lmm2024/sar-adc-8b-open/sar-adc/comparator/offset_mc.png

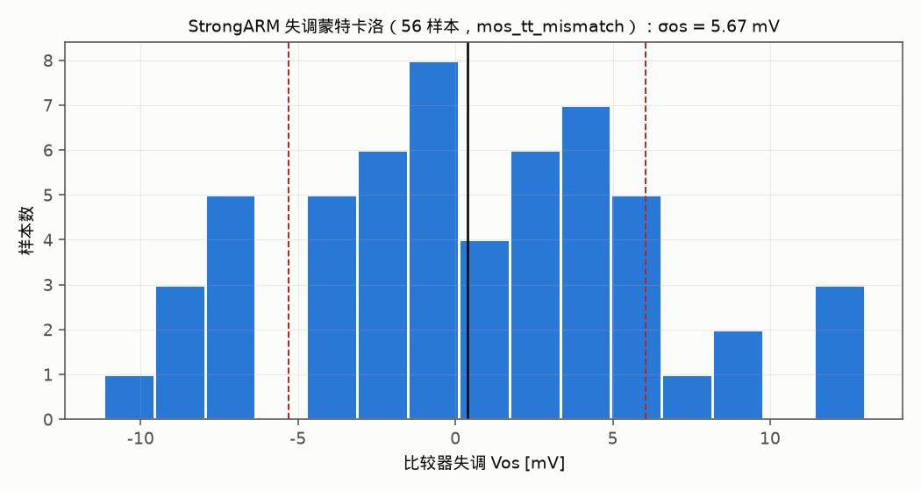
sar-adc/comparator/offset_mc.png
