lmm2024/sar-adc-8b-open/sar-adc/comparator/sar_convergence.png

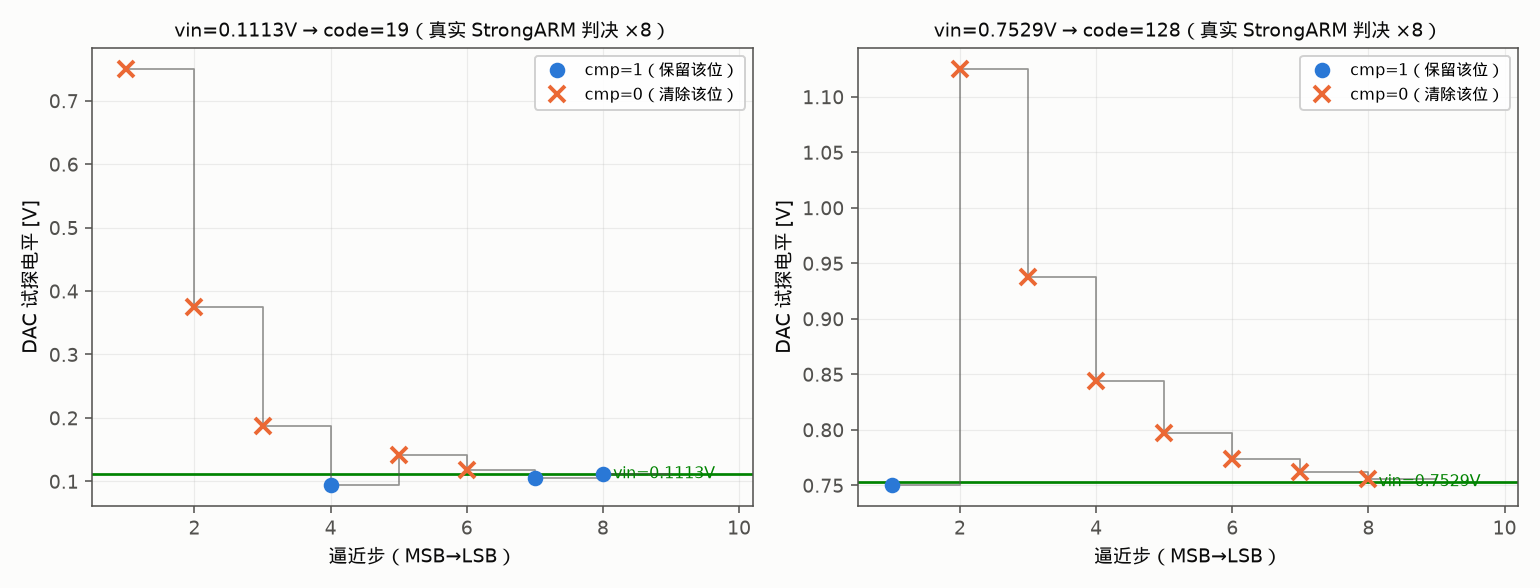
sar-adc/comparator/sar_convergence.png
