lmm2024/sar-adc-8b-open/sar-adc/comparator/strongarm_tran.png

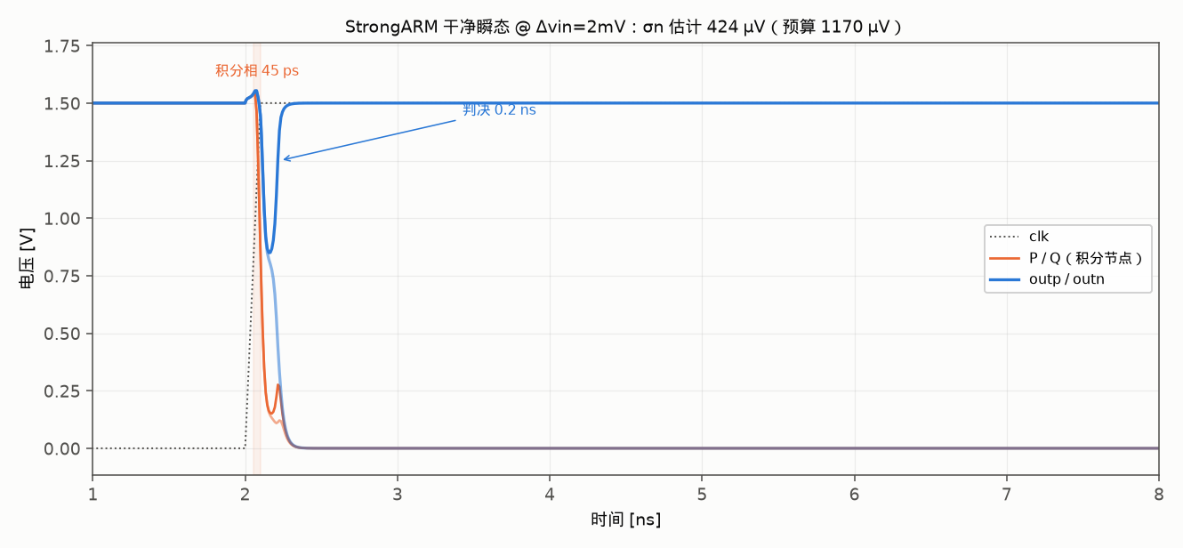
sar-adc/comparator/strongarm_tran.png
