lmm2024/sar-adc-8b-open/sar-adc/core/core_conversion.png

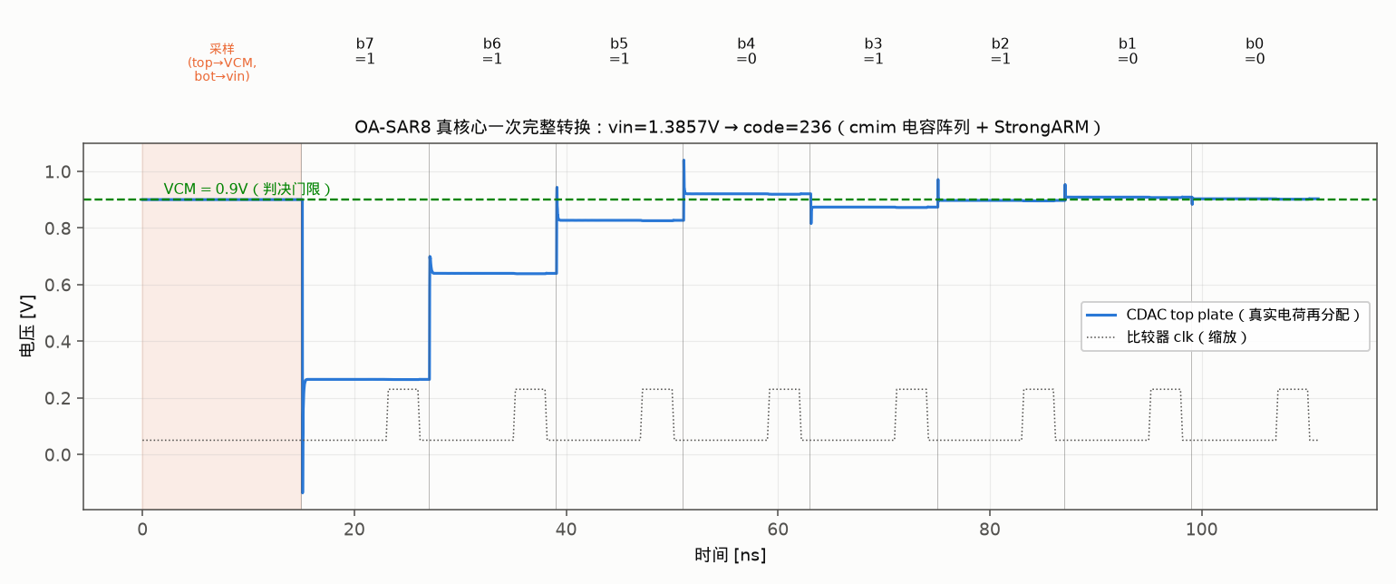
sar-adc/core/core_conversion.png
