lmm2024/sar-adc-8b-open/sar-adc/layout/bs/bstrap.png

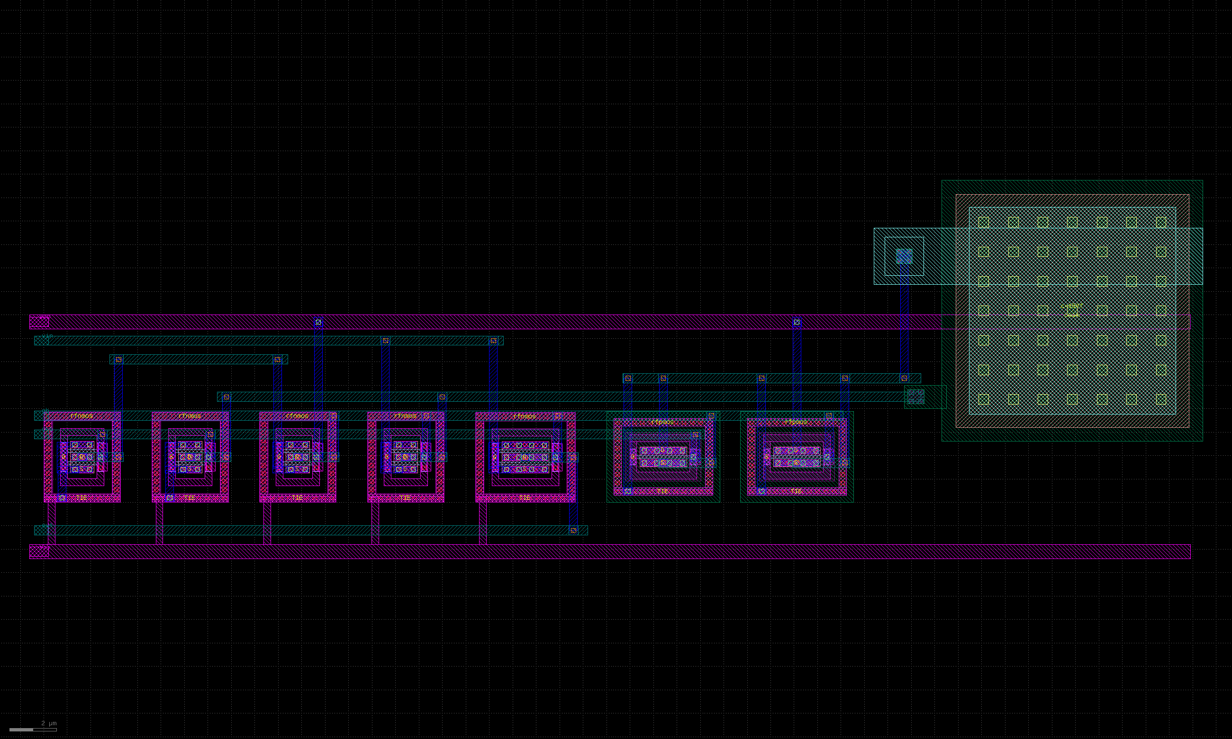
sar-adc/layout/bs/bstrap.png
