lmm2024/sar-adc-8b-open/sar-adc/layout/cdac_array.png

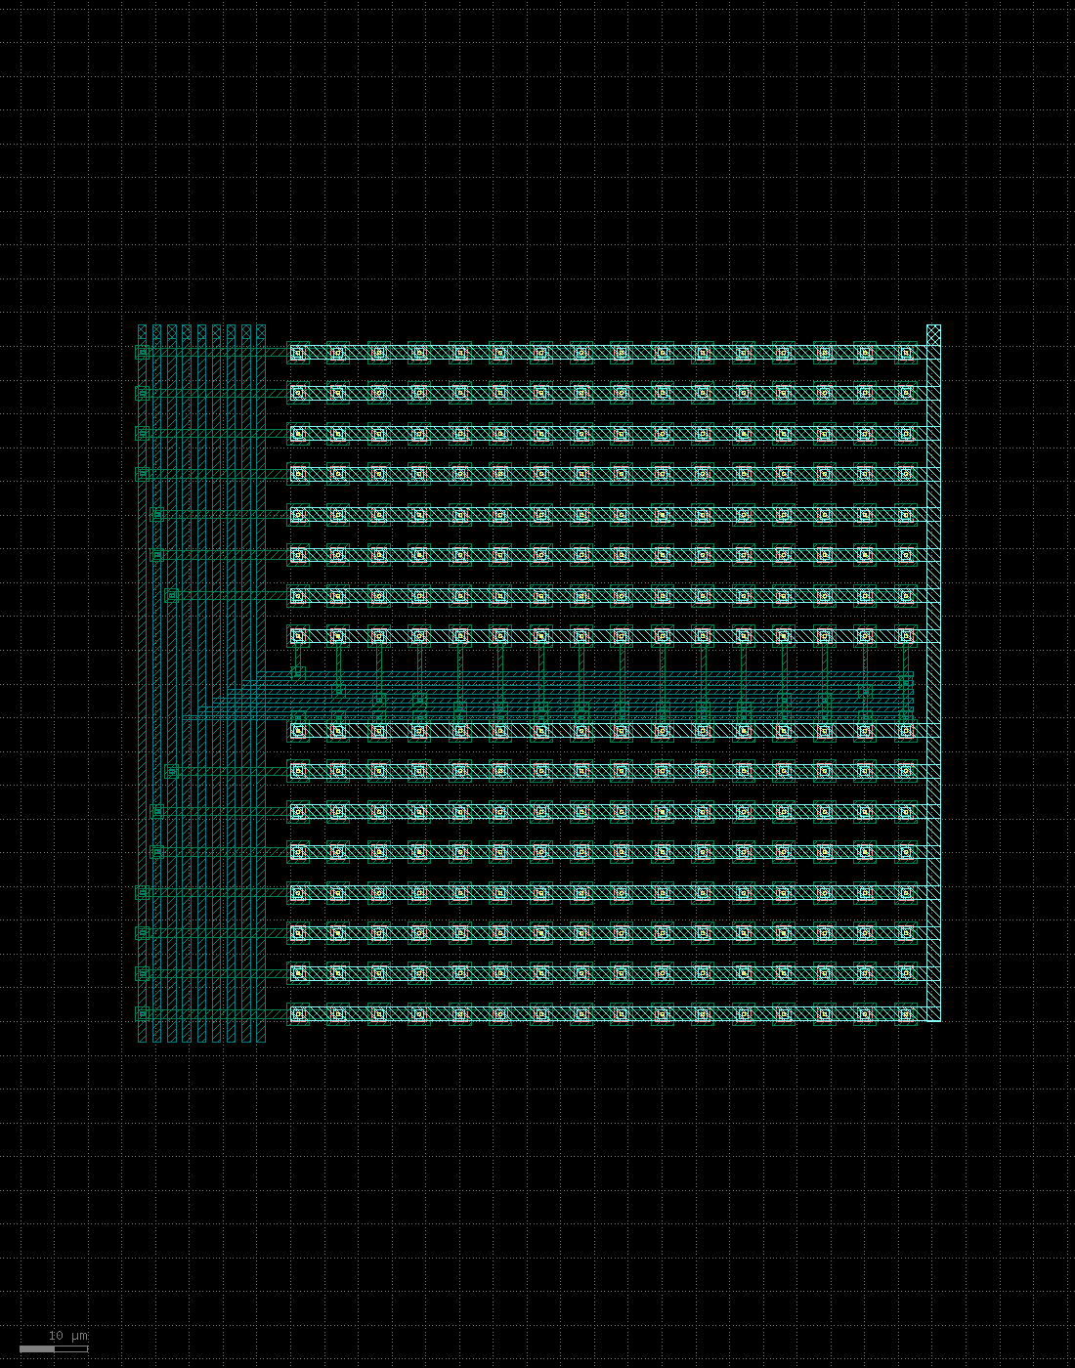
sar-adc/layout/cdac_array.png
