lmm2024/sar-adc-8b-open/sar-adc/layout/channel_zoom.png

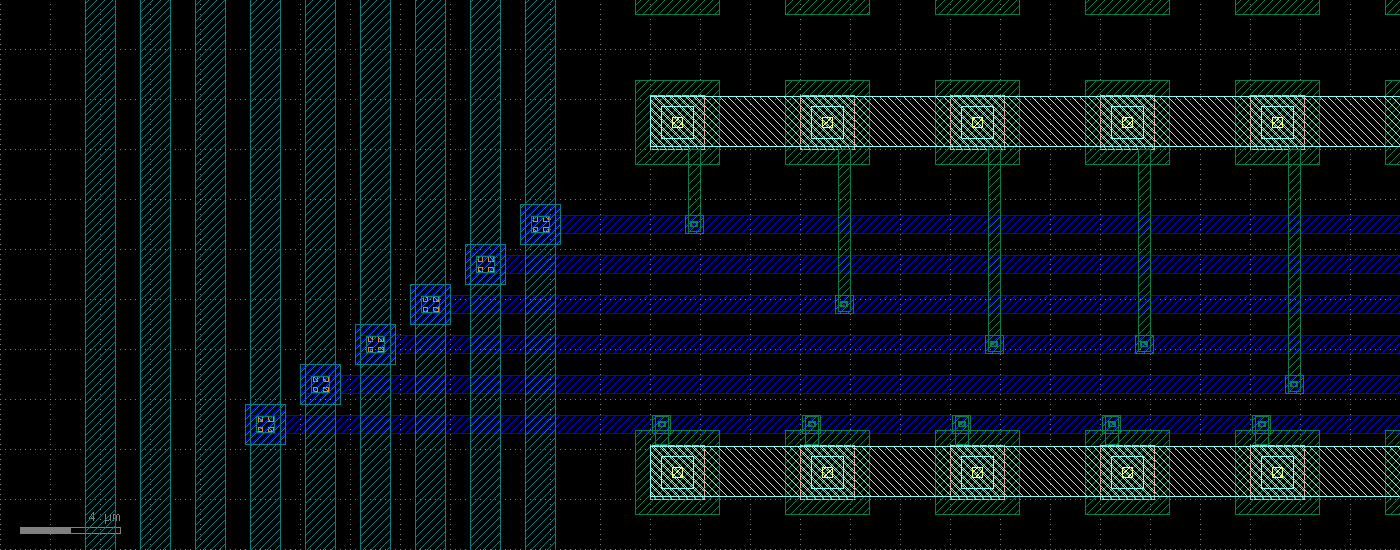
sar-adc/layout/channel_zoom.png
