lmm2024/sar-adc-8b-open/sar-adc/layout/cmp/sa_comp_final.png

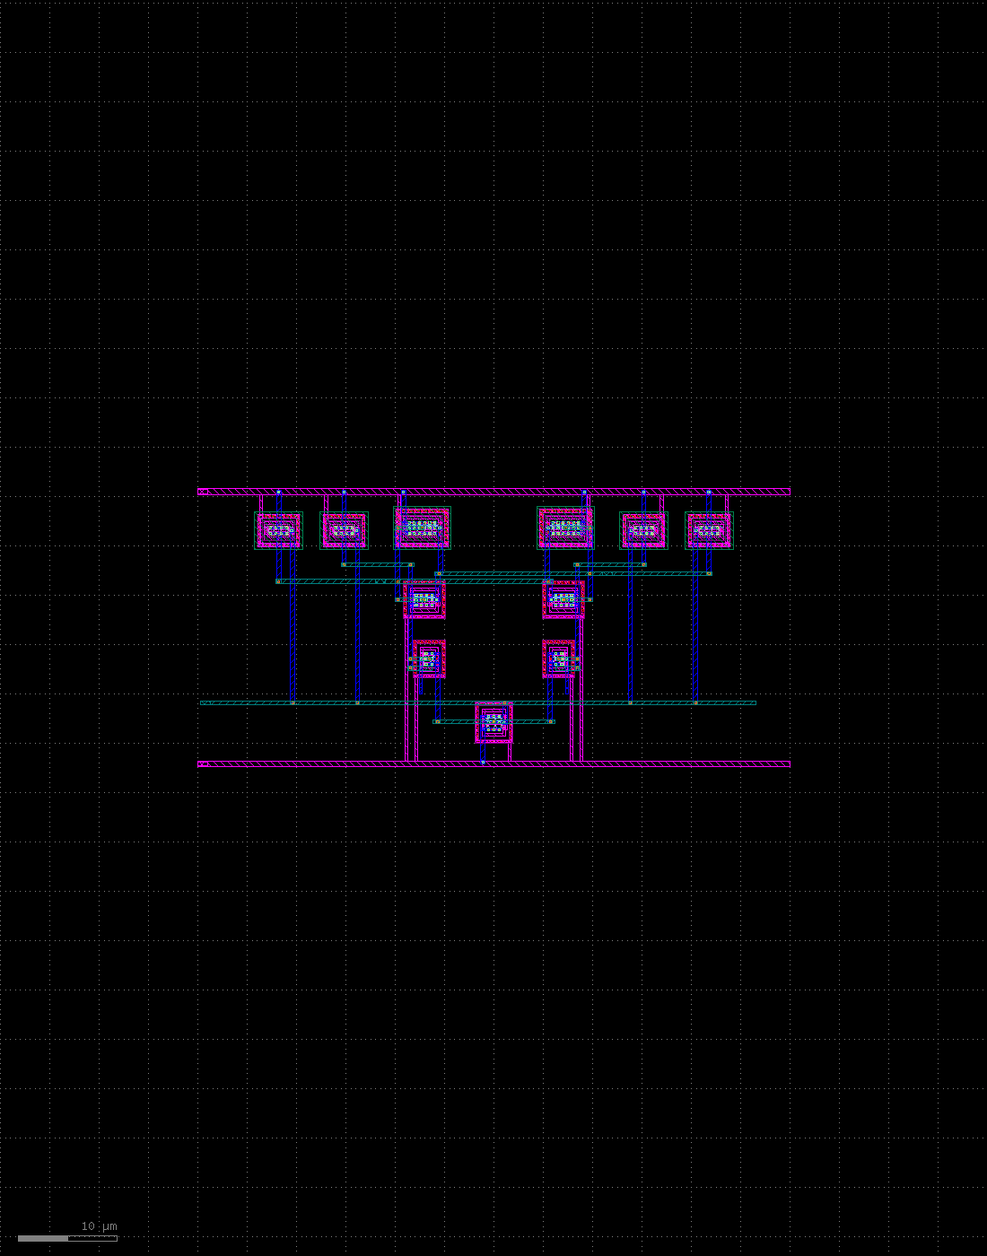
sar-adc/layout/cmp/sa_comp_final.png
