lmm2024/sar-adc-8b-open/sar-adc/layout/oa_sar8_core9.png

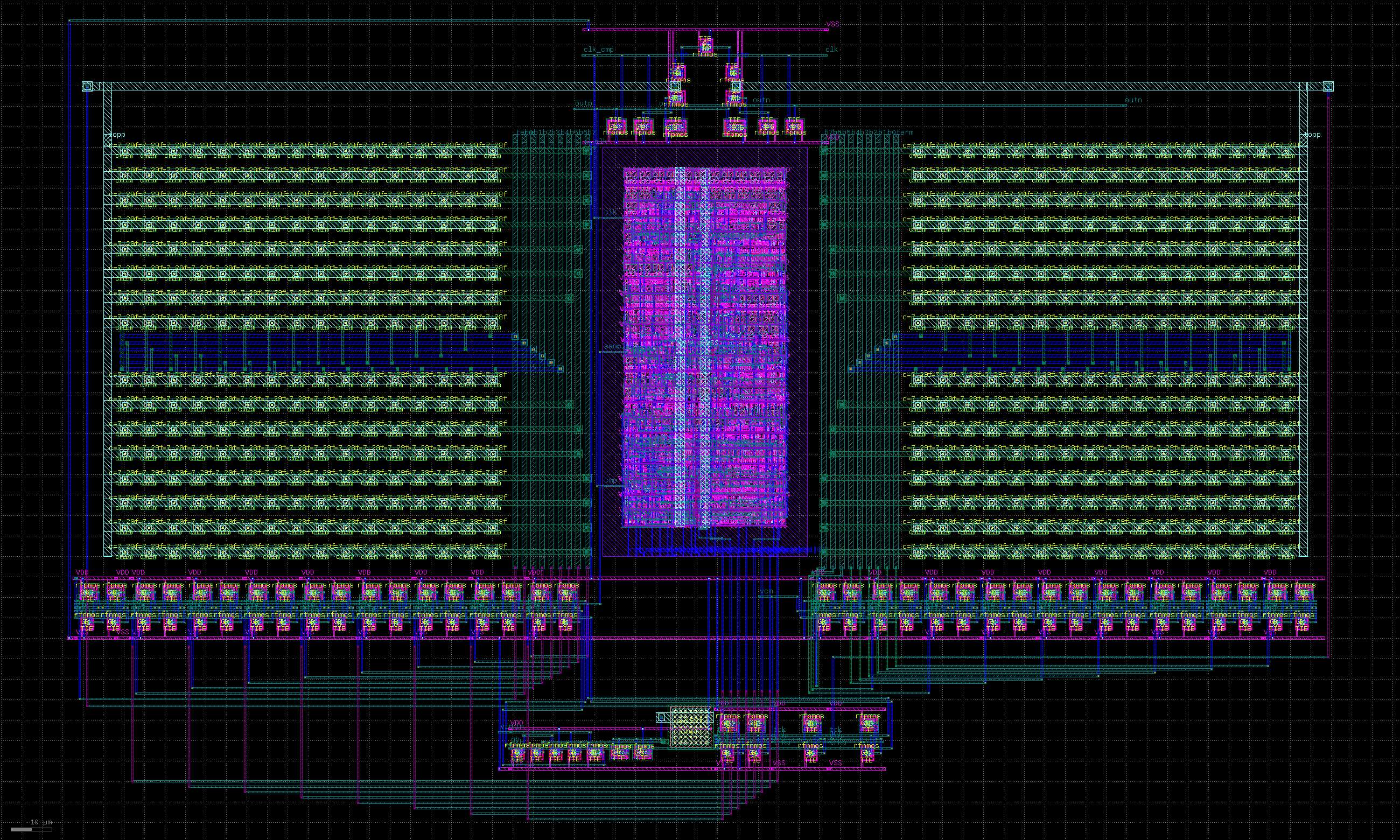
sar-adc/layout/oa_sar8_core9.png
