lmm2024/sar-adc-8b-open/sar-adc/layout/oa_sar8_core_fp.png

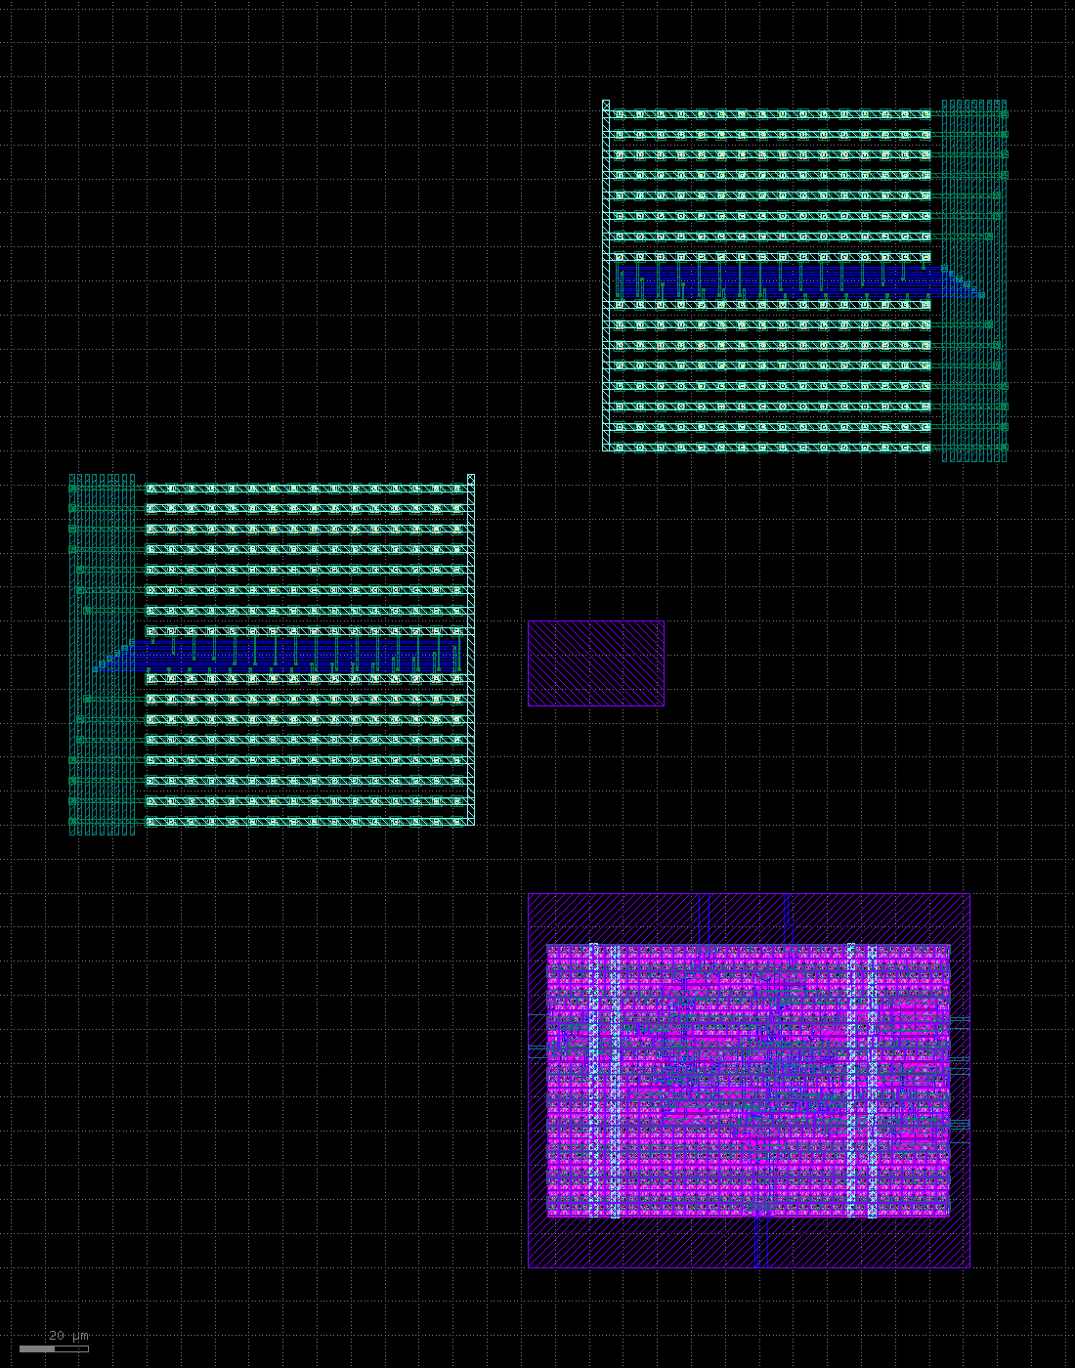
sar-adc/layout/oa_sar8_core_fp.png
