lmm2024/sar-adc-8b-open/sar-adc/layout/oa_sar8_core_v3.png

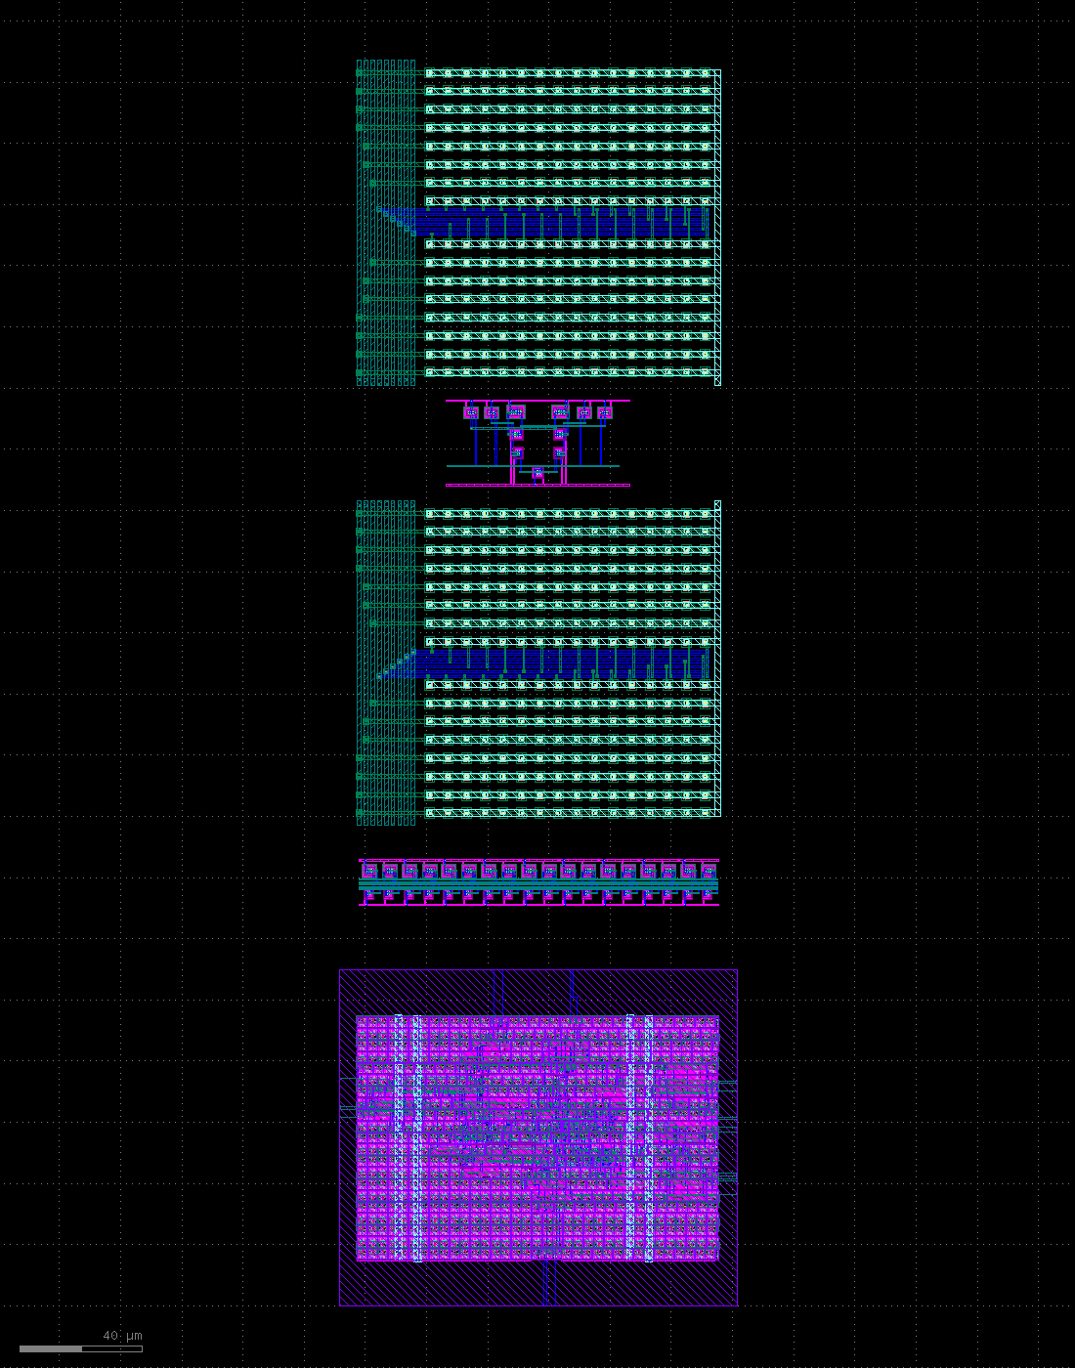
sar-adc/layout/oa_sar8_core_v3.png
