lmm2024/sar-adc-8b-open/sar-adc/layout/sar_ctrl_macro.png

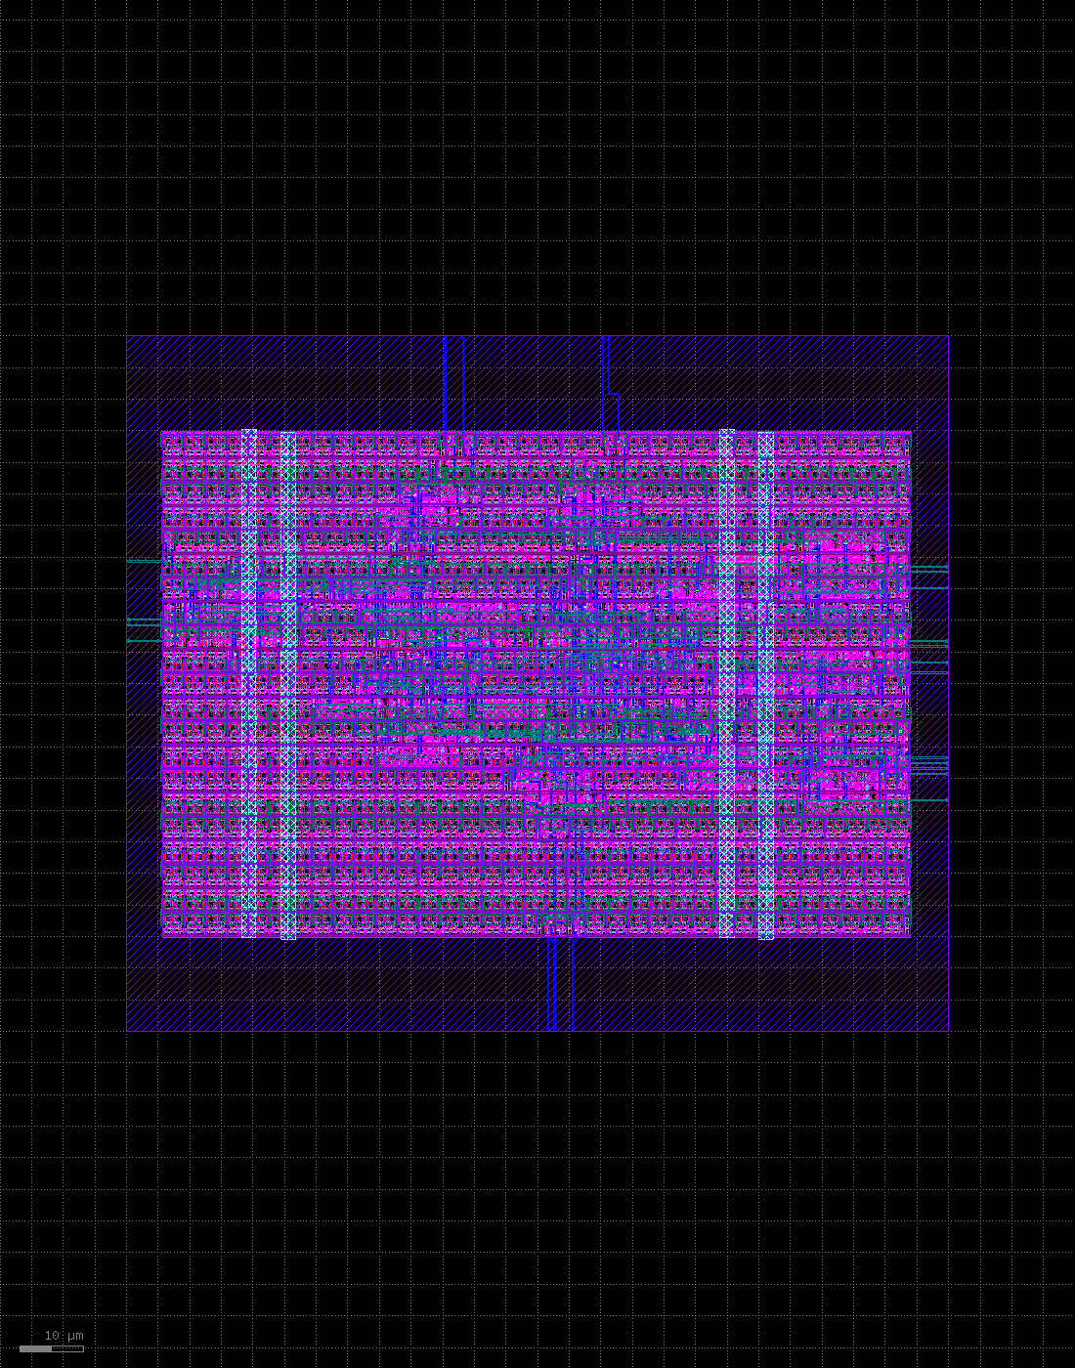
sar-adc/layout/sar_ctrl_macro.png
