lmm2024/sar-adc-8b-open/sar-adc/logic/final/render/sar_ctrl.png

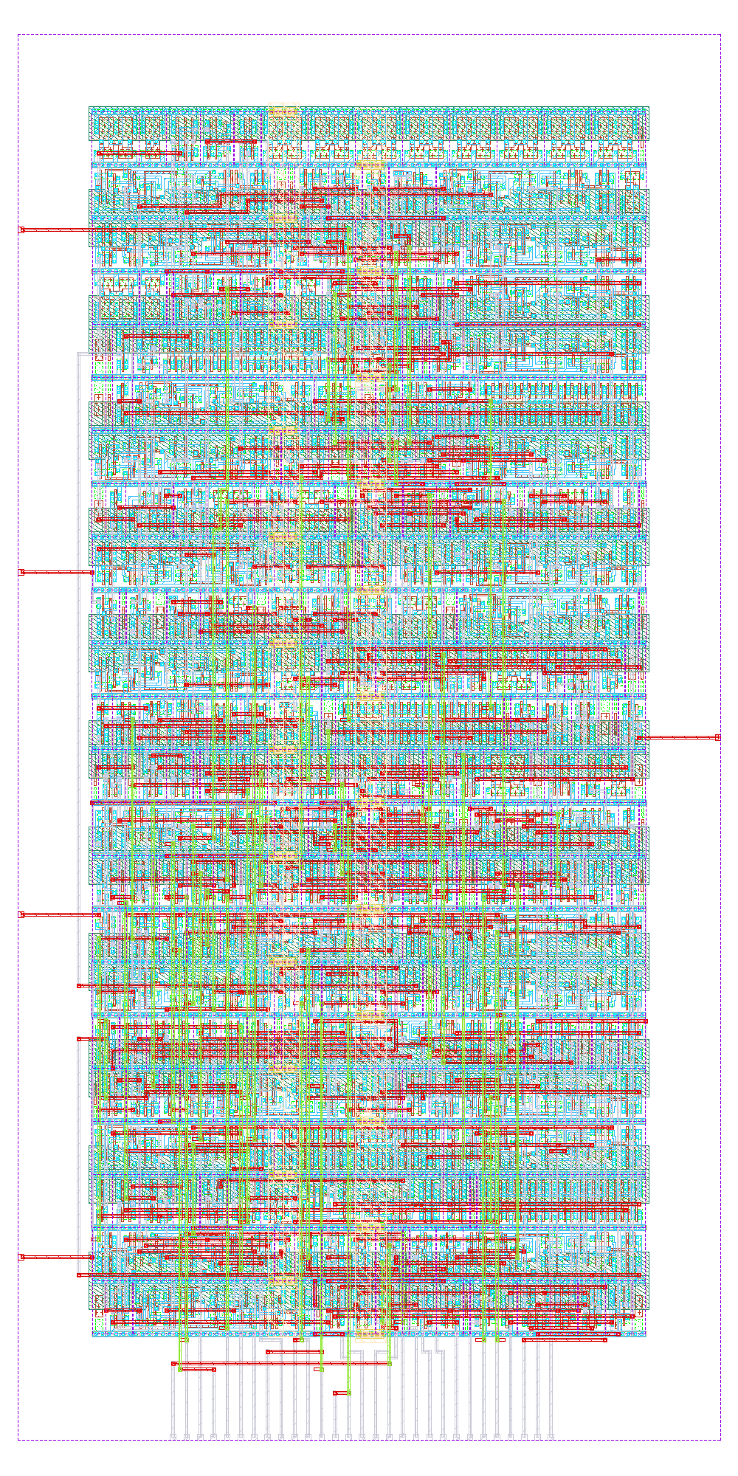
sar-adc/logic/final/render/sar_ctrl.png
