lmm2024/sar-adc-8b-open/sar-adc/logic/final_async_phys/render/sar_ctrl_async_phys.png

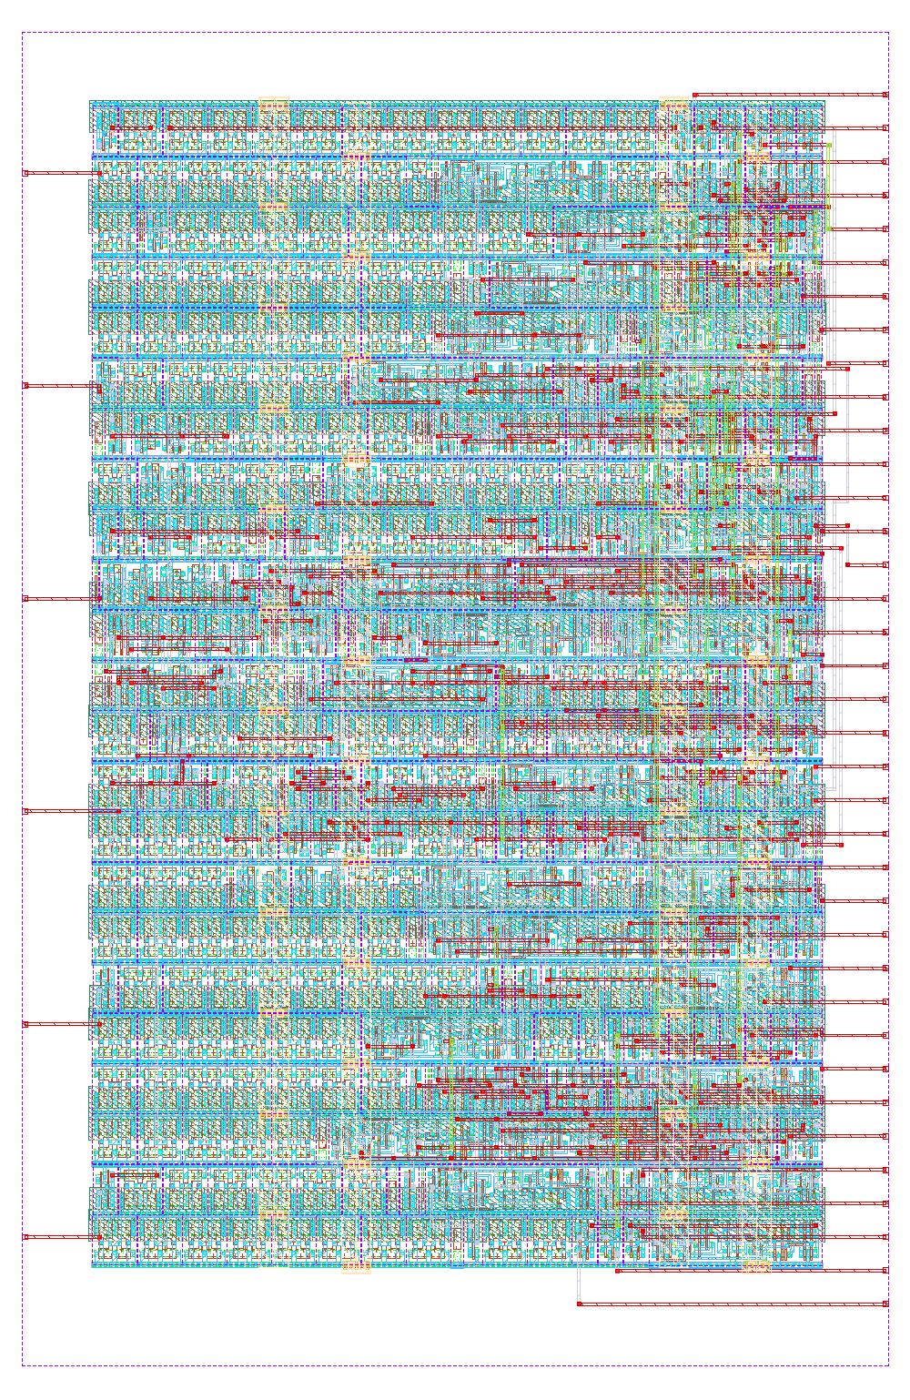
sar-adc/logic/final_async_phys/render/sar_ctrl_async_phys.png
