lmm2024/sar-adc-8b-open/sar-adc/logic/runs/RUN_2026-08-20_POSTDAC_PENDING/final/render/sar_ctrl_async_phys.png

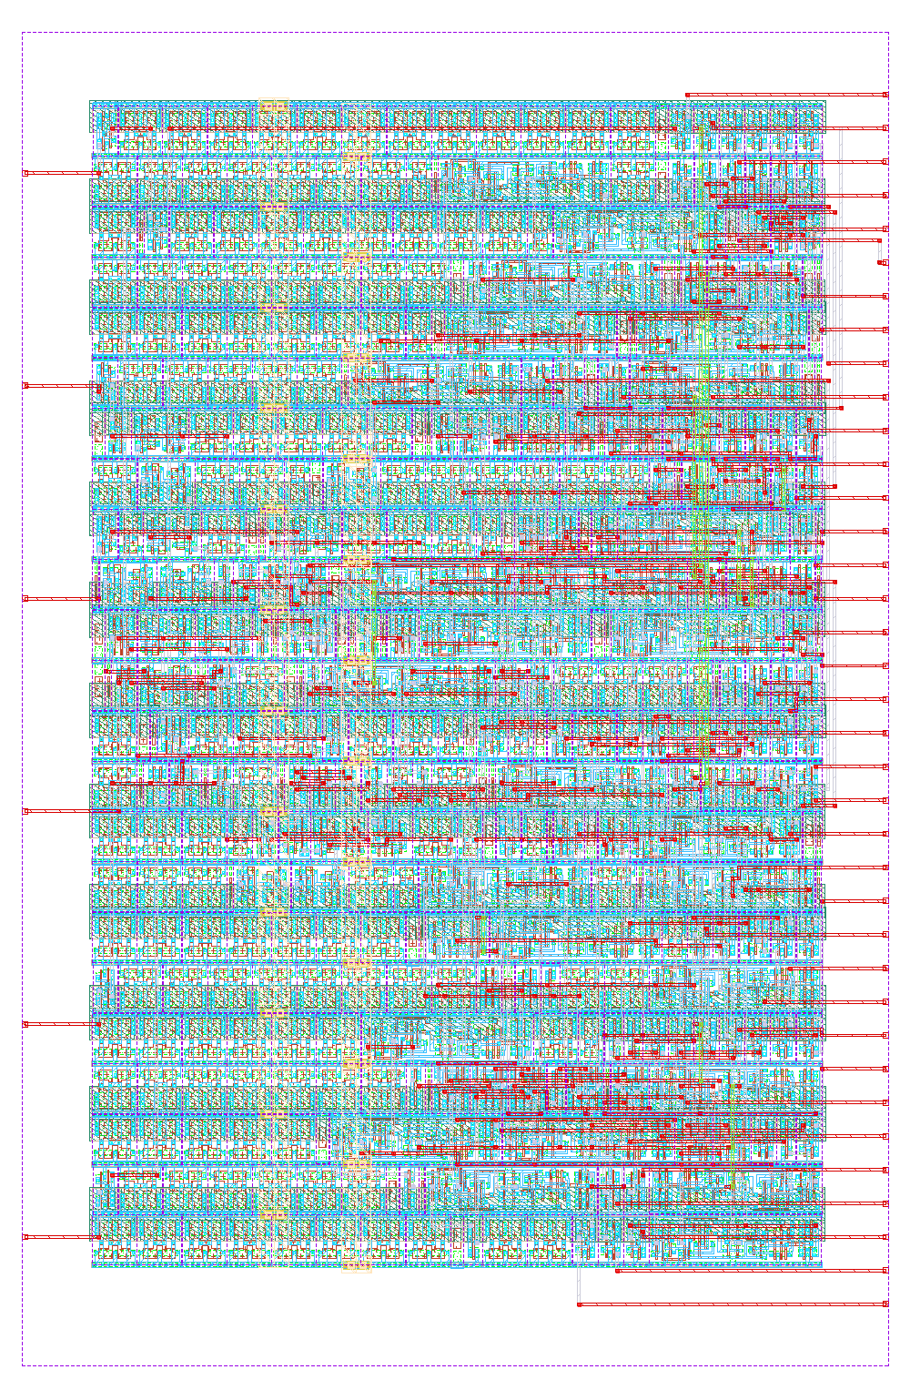
sar-adc/logic/runs/RUN_2026-08-20_POSTDAC_PENDING/final/render/sar_ctrl_async_phys.png
