lmm2024/sar-adc-8b-open/sar-adc/model/dynamic_enob.png

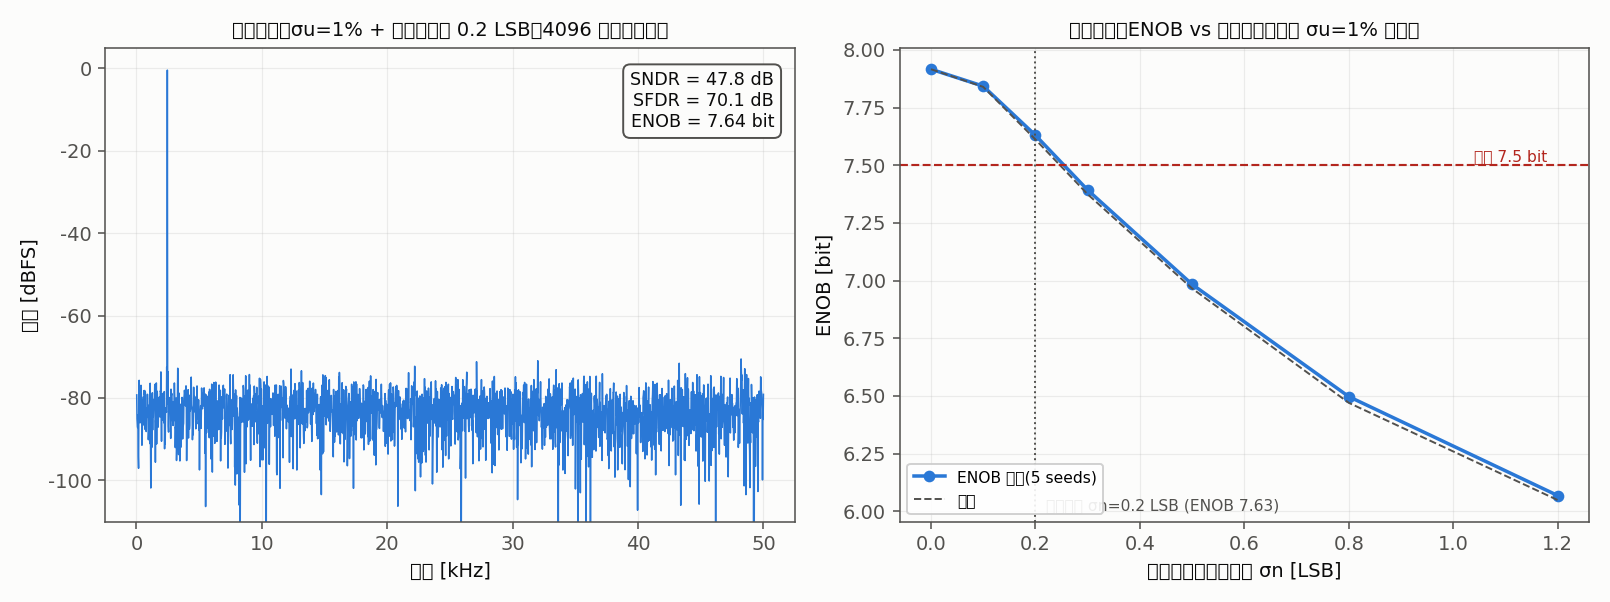
sar-adc/model/dynamic_enob.png
