lmm2024/sar-adc-8b-open/sar-adc/model/mc_inl.png

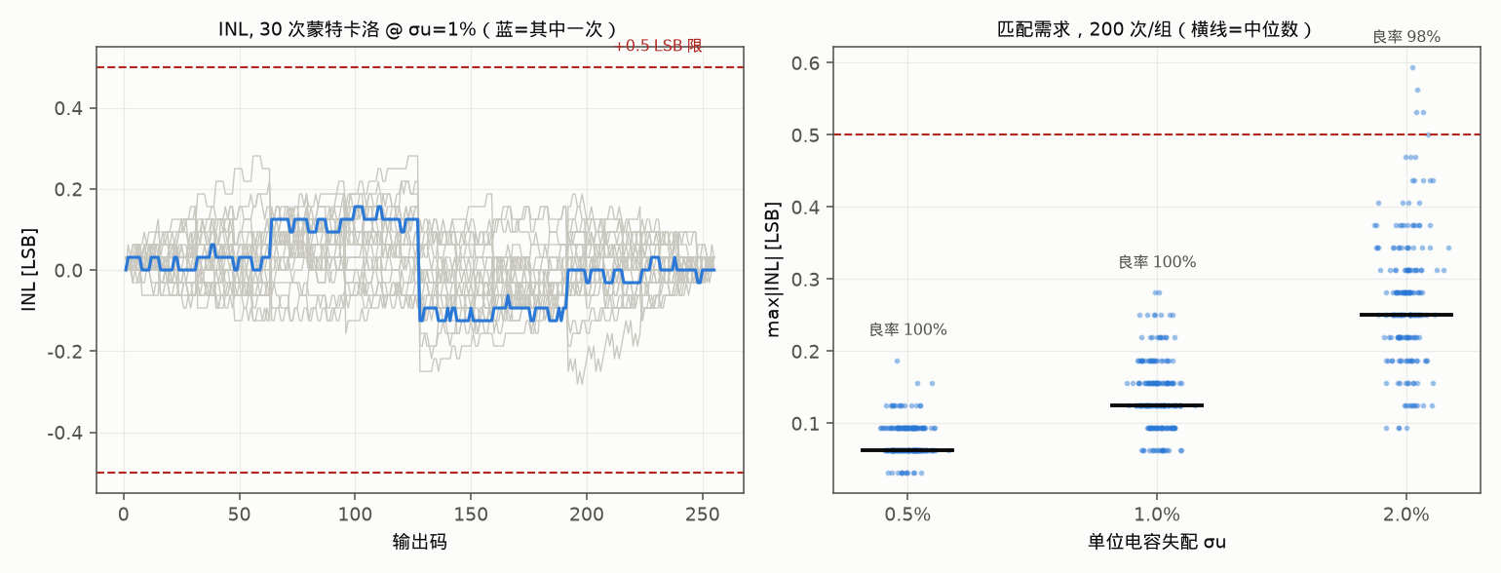
sar-adc/model/mc_inl.png
