lmm2024/sar-adc-8b-open/sar-adc/report/img/01_cdac_array.png

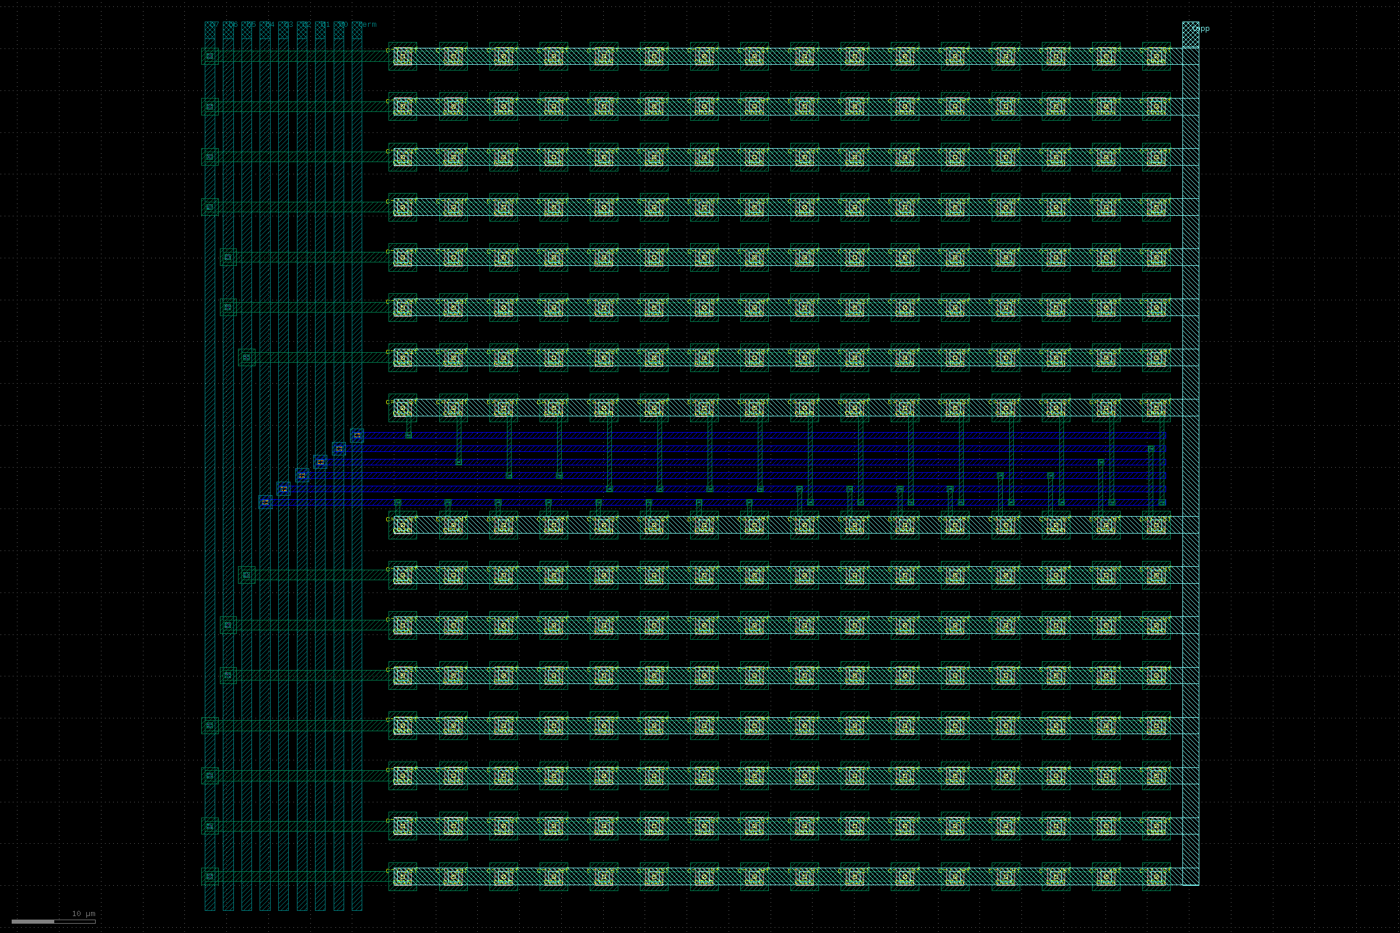
sar-adc/report/img/01_cdac_array.png
