lmm2024/sar-adc-8b-open/sar-adc/report/img/02_comparator.png

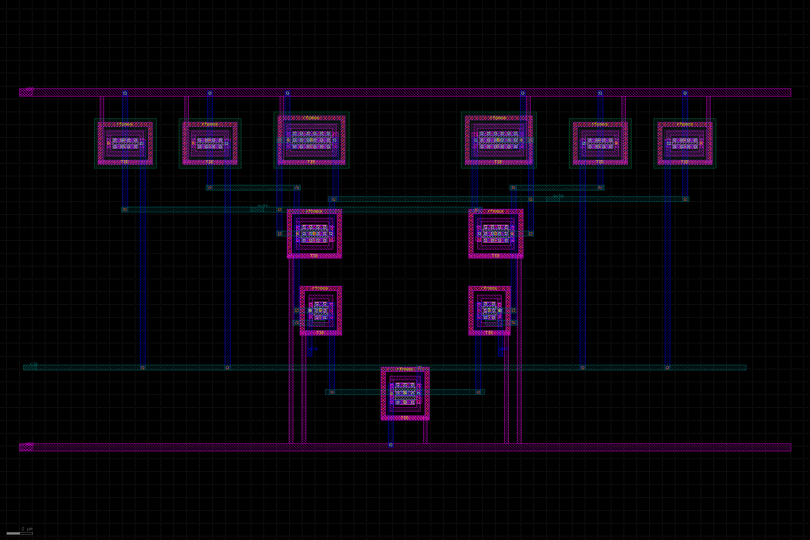
sar-adc/report/img/02_comparator.png
