lmm2024/sar-adc-8b-open/sar-adc/report/img/03_switch_bitcell.png

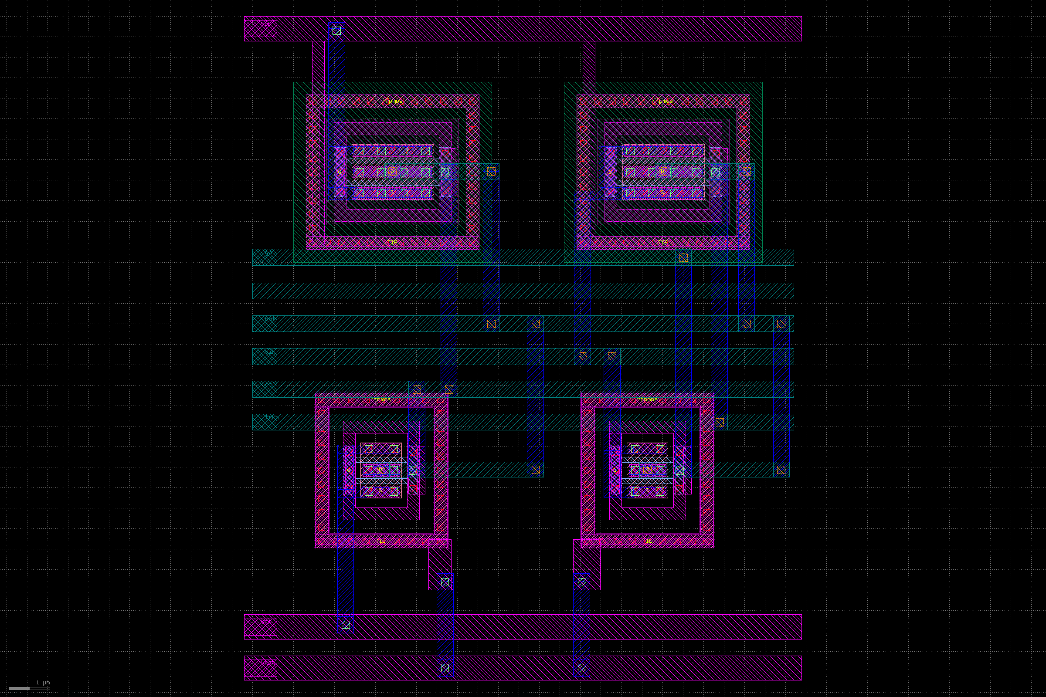
sar-adc/report/img/03_switch_bitcell.png
