lmm2024/sar-adc-8b-open/sar-adc/report/img/04_switch_tg.png

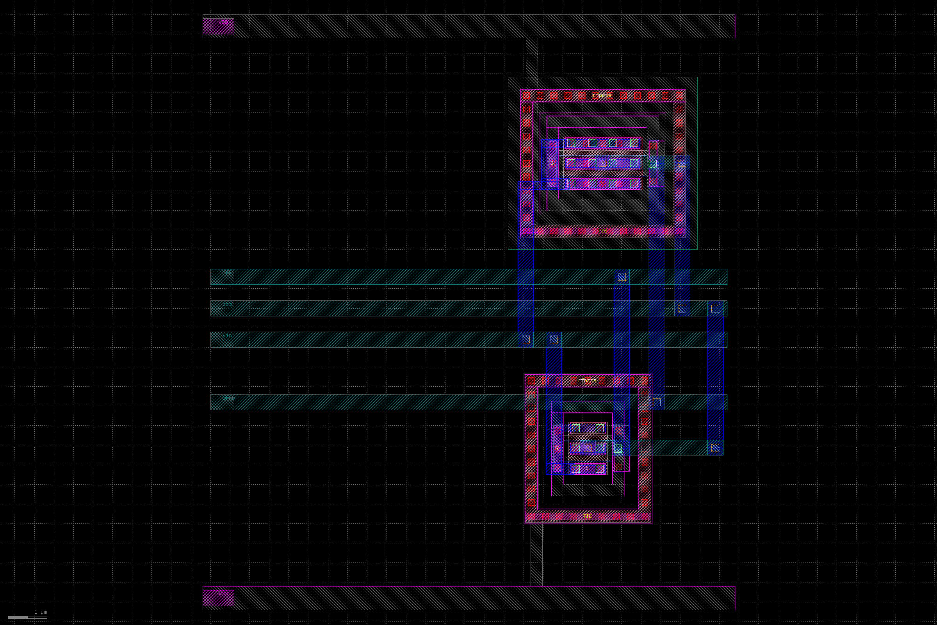
sar-adc/report/img/04_switch_tg.png
