lmm2024/sar-adc-8b-open/sar-adc/report/img/05_bootstrap.png

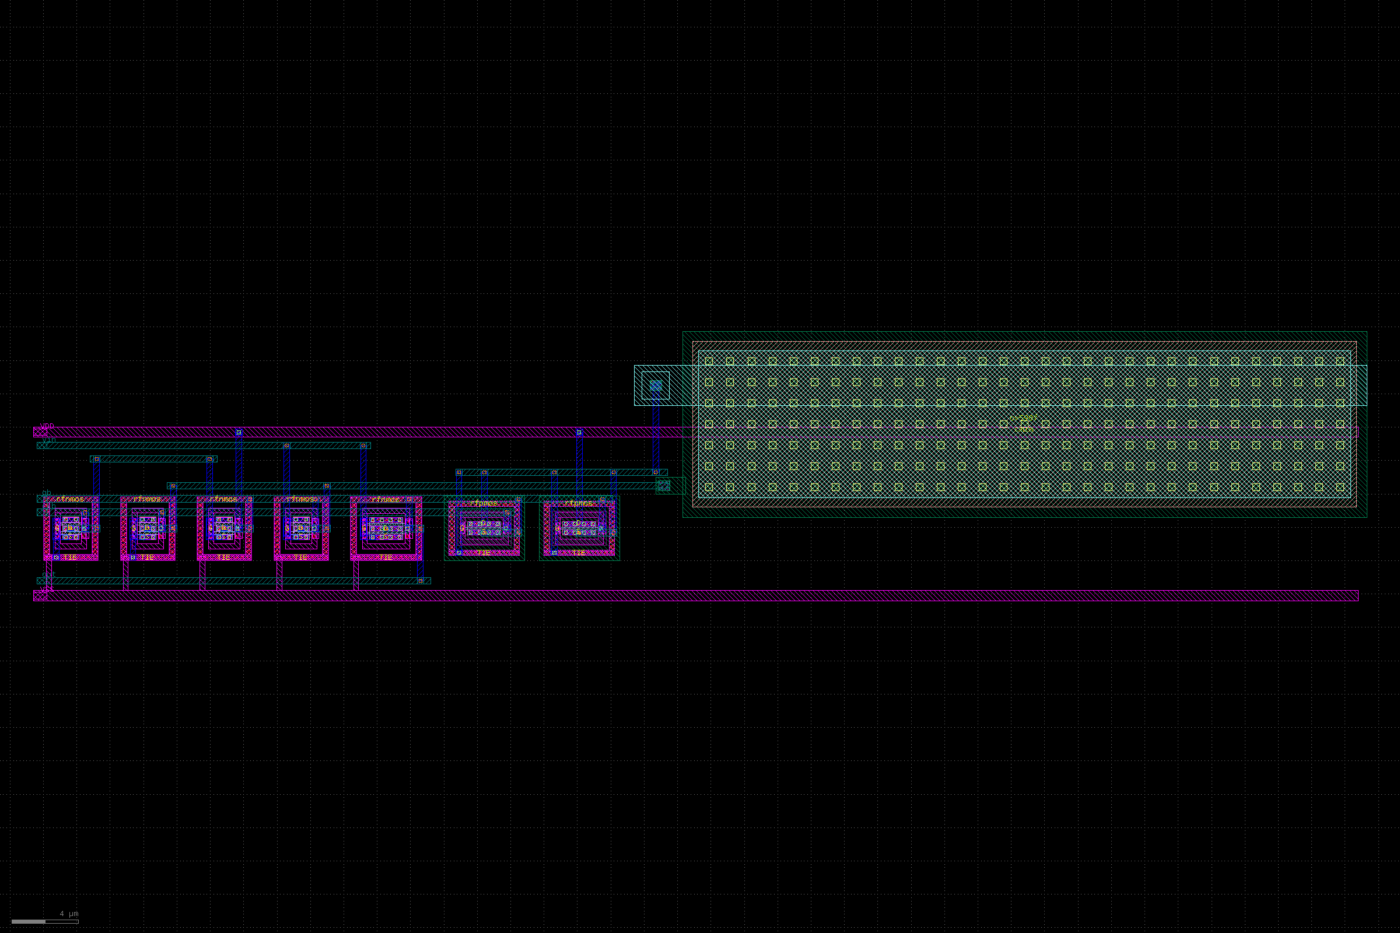
sar-adc/report/img/05_bootstrap.png
