lmm2024/sar-adc-8b-open/sar-adc/report/img/06_sar_logic.png

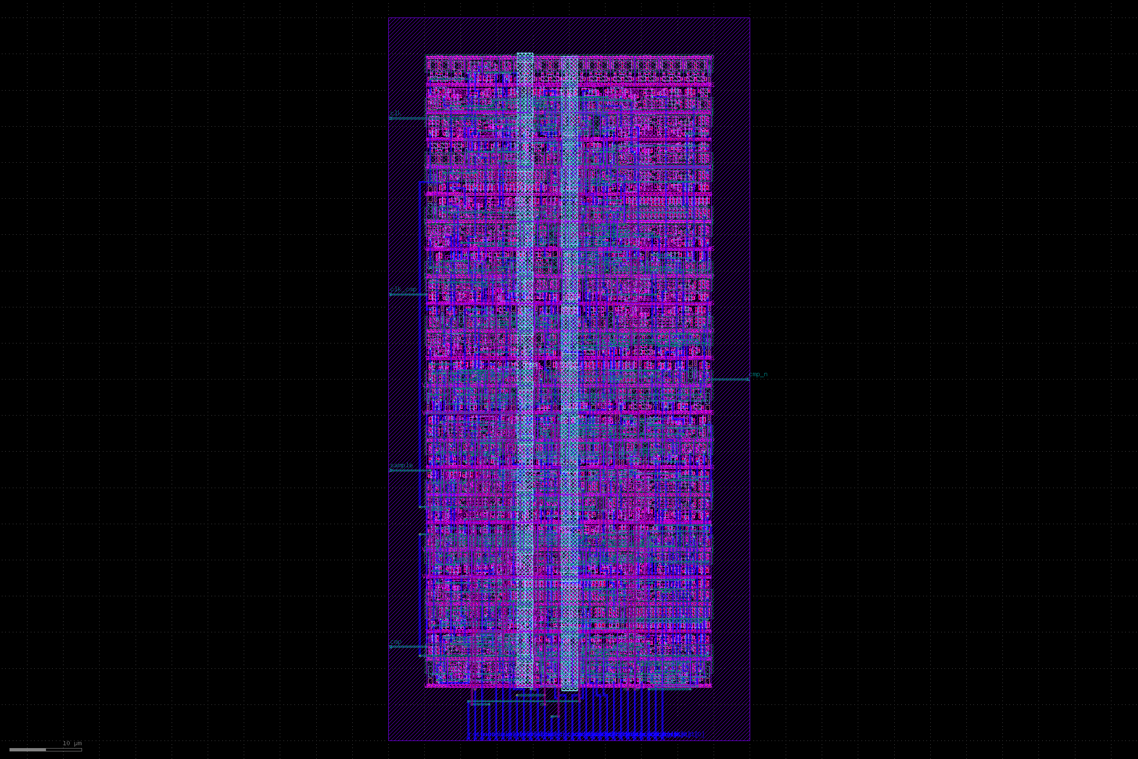
sar-adc/report/img/06_sar_logic.png
