lmm2024/sar-adc-8b-open/sar-adc/report/img/07_analog_core.png

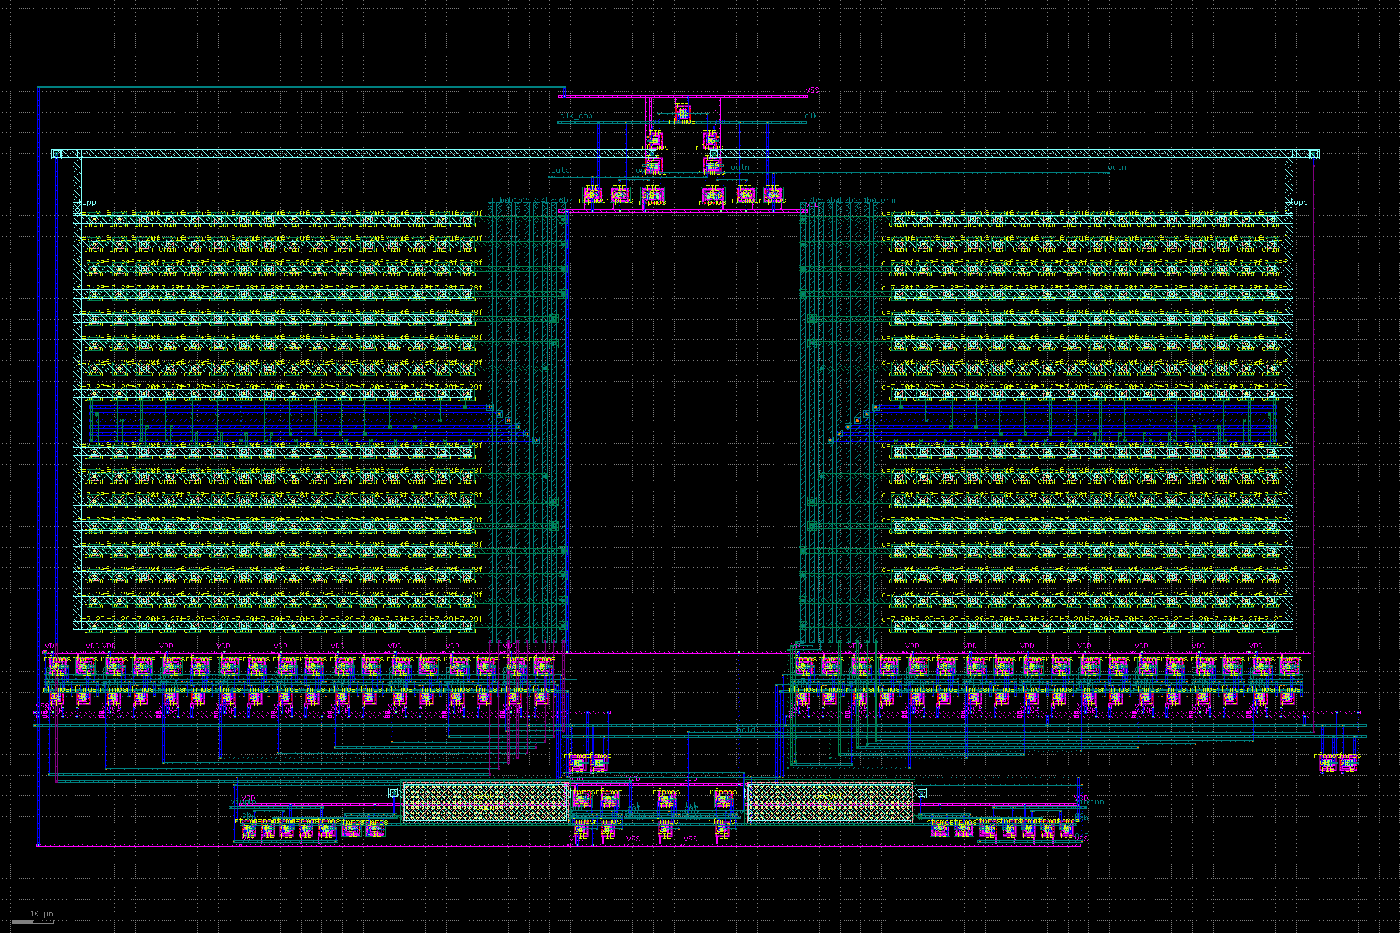
sar-adc/report/img/07_analog_core.png
