lmm2024/sar-adc-8b-open/sar-adc/report/img/08_full_core.png

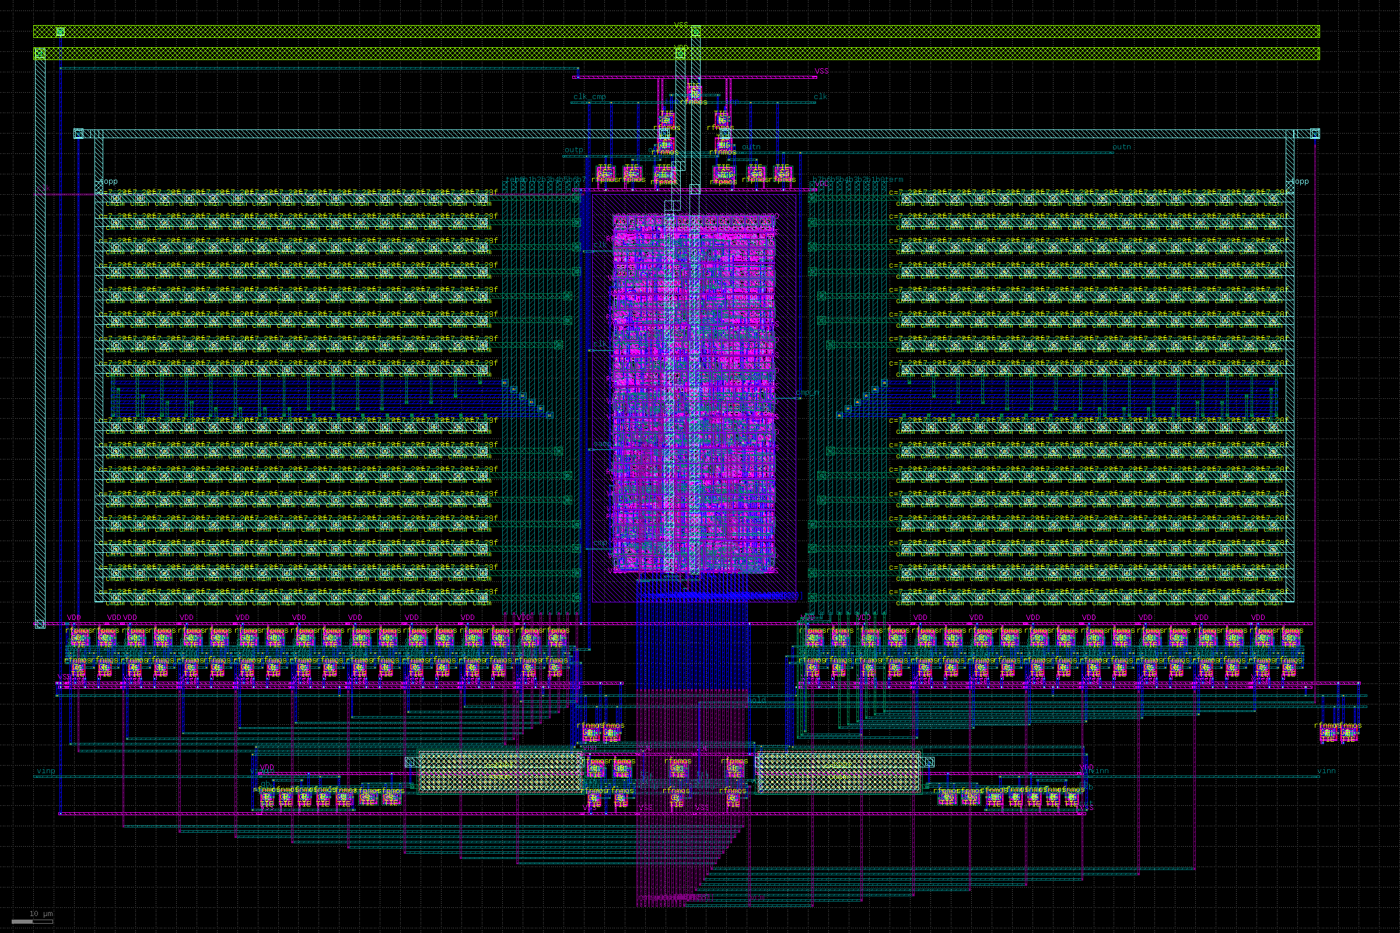
sar-adc/report/img/08_full_core.png
