lmm2024/sar-adc-8b-open/sar-adc/report/img/09_full_chip.png

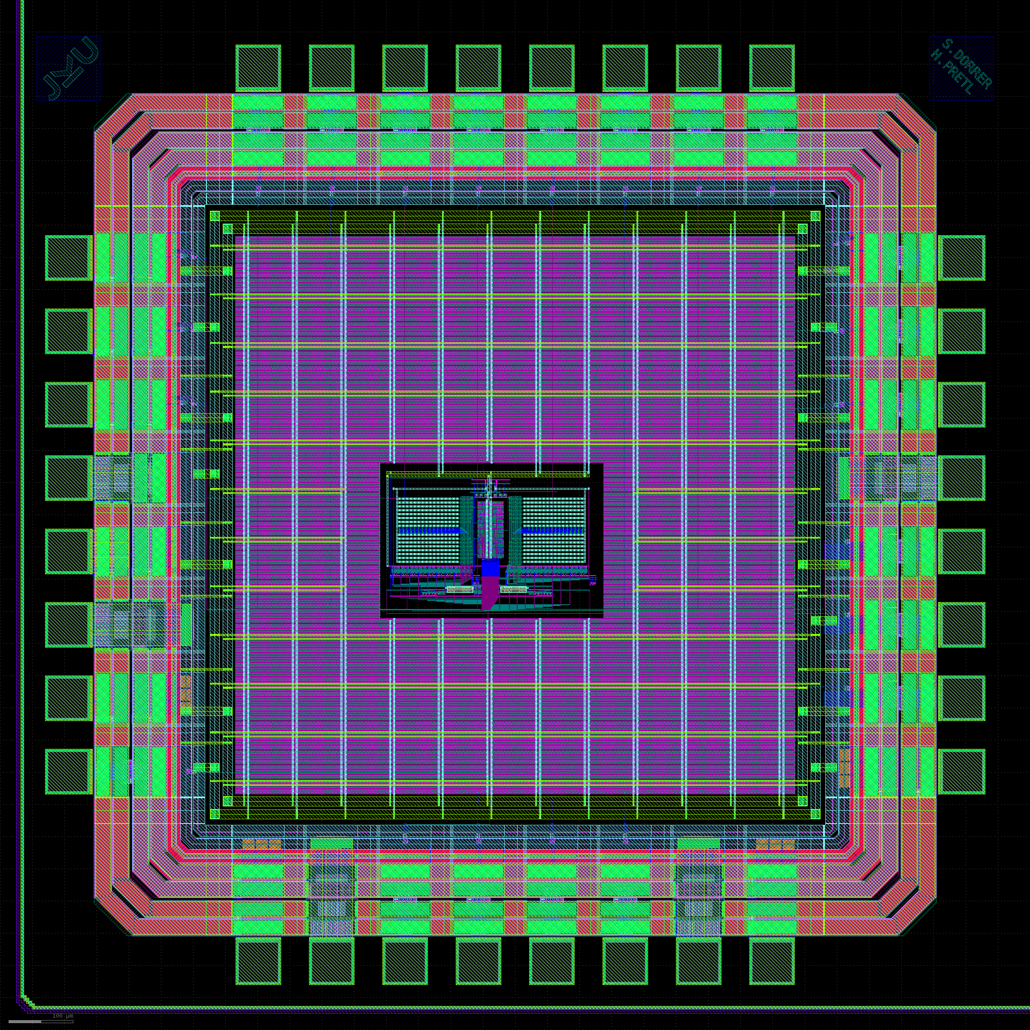
sar-adc/report/img/09_full_chip.png
