lmm2024/sar-adc-8b-open/sar-adc/report/img/10_full_chip_core_zoom.png

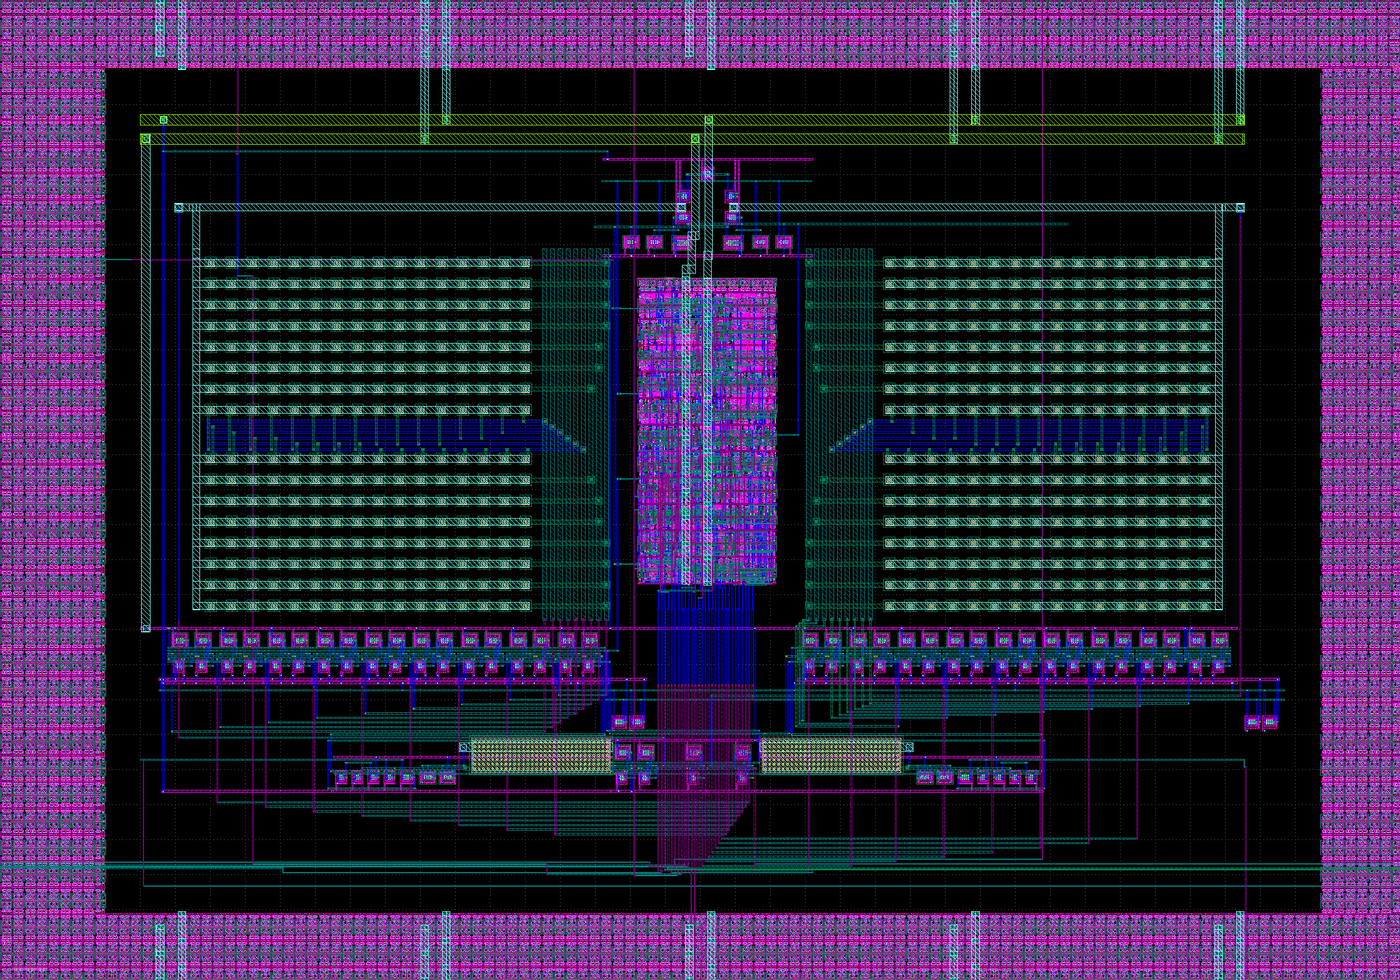
sar-adc/report/img/10_full_chip_core_zoom.png
