lmm2024/sar-adc-8b-open/sar-adc/report/img/11_full_chip_corner_pads.png

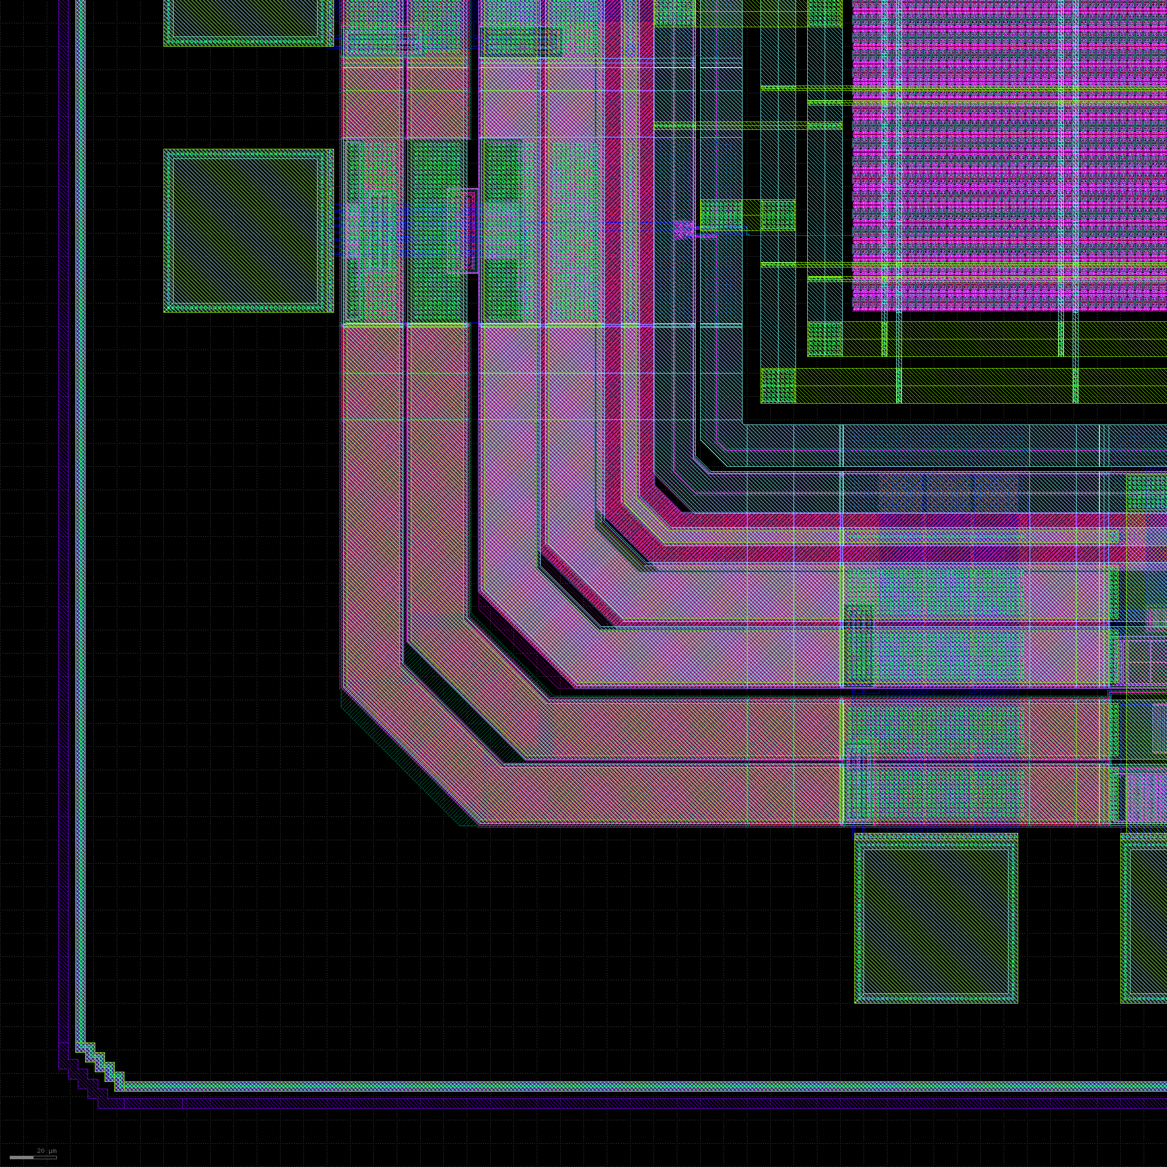
sar-adc/report/img/11_full_chip_corner_pads.png
