lmm2024/sar-adc-8b-open/sar-adc/signoff/core18_pdnfix_20260830/results/samples_pdnfix_m3_lowfreq312k_2cyc.csv

sample | code | track_fall_s | done_rise_s | conversion_ns
0 | 137 | 3.1075e-08 | 6.561811372032166e-08 | 34.543113720321664
1 | 160 | 1.31075e-07 | 1.6552152965079178e-07 | 34.446529650791774
