lmm2024/sar-adc-8b-open/sar-adc/signoff/core18_pdnfix_20260830/results/samples_dc257.csv

index | vdiff_v | code | conversion_ns | best_fit_residual_lsb
0 | -1.4 | 11 | 34.445106392 | 0.857750429825
1 | -1.3890625 | 11 | 34.6363286039 | -0.0826204924894
2 | -1.378125 | 12 | 34.2929404259 | -0.0229914148041
3 | -1.3671875 | 13 | 34.5014485246 | 0.0366376628811
4 | -1.35625 | 14 | 34.4431196337 | 0.0962667405664
5 | -1.3453125 | 15 | 34.3054550637 | 0.155895818252
6 | -1.334375 | 16 | 34.3947405658 | 0.215524895937
7 | -1.3234375 | 17 | 34.342366373 | 0.275153973622
8 | -1.3125 | 18 | 34.3886971842 | 0.334783051308
9 | -1.3015625 | 19 | 34.3889060727 | 0.394412128993
10 | -1.290625 | 20 | 34.4885205702 | 0.454041206678
11 | -1.2796875 | 21 | 34.5897467361 | 0.513670284363
12 | -1.26875 | 22 | 34.4448429624 | 0.573299362049
13 | -1.2578125 | 23 | 34.4942451069 | 0.632928439734
14 | -1.246875 | 24 | 34.3728353923 | 0.692557517419
15 | -1.2359375 | 24 | 34.4381811155 | -0.247813404896
16 | -1.225 | 25 | 34.4939537219 | -0.18818432721
17 | -1.2140625 | 27 | 34.5913504623 | 0.871444750475
18 | -1.203125 | 28 | 34.6906325925 | 0.93107382816
19 | -1.1921875 | 28 | 34.3967779499 | -0.00929709415442
20 | -1.18125 | 29 | 34.6292464781 | 0.0503319835309
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
