lmm2024/sar-adc-8b-open/sar-adc/signoff/core18_pdnfix_20260830/results/samples_pdnfix_m3_signoff32_10m_t25.csv

sample | code | track_fall_s | done_rise_s | conversion_ns
0 | 218 | 3.1075e-08 | 6.567269204133229e-08 | 34.59769204133229
1 | 60 | 1.31075e-07 | 1.6548573866181128e-07 | 34.41073866181128
2 | 181 | 2.31075e-07 | 2.657075510403968e-07 | 34.63255104039683
3 | 103 | 3.31075e-07 | 3.6587253929055536e-07 | 34.79753929055537
4 | 135 | 4.31075e-07 | 4.6571673966560034e-07 | 34.64173966560035
5 | 149 | 5.31075e-07 | 5.657167529386895e-07 | 34.64175293868943
6 | 89 | 6.31075e-07 | 6.657762380757698e-07 | 34.70123807576975
7 | 193 | 7.31075e-07 | 7.655211186032955e-07 | 34.44611860329545
8 | 49 | 8.31075e-07 | 8.656154608521478e-07 | 34.540460852147824
9 | 227 | 9.31075e-07 | 9.65817253785305e-07 | 34.74225378530492
10 | 22 | 1.0310750000000001e-06 | 1.0655656300984808e-06 | 34.49063009848065
11 | 247 | 1.131075e-06 | 1.1656058732982178e-06 | 34.53087329821777
12 | 11 | 1.2310750000000001e-06 | 1.265433782139987e-06 | 34.35878213998683
13 | 249 | 1.331075e-06 | 1.3654700665056138e-06 | 34.395066505613805
14 | 18 | 1.431075e-06 | 1.465564302163999e-06 | 34.489302163998914
15 | 233 | 1.531075e-06 | 1.5655696592732076e-06 | 34.49465927320757
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
