lmm2024/sar-adc-8b-open/sar-adc/signoff/core18_pdnfix_20260830/results/samples_pdnfix_m3_signoff32_lowfreq312k.csv

sample | code | track_fall_s | done_rise_s | conversion_ns
0 | 137 | 3.1075e-08 | 6.561811372032166e-08 | 34.543113720321664
1 | 160 | 1.31075e-07 | 1.6552152965079178e-07 | 34.446529650791774
2 | 183 | 2.31075e-07 | 2.658883819123734e-07 | 34.8133819123734
3 | 203 | 3.31075e-07 | 3.6581346939303345e-07 | 34.73846939303346
4 | 220 | 4.31075e-07 | 4.6576429782500456e-07 | 34.68929782500458
5 | 234 | 5.31075e-07 | 5.655153346385557e-07 | 34.44033463855562
6 | 244 | 6.31075e-07 | 6.65454994331054e-07 | 34.37999433105393
7 | 250 | 7.31075e-07 | 7.654192238310245e-07 | 34.34422383102449
8 | 250 | 8.31075e-07 | 8.654576749570154e-07 | 34.38267495701539
9 | 247 | 9.31075e-07 | 9.655633664088982e-07 | 34.48836640889816
10 | 239 | 1.0310750000000001e-06 | 1.0657118376850234e-06 | 34.636837685023245
11 | 226 | 1.131075e-06 | 1.165616433200082e-06 | 34.541433200082
12 | 211 | 1.2310750000000001e-06 | 1.26581742496238e-06 | 34.742424962379786
13 | 192 | 1.331075e-06 | 1.3653207119182707e-06 | 34.24571191827068
14 | 170 | 1.431075e-06 | 1.4656895574853883e-06 | 34.61455748538824
15 | 148 | 1.531075e-06 | 1.5656170080217223e-06 | 34.54200802172234
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
