lmm2024/sar-adc-8b-open/sar-adc/signoff/core18_pdnfix_20260830/results/dc_transfer_257.png

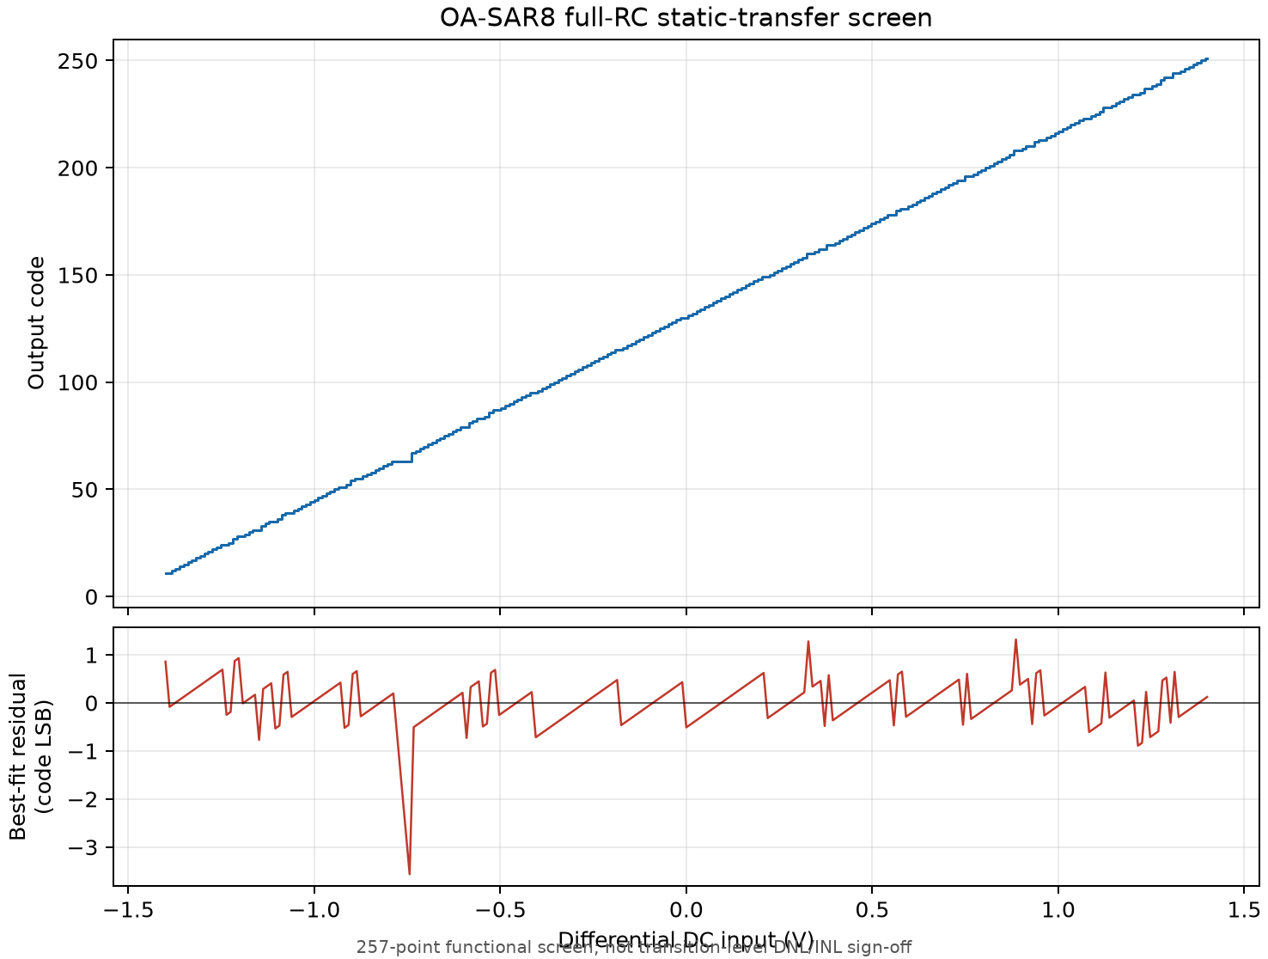
sar-adc/signoff/core18_pdnfix_20260830/results/dc_transfer_257.png
