lmm2024/sar-adc-8b-open/sar-adc/signoff/core18_pdnfix_20260830/results/fft_10m_lowfreq312k.png

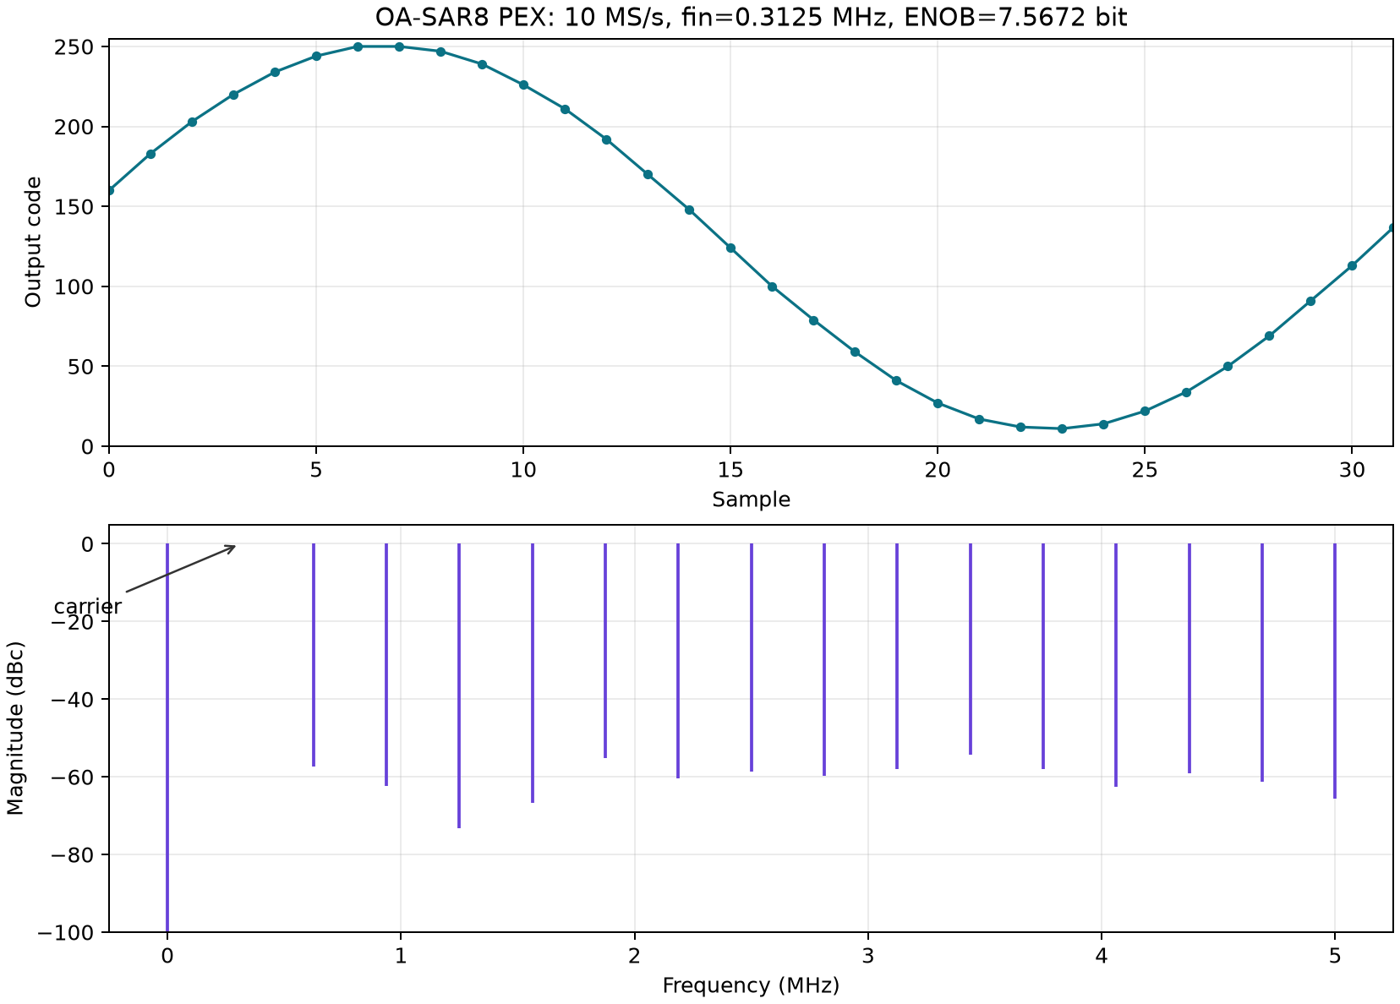
sar-adc/signoff/core18_pdnfix_20260830/results/fft_10m_lowfreq312k.png
