lmm2024/sar-adc-8b-open/sar-adc/layout/pex_a13/oa_sar8_acore13.pex.spice

* PEX produced on Sun Aug 16 09:02:53 AM CEST 2026 using /foss/tools/sak/sak-pex.sh with m=2 and s=1
* NGSPICE file created from oa_sar8_acore13.ext - technology: ihp-sg13g2

.subckt oa_sar8_acore13 vinp vinn ctl0 ctl1 ctl2 ctl3 ctl4 ctl5 ctl6 ctl7 vcm trk
+ clk_cmp outp outn ctl0n ctl1n ctl2n ctl3n ctl4n ctl5n ctl6n ctl7n hold VSS VDD
X0 VDD ctl6 sw_bitcell11_10.bot VDD sg13_lv_pmos ad=0.7p pd=4.7u as=0.39p ps=2.39u w=2u l=0.13u
X1 bstrap40_0.out bstrap40_1.ckb sw_bitcell11_4.bot VDD sg13_lv_pmos ad=0.7p pd=4.7u as=0.39p ps=2.39u w=2u l=0.13u
X2 sw_tg_0.bot sw_bitcell11_8.bot cap_cmim l=2.14u w=2.14u
X3 cdac_array_1.topp sw_bitcell11_13.bot cap_cmim l=2.14u w=2.14u
X4 outp outn a_26184_21025# VSS sg13_lv_nmos ad=0.39p pd=2.39u as=0.7p ps=4.7u w=2u l=0.13u
X5 cdac_array_1.topp sw_bitcell11_9.bot cap_cmim l=2.14u w=2.14u
X6 sw_tg_0.bot sw_bitcell11_5.bot cap_cmim l=2.14u w=2.14u
X7 cdac_array_1.topp sw_bitcell11_10.bot cap_cmim l=2.14u w=2.14u
X8 sw_bitcell11_8.bot ctl7n sw_bitcell11_8.VSS VSS sg13_lv_nmos ad=0.195p pd=1.39u as=0.35p ps=2.7u w=1u l=0.13u
X9 cdac_array_1.topp sw_bitcell11_10.bot cap_cmim l=2.14u w=2.14u
X10 sw_tg_0.bot sw_bitcell11_7.bot cap_cmim l=2.14u w=2.14u
X11 cdac_array_1.topp sw_bitcell11_9.bot cap_cmim l=2.14u w=2.14u
X12 cdac_array_1.topp sw_bitcell11_12.bot cap_cmim l=2.14u w=2.14u
X13 sw_tg_0.bot sw_bitcell11_8.bot cap_cmim l=2.14u w=2.14u
X14 cdac_array_1.topp sw_bitcell11_11.bot cap_cmim l=2.14u w=2.14u
X15 VSS bstrap40_1.ckb a_8368_n9612# VSS sg13_lv_nmos ad=0.345p pd=2.69u as=0.19p ps=1.38u w=1u l=0.15u
X16 sw_tg_0.bot sw_bitcell11_7.bot cap_cmim l=2.14u w=2.14u
X17 cdac_array_1.topp sw_bitcell11_13.bot cap_cmim l=2.14u w=2.14u
X18 cdac_array_1.topp sw_bitcell11_9.bot cap_cmim l=2.14u w=2.14u
X19 cdac_array_1.topp sw_bitcell11_10.bot cap_cmim l=2.14u w=2.14u
X20 sw_tg_0.bot sw_bitcell11_8.bot cap_cmim l=2.14u w=2.14u
X21 sw_tg_0.bot sw_bitcell11_7.bot cap_cmim l=2.14u w=2.14u
X22 VDD ctl2 sw_bitcell11_14.bot VDD sg13_lv_pmos ad=0.7p pd=4.7u as=0.39p ps=2.39u w=2u l=0.13u
X23 cdac_array_1.topp sw_bitcell11_9.bot cap_cmim l=2.14u w=2.14u
X24 sw_tg_0.bot sw_bitcell11_8.bot cap_cmim l=2.14u w=2.14u
X25 sw_tg_0.bot sw_bitcell11_8.bot cap_cmim l=2.14u w=2.14u
X26 sw_tg_0.bot sw_bitcell11_5.bot cap_cmim l=2.14u w=2.14u
X27 cdac_array_1.topp sw_bitcell11_11.bot cap_cmim l=2.14u w=2.14u
X28 cdac_array_1.topp sw_bitcell11_9.bot cap_cmim l=2.14u w=2.14u
X29 cdac_array_1.topp sw_bitcell11_9.bot cap_cmim l=2.14u w=2.14u
X30 sw_bitcell11_8.VSS ctl5n sw_bitcell11_6.bot VSS sg13_lv_nmos ad=0.35p pd=2.7u as=0.195p ps=1.39u w=1u l=0.13u
X31 bstrap40_0.out bstrap40_0.gb cdac_array_0.b0 VSS sg13_lv_nmos ad=0.35p pd=2.7u as=0.195p ps=1.39u w=1u l=0.13u
X32 sw_tg_0.bot sw_bitcell11_8.bot cap_cmim l=2.14u w=2.14u
X33 sw_tg_0.bot sw_bitcell11_8.bot cap_cmim l=2.14u w=2.14u
X34 cdac_array_1.topp sw_bitcell11_11.bot cap_cmim l=2.14u w=2.14u
X35 cdac_array_0.term VDD VDD VDD sg13_lv_pmos ad=0.39p pd=2.39u as=0.7p ps=4.7u w=2u l=0.13u
X36 a_8368_n9612# bstrap40_1.ckb VSS VSS sg13_lv_nmos ad=0.19p pd=1.38u as=0.345p ps=2.69u w=1u l=0.15u
X37 sw_tg_0.bot sw_bitcell11_7.bot cap_cmim l=2.14u w=2.14u
X38 bstrap40_1.out bstrap40_1.gb sw_bitcell11_11.bot VSS sg13_lv_nmos ad=0.35p pd=2.7u as=0.195p ps=1.39u w=1u l=0.13u
X39 cdac_array_1.topp sw_bitcell11_9.bot cap_cmim l=2.14u w=2.14u
X40 cdac_array_1.topp sw_bitcell11_11.bot cap_cmim l=2.14u w=2.14u
X41 cdac_array_1.topp sw_bitcell11_9.bot cap_cmim l=2.14u w=2.14u
X42 sw_tg_0.bot sw_bitcell11_8.bot cap_cmim l=2.14u w=2.14u
X43 cdac_array_1.topp sw_bitcell11_9.bot cap_cmim l=2.14u w=2.14u
X44 sw_tg_0.bot sw_bitcell11_6.bot cap_cmim l=2.14u w=2.14u
X45 a_26184_21025# outn outp VSS sg13_lv_nmos ad=0.7p pd=4.7u as=0.39p ps=2.39u w=2u l=0.13u
X46 sw_bitcell11_10.bot ctl6 VDD VDD sg13_lv_pmos ad=0.39p pd=2.39u as=0.7p ps=4.7u w=2u l=0.13u
X47 sw_bitcell11_4.bot bstrap40_1.ckb bstrap40_0.out VDD sg13_lv_pmos ad=0.39p pd=2.39u as=0.7p ps=4.7u w=2u l=0.13u
X48 cdac_array_1.topp sw_bitcell11_9.bot cap_cmim l=2.14u w=2.14u
X49 cdac_array_1.topp sw_bitcell11_10.bot cap_cmim l=2.14u w=2.14u
X50 a_26184_21025# cdac_array_1.topp a_28008_23477# VSS sg13_lv_nmos ad=0.19p pd=1.38u as=0.345p ps=2.69u w=1u l=0.15u
X51 sw_tg_0.bot sw_bitcell11_7.bot cap_cmim l=2.14u w=2.14u
X52 sw_tg_0.bot sw_bitcell11_6.bot cap_cmim l=2.14u w=2.14u
X53 sw_tg_0.bot sw_bitcell11_8.bot cap_cmim l=2.14u w=2.14u
X54 sw_tg_0.bot cdac_array_0.b1 cap_cmim l=2.14u w=2.14u
X55 cdac_array_1.topp sw_bitcell11_15.bot cap_cmim l=2.14u w=2.14u
X56 sw_tg_0.bot sw_bitcell11_8.bot cap_cmim l=2.14u w=2.14u
X57 cdac_array_1.topp sw_bitcell11_10.bot cap_cmim l=2.14u w=2.14u
X58 bstrap40_1.out bstrap40_1.gb sw_bitcell11_15.bot VSS sg13_lv_nmos ad=0.35p pd=2.7u as=0.195p ps=1.39u w=1u l=0.13u
X59 sw_bitcell11_8.VSS ctl2n cdac_array_0.b2 VSS sg13_lv_nmos ad=0.35p pd=2.7u as=0.195p ps=1.39u w=1u l=0.13u
X60 w_41352_n9960# a_45072_n9612# cap_cmim l=9.94u w=39.8u
X61 cdac_array_1.topp sw_bitcell11_10.bot cap_cmim l=2.14u w=2.14u
X62 cdac_array_1.topp sw_bitcell11_9.bot cap_cmim l=2.14u w=2.14u
X63 sw_tg_0.bot trk vcm VSS sg13_lv_nmos ad=0.195p pd=1.39u as=0.35p ps=2.7u w=1u l=0.13u
X64 sw_tg_0.bot sw_bitcell11_6.bot cap_cmim l=2.14u w=2.14u
X65 sw_bitcell11_14.bot ctl2 VDD VDD sg13_lv_pmos ad=0.39p pd=2.39u as=0.7p ps=4.7u w=2u l=0.13u
X66 sw_tg_0.bot sw_bitcell11_8.bot cap_cmim l=2.14u w=2.14u
X67 sw_bitcell11_17.bot VDD sw_bitcell11_17.VSS VSS sg13_lv_nmos ad=0.195p pd=1.39u as=0.35p ps=2.7u w=1u l=0.13u
X68 sw_bitcell11_8.VSS VDD cdac_array_0.term VSS sg13_lv_nmos ad=0.35p pd=2.7u as=0.195p ps=1.39u w=1u l=0.13u
X69 sw_tg_0.bot sw_bitcell11_8.bot cap_cmim l=2.14u w=2.14u
X70 cdac_array_1.topp sw_bitcell11_12.bot cap_cmim l=2.14u w=2.14u
X71 cdac_array_1.topp sw_bitcell11_9.bot cap_cmim l=2.14u w=2.14u
X72 cdac_array_1.topp sw_bitcell11_9.bot cap_cmim l=2.14u w=2.14u
X73 sw_tg_0.bot sw_bitcell11_7.bot cap_cmim l=2.14u w=2.14u
X74 a_28008_23477# cdac_array_1.topp a_26184_21025# VSS sg13_lv_nmos ad=0.345p pd=2.69u as=0.19p ps=1.38u w=1u l=0.15u
X75 sw_tg_0.bot sw_bitcell11_7.bot cap_cmim l=2.14u w=2.14u
X76 cdac_array_1.topp sw_bitcell11_10.bot cap_cmim l=2.14u w=2.14u
X77 sw_bitcell11_6.bot bstrap40_0.gb bstrap40_0.out VSS sg13_lv_nmos ad=0.195p pd=1.39u as=0.35p ps=2.7u w=1u l=0.13u
X78 bstrap40_0.out bstrap40_0.gb cdac_array_0.b2 VSS sg13_lv_nmos ad=0.35p pd=2.7u as=0.195p ps=1.39u w=1u l=0.13u
X79 sw_tg_0.bot sw_bitcell11_8.bot cap_cmim l=2.14u w=2.14u
X80 sw_tg_0.bot sw_bitcell11_8.bot cap_cmim l=2.14u w=2.14u
X81 cdac_array_1.topp sw_bitcell11_10.bot cap_cmim l=2.14u w=2.14u
X82 bstrap40_1.out bstrap40_1.gb sw_bitcell11_13.bot VSS sg13_lv_nmos ad=0.35p pd=2.7u as=0.195p ps=1.39u w=1u l=0.13u
X83 cdac_array_1.topp sw_bitcell11_9.bot cap_cmim l=2.14u w=2.14u
X84 sw_tg_0.bot sw_bitcell11_8.bot cap_cmim l=2.14u w=2.14u
X85 sw_tg_0.bot sw_bitcell11_8.bot cap_cmim l=2.14u w=2.14u
X86 sw_tg_0.bot sw_bitcell11_5.bot cap_cmim l=2.14u w=2.14u
X87 sw_tg_0.bot sw_bitcell11_5.bot cap_cmim l=2.14u w=2.14u
X88 sw_tg_0.bot sw_bitcell11_7.bot cap_cmim l=2.14u w=2.14u
X89 bstrap40_1.ckb trk VSS VSS sg13_lv_nmos ad=0.195p pd=1.39u as=0.35p ps=2.7u w=1u l=0.13u
X90 VSS bstrap40_1.ckb a_45072_n9612# VSS sg13_lv_nmos ad=0.345p pd=2.69u as=0.19p ps=1.38u w=1u l=0.15u
X91 cdac_array_1.topp sw_bitcell11_9.bot cap_cmim l=2.14u w=2.14u
X92 sw_bitcell11_17.VSS hold VSS VSS sg13_lv_nmos ad=0.39p pd=2.39u as=0.7p ps=4.7u w=2u l=0.13u
X93 sw_tg_0.bot sw_bitcell11_7.bot cap_cmim l=2.14u w=2.14u
X94 cdac_array_1.topp sw_bitcell11_11.bot cap_cmim l=2.14u w=2.14u
X95 cdac_array_1.topp sw_bitcell11_9.bot cap_cmim l=2.14u w=2.14u
X96 sw_tg_0.bot sw_bitcell11_6.bot cap_cmim l=2.14u w=2.14u
X97 sw_bitcell11_17.VSS ctl2 sw_bitcell11_14.bot VSS sg13_lv_nmos ad=0.35p pd=2.7u as=0.195p ps=1.39u w=1u l=0.13u
X98 bstrap40_0.out bstrap40_0.gb sw_bitcell11_7.bot VSS sg13_lv_nmos ad=0.35p pd=2.7u as=0.195p ps=1.39u w=1u l=0.13u
X99 sw_tg_0.bot sw_bitcell11_7.bot cap_cmim l=2.14u w=2.14u
X100 cdac_array_1.topp sw_bitcell11_9.bot cap_cmim l=2.14u w=2.14u
X101 cdac_array_1.topp sw_bitcell11_11.bot cap_cmim l=2.14u w=2.14u
X102 sw_tg_0.bot sw_bitcell11_8.bot cap_cmim l=2.14u w=2.14u
X103 cdac_array_1.topp sw_bitcell11_10.bot cap_cmim l=2.14u w=2.14u
X104 sw_tg_0.bot sw_bitcell11_8.bot cap_cmim l=2.14u w=2.14u
X105 sw_tg_0.bot sw_bitcell11_4.bot cap_cmim l=2.14u w=2.14u
X106 cdac_array_1.topp sw_bitcell11_9.bot cap_cmim l=2.14u w=2.14u
X107 sw_bitcell11_5.bot ctl4n sw_bitcell11_8.VSS VSS sg13_lv_nmos ad=0.195p pd=1.39u as=0.35p ps=2.7u w=1u l=0.13u
X108 sw_tg_0.bot sw_bitcell11_8.bot cap_cmim l=2.14u w=2.14u
X109 sw_tg_0.bot sw_bitcell11_7.bot cap_cmim l=2.14u w=2.14u
X110 bstrap40_1.out bstrap40_1.gb sw_bitcell11_10.bot VSS sg13_lv_nmos ad=0.35p pd=2.7u as=0.195p ps=1.39u w=1u l=0.13u
X111 cdac_array_0.term bstrap40_0.gb bstrap40_0.out VSS sg13_lv_nmos ad=0.195p pd=1.39u as=0.35p ps=2.7u w=1u l=0.13u
X112 sw_bitcell11_17.VSS hold VSS VSS sg13_lv_nmos ad=0.39p pd=2.39u as=0.7p ps=4.7u w=2u l=0.13u
X113 a_45072_n9612# bstrap40_1.ckb VSS VSS sg13_lv_nmos ad=0.19p pd=1.38u as=0.345p ps=2.69u w=1u l=0.15u
X114 cdac_array_1.topp sw_bitcell11_9.bot cap_cmim l=2.14u w=2.14u
X115 sw_tg_0.bot sw_bitcell11_8.bot cap_cmim l=2.14u w=2.14u
X116 sw_tg_0.bot sw_bitcell11_8.bot cap_cmim l=2.14u w=2.14u
X117 sw_tg_0.bot sw_bitcell11_6.bot cap_cmim l=2.14u w=2.14u
X118 cdac_array_1.topp sw_bitcell11_10.bot cap_cmim l=2.14u w=2.14u
X119 sw_tg_0.bot sw_bitcell11_8.bot cap_cmim l=2.14u w=2.14u
X120 cdac_array_1.topp sw_bitcell11_10.bot cap_cmim l=2.14u w=2.14u
X121 cdac_array_1.topp sw_bitcell11_10.bot cap_cmim l=2.14u w=2.14u
X122 sw_tg_0.bot sw_bitcell11_8.bot cap_cmim l=2.14u w=2.14u
X123 sw_tg_0.bot sw_bitcell11_6.bot cap_cmim l=2.14u w=2.14u
X124 cdac_array_1.topp sw_bitcell11_9.bot cap_cmim l=2.14u w=2.14u
X125 cdac_array_1.topp sw_bitcell11_14.bot cap_cmim l=2.14u w=2.14u
X126 sw_tg_0.bot sw_bitcell11_8.bot cap_cmim l=2.14u w=2.14u
X127 cdac_array_1.topp sw_bitcell11_10.bot cap_cmim l=2.14u w=2.14u
X128 sw_tg_0.bot sw_bitcell11_7.bot cap_cmim l=2.14u w=2.14u
X129 VDD ctl1n cdac_array_0.b1 VDD sg13_lv_pmos ad=0.7p pd=4.7u as=0.39p ps=2.39u w=2u l=0.13u
X130 cdac_array_1.topp sw_bitcell11_9.bot cap_cmim l=2.14u w=2.14u
X131 sw_tg_0.bot sw_bitcell11_7.bot cap_cmim l=2.14u w=2.14u
X132 sw_bitcell11_14.bot bstrap40_1.gb bstrap40_1.out VSS sg13_lv_nmos ad=0.195p pd=1.39u as=0.35p ps=2.7u w=1u l=0.13u
X133 cdac_array_1.topp sw_bitcell11_10.bot cap_cmim l=2.14u w=2.14u
X134 sw_tg_0.bot sw_bitcell11_5.bot cap_cmim l=2.14u w=2.14u
X135 cdac_array_1.topp sw_bitcell11_10.bot cap_cmim l=2.14u w=2.14u
X136 VDD ctl4 sw_bitcell11_12.bot VDD sg13_lv_pmos ad=0.7p pd=4.7u as=0.39p ps=2.39u w=2u l=0.13u
X137 bstrap40_0.out bstrap40_1.ckb sw_bitcell11_6.bot VDD sg13_lv_pmos ad=0.7p pd=4.7u as=0.39p ps=2.39u w=2u l=0.13u
X138 sw_tg_0.bot sw_bitcell11_7.bot cap_cmim l=2.14u w=2.14u
X139 sw_tg_0.bot sw_bitcell11_5.bot cap_cmim l=2.14u w=2.14u
X140 sw_tg_0.bot sw_bitcell11_6.bot cap_cmim l=2.14u w=2.14u
X141 sw_tg_0.bot sw_bitcell11_8.bot cap_cmim l=2.14u w=2.14u
X142 cdac_array_1.topp sw_bitcell11_11.bot cap_cmim l=2.14u w=2.14u
X143 cdac_array_1.topp sw_bitcell11_9.bot cap_cmim l=2.14u w=2.14u
X144 bstrap40_0.out bstrap40_1.ckb cdac_array_0.b2 VDD sg13_lv_pmos ad=0.7p pd=4.7u as=0.39p ps=2.39u w=2u l=0.13u
X145 cdac_array_1.topp sw_bitcell11_11.bot cap_cmim l=2.14u w=2.14u
X146 cdac_array_1.topp sw_bitcell11_9.bot cap_cmim l=2.14u w=2.14u
X147 sw_tg_0.bot sw_bitcell11_8.bot cap_cmim l=2.14u w=2.14u
X148 cdac_array_1.topp sw_bitcell11_9.bot cap_cmim l=2.14u w=2.14u
X149 sw_tg_0.bot sw_bitcell11_7.bot cap_cmim l=2.14u w=2.14u
X150 bstrap40_1.out bstrap40_1.gb sw_bitcell11_12.bot VSS sg13_lv_nmos ad=0.35p pd=2.7u as=0.195p ps=1.39u w=1u l=0.13u
X151 a_45992_n9711# VDD bstrap40_0.gb VSS sg13_lv_nmos ad=0.345p pd=2.69u as=0.19p ps=1.38u w=1u l=0.15u
X152 cdac_array_1.topp sw_bitcell11_9.bot cap_cmim l=2.14u w=2.14u
X153 sw_tg_0.bot sw_bitcell11_8.bot cap_cmim l=2.14u w=2.14u
X154 VDD ctl0 sw_bitcell11_16.bot VDD sg13_lv_pmos ad=0.7p pd=4.7u as=0.39p ps=2.39u w=2u l=0.13u
X155 cdac_array_1.topp sw_bitcell11_9.bot cap_cmim l=2.14u w=2.14u
X156 cdac_array_1.topp sw_bitcell11_9.bot cap_cmim l=2.14u w=2.14u
X157 sw_tg_0.bot sw_bitcell11_7.bot cap_cmim l=2.14u w=2.14u
X158 sw_tg_0.bot sw_bitcell11_8.bot cap_cmim l=2.14u w=2.14u
X159 sw_tg_0.bot sw_bitcell11_8.bot cap_cmim l=2.14u w=2.14u
X160 sw_tg_0.bot sw_bitcell11_8.bot cap_cmim l=2.14u w=2.14u
X161 bstrap40_1.out bstrap40_1.gb sw_bitcell11_17.bot VSS sg13_lv_nmos ad=0.35p pd=2.7u as=0.195p ps=1.39u w=1u l=0.13u
X162 outn clk_cmp VDD VDD sg13_lv_pmos ad=0.7p pd=4.7u as=0.7p ps=4.7u w=2u l=0.13u
X163 vcm bstrap40_1.ckb sw_tg_0.bot VDD sg13_lv_pmos ad=0.7p pd=4.7u as=0.39p ps=2.39u w=2u l=0.13u
X164 sw_tg_0.bot sw_bitcell11_8.bot cap_cmim l=2.14u w=2.14u
X165 cdac_array_1.topp sw_bitcell11_9.bot cap_cmim l=2.14u w=2.14u
X166 sw_tg_0.bot sw_bitcell11_8.bot cap_cmim l=2.14u w=2.14u
X167 cdac_array_0.b1 ctl1n VDD VDD sg13_lv_pmos ad=0.39p pd=2.39u as=0.7p ps=4.7u w=2u l=0.13u
X168 sw_tg_0.bot sw_bitcell11_6.bot cap_cmim l=2.14u w=2.14u
X169 bstrap40_0.out bstrap40_1.ckb cdac_array_0.term VDD sg13_lv_pmos ad=0.7p pd=4.7u as=0.39p ps=2.39u w=2u l=0.13u
X170 vcm trk cdac_array_1.topp VSS sg13_lv_nmos ad=0.35p pd=2.7u as=0.195p ps=1.39u w=1u l=0.13u
X171 bstrap40_0.gb VDD a_45992_n9711# VSS sg13_lv_nmos ad=0.19p pd=1.38u as=0.345p ps=2.69u w=1u l=0.15u
X172 cdac_array_1.topp sw_bitcell11_9.bot cap_cmim l=2.14u w=2.14u
X173 sw_bitcell11_16.bot bstrap40_1.gb bstrap40_1.out VSS sg13_lv_nmos ad=0.195p pd=1.39u as=0.35p ps=2.7u w=1u l=0.13u
X174 cdac_array_1.topp sw_bitcell11_10.bot cap_cmim l=2.14u w=2.14u
X175 sw_bitcell11_12.bot ctl4 VDD VDD sg13_lv_pmos ad=0.39p pd=2.39u as=0.7p ps=4.7u w=2u l=0.13u
X176 sw_bitcell11_6.bot bstrap40_1.ckb bstrap40_0.out VDD sg13_lv_pmos ad=0.39p pd=2.39u as=0.7p ps=4.7u w=2u l=0.13u
X177 sw_bitcell11_4.bot ctl3n sw_bitcell11_8.VSS VSS sg13_lv_nmos ad=0.195p pd=1.39u as=0.35p ps=2.7u w=1u l=0.13u
X178 cdac_array_1.topp sw_bitcell11_9.bot cap_cmim l=2.14u w=2.14u
X179 sw_tg_0.bot sw_bitcell11_7.bot cap_cmim l=2.14u w=2.14u
X180 outn outp VDD VDD sg13_lv_pmos ad=0.585p pd=3.39u as=1.05p ps=6.7u w=3u l=0.13u
X181 vinp bstrap40_1.gb bstrap40_1.out VSS sg13_lv_nmos ad=0.7p pd=4.7u as=0.39p ps=2.39u w=2u l=0.13u
X182 sw_tg_0.bot sw_bitcell11_6.bot cap_cmim l=2.14u w=2.14u
X183 cdac_array_1.topp sw_bitcell11_17.bot cap_cmim l=2.14u w=2.14u
X184 cdac_array_1.topp sw_bitcell11_10.bot cap_cmim l=2.14u w=2.14u
X185 cdac_array_1.topp sw_bitcell11_13.bot cap_cmim l=2.14u w=2.14u
X186 sw_tg_0.bot sw_bitcell11_8.bot cap_cmim l=2.14u w=2.14u
X187 sw_tg_0.bot sw_bitcell11_8.bot cap_cmim l=2.14u w=2.14u
X188 cdac_array_0.b2 bstrap40_1.ckb bstrap40_0.out VDD sg13_lv_pmos ad=0.39p pd=2.39u as=0.7p ps=4.7u w=2u l=0.13u
X189 sw_tg_0.bot sw_bitcell11_7.bot cap_cmim l=2.14u w=2.14u
X190 cdac_array_1.topp sw_bitcell11_10.bot cap_cmim l=2.14u w=2.14u
X191 sw_tg_0.bot sw_bitcell11_6.bot cap_cmim l=2.14u w=2.14u
X192 sw_tg_0.bot sw_bitcell11_8.bot cap_cmim l=2.14u w=2.14u
X193 VDD ctl7n sw_bitcell11_8.bot VDD sg13_lv_pmos ad=0.7p pd=4.7u as=0.39p ps=2.39u w=2u l=0.13u
X194 sw_bitcell11_16.bot ctl0 VDD VDD sg13_lv_pmos ad=0.39p pd=2.39u as=0.7p ps=4.7u w=2u l=0.13u
X195 cdac_array_1.topp sw_bitcell11_9.bot cap_cmim l=2.14u w=2.14u
X196 sw_tg_0.bot sw_bitcell11_8.bot cap_cmim l=2.14u w=2.14u
X197 sw_tg_0.bot sw_bitcell11_8.bot cap_cmim l=2.14u w=2.14u
X198 bstrap40_1.out bstrap40_1.ckb sw_bitcell11_14.bot VDD sg13_lv_pmos ad=0.7p pd=4.7u as=0.39p ps=2.39u w=2u l=0.13u
X199 sw_tg_0.bot sw_bitcell11_7.bot cap_cmim l=2.14u w=2.14u
X200 sw_tg_0.bot sw_bitcell11_7.bot cap_cmim l=2.14u w=2.14u
X201 cdac_array_1.topp sw_bitcell11_10.bot cap_cmim l=2.14u w=2.14u
X202 sw_bitcell11_8.VSS ctl1n cdac_array_0.b1 VSS sg13_lv_nmos ad=0.35p pd=2.7u as=0.195p ps=1.39u w=1u l=0.13u
X203 sw_tg_0.bot sw_bitcell11_8.bot cap_cmim l=2.14u w=2.14u
X204 sw_tg_0.bot sw_bitcell11_7.bot cap_cmim l=2.14u w=2.14u
X205 sw_tg_0.bot sw_bitcell11_8.bot cap_cmim l=2.14u w=2.14u
X206 cdac_array_1.topp sw_bitcell11_9.bot cap_cmim l=2.14u w=2.14u
X207 cdac_array_1.topp sw_bitcell11_11.bot cap_cmim l=2.14u w=2.14u
X208 sw_tg_0.bot bstrap40_1.ckb vcm VDD sg13_lv_pmos ad=0.39p pd=2.39u as=0.7p ps=4.7u w=2u l=0.13u
X209 cdac_array_1.topp sw_bitcell11_10.bot cap_cmim l=2.14u w=2.14u
X210 VDD ctl5 sw_bitcell11_11.bot VDD sg13_lv_pmos ad=0.7p pd=4.7u as=0.39p ps=2.39u w=2u l=0.13u
X211 cdac_array_1.topp sw_bitcell11_10.bot cap_cmim l=2.14u w=2.14u
X212 sw_tg_0.bot sw_bitcell11_8.bot cap_cmim l=2.14u w=2.14u
X213 sw_tg_0.bot sw_bitcell11_4.bot cap_cmim l=2.14u w=2.14u
X214 cdac_array_0.term bstrap40_1.ckb bstrap40_0.out VDD sg13_lv_pmos ad=0.39p pd=2.39u as=0.7p ps=4.7u w=2u l=0.13u
X215 cdac_array_1.topp sw_bitcell11_9.bot cap_cmim l=2.14u w=2.14u
X216 sw_tg_0.bot sw_bitcell11_7.bot cap_cmim l=2.14u w=2.14u
X217 sw_tg_0.bot sw_bitcell11_8.bot cap_cmim l=2.14u w=2.14u
X218 sw_tg_0.bot sw_bitcell11_6.bot cap_cmim l=2.14u w=2.14u
X219 VDD outp outn VDD sg13_lv_pmos ad=1.05p pd=6.7u as=0.585p ps=3.39u w=3u l=0.13u
X220 sw_tg_0.bot sw_bitcell11_6.bot cap_cmim l=2.14u w=2.14u
X221 sw_tg_0.bot sw_bitcell11_8.bot cap_cmim l=2.14u w=2.14u
X222 bstrap40_1.out bstrap40_1.ckb sw_bitcell11_12.bot VDD sg13_lv_pmos ad=0.7p pd=4.7u as=0.39p ps=2.39u w=2u l=0.13u
X223 cdac_array_1.topp sw_bitcell11_9.bot cap_cmim l=2.14u w=2.14u
X224 sw_bitcell11_17.VSS ctl0 sw_bitcell11_16.bot VSS sg13_lv_nmos ad=0.35p pd=2.7u as=0.195p ps=1.39u w=1u l=0.13u
X225 sw_tg_0.bot sw_bitcell11_7.bot cap_cmim l=2.14u w=2.14u
X226 sw_tg_0.bot sw_bitcell11_8.bot cap_cmim l=2.14u w=2.14u
X227 cdac_array_1.topp sw_bitcell11_10.bot cap_cmim l=2.14u w=2.14u
X228 sw_bitcell11_8.bot ctl7n VDD VDD sg13_lv_pmos ad=0.39p pd=2.39u as=0.7p ps=4.7u w=2u l=0.13u
X229 sw_tg_0.bot sw_bitcell11_8.bot cap_cmim l=2.14u w=2.14u
X230 cdac_array_1.topp sw_bitcell11_12.bot cap_cmim l=2.14u w=2.14u
X231 sw_tg_0.bot sw_bitcell11_4.bot cap_cmim l=2.14u w=2.14u
X232 bstrap40_1.out bstrap40_1.ckb sw_bitcell11_17.bot VDD sg13_lv_pmos ad=0.7p pd=4.7u as=0.39p ps=2.39u w=2u l=0.13u
X233 cdac_array_1.topp sw_bitcell11_9.bot cap_cmim l=2.14u w=2.14u
X234 sw_tg_0.bot sw_bitcell11_8.bot cap_cmim l=2.14u w=2.14u
X235 cdac_array_1.topp sw_bitcell11_9.bot cap_cmim l=2.14u w=2.14u
X236 cdac_array_1.topp sw_bitcell11_12.bot cap_cmim l=2.14u w=2.14u
X237 sw_tg_0.bot sw_bitcell11_7.bot cap_cmim l=2.14u w=2.14u
X238 cdac_array_1.topp sw_bitcell11_9.bot cap_cmim l=2.14u w=2.14u
X239 cdac_array_1.topp sw_bitcell11_9.bot cap_cmim l=2.14u w=2.14u
X240 sw_bitcell11_14.bot bstrap40_1.ckb bstrap40_1.out VDD sg13_lv_pmos ad=0.39p pd=2.39u as=0.7p ps=4.7u w=2u l=0.13u
X241 sw_tg_0.bot sw_bitcell11_8.bot cap_cmim l=2.14u w=2.14u
X242 bstrap40_1.out bstrap40_1.ckb sw_bitcell11_16.bot VDD sg13_lv_pmos ad=0.7p pd=4.7u as=0.39p ps=2.39u w=2u l=0.13u
X243 cdac_array_0.b1 bstrap40_0.gb bstrap40_0.out VSS sg13_lv_nmos ad=0.195p pd=1.39u as=0.35p ps=2.7u w=1u l=0.13u
X244 vinp bstrap40_1.gb a_9288_n9612# VSS sg13_lv_nmos ad=0.345p pd=2.69u as=0.19p ps=1.38u w=1u l=0.15u
X245 cdac_array_1.topp sw_bitcell11_10.bot cap_cmim l=2.14u w=2.14u
X246 sw_tg_0.bot sw_bitcell11_8.bot cap_cmim l=2.14u w=2.14u
X247 sw_tg_0.bot sw_bitcell11_8.bot cap_cmim l=2.14u w=2.14u
X248 sw_bitcell11_11.bot ctl5 VDD VDD sg13_lv_pmos ad=0.39p pd=2.39u as=0.7p ps=4.7u w=2u l=0.13u
X249 VDD ctl3 sw_bitcell11_13.bot VDD sg13_lv_pmos ad=0.7p pd=4.7u as=0.39p ps=2.39u w=2u l=0.13u
X250 bstrap40_1.out bstrap40_1.gb sw_bitcell11_9.bot VSS sg13_lv_nmos ad=0.35p pd=2.7u as=0.195p ps=1.39u w=1u l=0.13u
X251 sw_tg_0.bot cdac_array_0.term cap_cmim l=2.14u w=2.14u
X252 sw_tg_0.bot sw_bitcell11_7.bot cap_cmim l=2.14u w=2.14u
X253 sw_tg_0.bot sw_bitcell11_8.bot cap_cmim l=2.14u w=2.14u
X254 sw_tg_0.bot sw_bitcell11_7.bot cap_cmim l=2.14u w=2.14u
X255 sw_bitcell11_8.VSS hold VSS VSS sg13_lv_nmos ad=0.39p pd=2.39u as=0.7p ps=4.7u w=2u l=0.13u
X256 sw_tg_0.bot sw_bitcell11_7.bot cap_cmim l=2.14u w=2.14u
X257 cdac_array_1.topp sw_bitcell11_9.bot cap_cmim l=2.14u w=2.14u
X258 sw_bitcell11_12.bot bstrap40_1.ckb bstrap40_1.out VDD sg13_lv_pmos ad=0.39p pd=2.39u as=0.7p ps=4.7u w=2u l=0.13u
X259 a_9288_n9612# bstrap40_1.gb vinp VSS sg13_lv_nmos ad=0.19p pd=1.38u as=0.345p ps=2.69u w=1u l=0.15u
X260 cdac_array_1.topp sw_bitcell11_10.bot cap_cmim l=2.14u w=2.14u
X261 cdac_array_1.topp sw_bitcell11_10.bot cap_cmim l=2.14u w=2.14u
X262 sw_tg_0.bot sw_bitcell11_7.bot cap_cmim l=2.14u w=2.14u
X263 sw_tg_0.bot cdac_array_0.b0 cap_cmim l=2.14u w=2.14u
X264 w_12940_n9960# a_9288_n9612# cap_cmim l=9.94u w=39.8u
X265 cdac_array_1.topp sw_bitcell11_11.bot cap_cmim l=2.14u w=2.14u
X266 sw_bitcell11_8.VSS ctl0n cdac_array_0.b0 VSS sg13_lv_nmos ad=0.35p pd=2.7u as=0.195p ps=1.39u w=1u l=0.13u
X267 sw_bitcell11_17.bot bstrap40_1.ckb bstrap40_1.out VDD sg13_lv_pmos ad=0.39p pd=2.39u as=0.7p ps=4.7u w=2u l=0.13u
X268 sw_tg_0.bot sw_bitcell11_6.bot cap_cmim l=2.14u w=2.14u
X269 sw_bitcell11_8.VSS hold VSS VSS sg13_lv_nmos ad=0.39p pd=2.39u as=0.7p ps=4.7u w=2u l=0.13u
X270 sw_tg_0.bot sw_bitcell11_7.bot cap_cmim l=2.14u w=2.14u
X271 sw_bitcell11_17.VSS ctl5 sw_bitcell11_11.bot VSS sg13_lv_nmos ad=0.35p pd=2.7u as=0.195p ps=1.39u w=1u l=0.13u
X272 sw_tg_0.bot sw_bitcell11_8.bot cap_cmim l=2.14u w=2.14u
X273 sw_bitcell11_16.bot bstrap40_1.ckb bstrap40_1.out VDD sg13_lv_pmos ad=0.39p pd=2.39u as=0.7p ps=4.7u w=2u l=0.13u
X274 sw_tg_0.bot sw_bitcell11_8.bot cap_cmim l=2.14u w=2.14u
X275 cdac_array_1.topp sw_bitcell11_9.bot cap_cmim l=2.14u w=2.14u
X276 cdac_array_1.topp sw_bitcell11_9.bot cap_cmim l=2.14u w=2.14u
X277 sw_tg_0.bot sw_bitcell11_7.bot cap_cmim l=2.14u w=2.14u
X278 sw_tg_0.bot sw_bitcell11_8.bot cap_cmim l=2.14u w=2.14u
X279 sw_tg_0.bot sw_bitcell11_8.bot cap_cmim l=2.14u w=2.14u
X280 sw_tg_0.bot sw_bitcell11_6.bot cap_cmim l=2.14u w=2.14u
X281 sw_bitcell11_13.bot ctl3 VDD VDD sg13_lv_pmos ad=0.39p pd=2.39u as=0.7p ps=4.7u w=2u l=0.13u
X282 cdac_array_1.topp sw_bitcell11_9.bot cap_cmim l=2.14u w=2.14u
X283 cdac_array_1.topp sw_bitcell11_15.bot cap_cmim l=2.14u w=2.14u
X284 cdac_array_1.topp sw_bitcell11_11.bot cap_cmim l=2.14u w=2.14u
X285 cdac_array_1.topp sw_bitcell11_9.bot cap_cmim l=2.14u w=2.14u
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
X377 sw_bitcell11_8.bot bstrap40_1.ckb bstrap40_0.out VDD sg13_lv_pmos ad=0.39p pd=2.39u as=0.7p ps=4.7u w=2u l=0.13u
X378 cdac_array_1.topp sw_bitcell11_9.bot cap_cmim l=2.14u w=2.14u
X379 cdac_array_1.topp sw_bitcell11_9.bot cap_cmim l=2.14u w=2.14u
X380 sw_tg_0.bot sw_bitcell11_8.bot cap_cmim l=2.14u w=2.14u
X381 cdac_array_1.topp sw_bitcell11_12.bot cap_cmim l=2.14u w=2.14u
X382 cdac_array_0.b0 bstrap40_1.ckb bstrap40_0.out VDD sg13_lv_pmos ad=0.39p pd=2.39u as=0.7p ps=4.7u w=2u l=0.13u
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
