lmm2024/sar-adc-8b-open/sar-chip/flow/librelane/config.yaml

# SPDX-FileCopyrightText: 2026 Simon Dorrer and Harald Pretl
# SPDX-License-Identifier: Apache-2.0 WITH SHL-2.1

meta:
  version: 3
  flow: Chip
  substituting_steps:

    # Magic reports some overlaps which can be ignored
    Checker.IllegalOverlap: null

    # Disable KLayout DRC
    #KLayout.DRC: null
    #Checker.KLayoutDRC: null

    # Disable Magic DRC
    #Magic.DRC: null
    #Checker.MagicDRC: null

    # Disable KLayout antenna check
    #KLayout.Antenna: null
    #Checker.KLayoutAntenna: null

    # Disable KLayout density check
    #KLayout.Density: null
    #Checker.KLayoutDensity: null

    # Save time
    #OpenROAD.IRDropReport: null
    #KLayout.XOR: null
    #Netgen.LVS: null
    #Checker.LVS: null

    # Use Magic.Filler instead of KLayout.Filler
    # This can help in some cases where the target
    # density cannot be met using KLayout.
    #KLayout.Filler: Magic.Filler

    # Disable KLayout filler (all layers)
    # TODO: add custom LibreLane step for filler insertion after ArtistIC added logo.
    KLayout.Filler: null

    # TODO: Add GDSFill

    # Disable setup-violation errors
    #Checker.SetupViolations: null

    # Fix hold violations by inserting buffers
    #"+OpenROAD.DetailedRouting": "Odb.InsertECOBuffers"
    #"+Odb.InsertECOBuffers": "OpenROAD.DetailedRouting"


# INSERT_ECO_BUFFERS:
#  - target: rst_n_pad/Y
#    buffer: sg13g2_buf_4

DESIGN_NAME: chip_top
VERILOG_FILES:
- dir::../../rtl/chip_top.sv
- dir::../../rtl/chip_core.sv

VERILOG_DEFINES: [FUNCTIONAL]

# Enable plugin for better SystemVerilog support
# USE_SLANG: True
# SLANG_ARGUMENTS: ['--keep-hierarchy']

# Slightly smaller file sizes
PRIMARY_GDSII_STREAMOUT_TOOL: klayout

# ================================================================
# Padframe layout: 8 pads per side, 32 user bondpads in total.
# Order convention:
#   - PAD_WEST  : bottom to top
#   - PAD_EAST  : bottom to top
#   - PAD_NORTH : left   to right
#   - PAD_SOUTH : left   to right
# Pad-cell instance names follow the generate-block hierarchy in
# rtl/chip_top.sv (e.g. "g_outputs[16].output_pad"). 
# See doc/pinout.md for the full pin table.
# ================================================================

# West (bottom to top): busy, VSS0, VDD0, IOVSS, IOVDD, start, rst_n, clk
PAD_WEST: [
    "g_outputs\\[9\\].output_pad",       # busy
    "g_vss_pads\\[0\\].vss_pad",         # VSS
    "g_vdd_pads\\[0\\].vdd_pad",         # VDD (1.5 V)
    "g_iovss_pads\\[0\\].iovss_pad",     # IOVSS
    "g_iovdd_pads\\[0\\].iovdd_pad",     # IOVDD (3.3 V)
    "g_inputs\\[0\\].input_pad",         # start
    rst_n_pad,                           # rst_n
    clk_pad                              # clk
]

# North (left to right): result[7:0]
PAD_NORTH: [
    "g_outputs\\[7\\].output_pad",       # result[7] (MSB)
    "g_outputs\\[6\\].output_pad",
    "g_outputs\\[5\\].output_pad",
    "g_outputs\\[4\\].output_pad",
    "g_outputs\\[3\\].output_pad",
    "g_outputs\\[2\\].output_pad",
    "g_outputs\\[1\\].output_pad",
    "g_outputs\\[0\\].output_pad"        # result[0] (LSB)
]

# South (left to right): VSS1, VDD1, done, outn(dbg), spare out x2, VDD2, VSS2
PAD_SOUTH: [
    "g_vss_pads\\[1\\].vss_pad",
    "g_vdd_pads\\[1\\].vdd_pad",
    "g_outputs\\[8\\].output_pad",       # done
    "g_outputs\\[10\\].output_pad",      # outn (raw comparator, debug)
    "g_outputs\\[11\\].output_pad",      # spare
    "g_outputs\\[12\\].output_pad",      # spare
    "g_vdd_pads\\[2\\].vdd_pad",
    "g_vss_pads\\[2\\].vss_pad"
]

# East (bottom to top): VSS3, vinn, vinp, vcm, VDD3, spare out x2, spare bidir
PAD_EAST: [
    "g_vss_pads\\[3\\].vss_pad",
    "g_analogs\\[1\\].analog_pad",       # vinn (padres)
    "g_analogs\\[0\\].analog_pad",       # vinp (padres)
    "g_analogs\\[2\\].analog_pad",       # vcm  (padres)
    "g_vdd_pads\\[3\\].vdd_pad",
    "g_outputs\\[13\\].output_pad",      # spare
    "g_outputs\\[14\\].output_pad",      # spare
    "g_bidirs\\[0\\].bidir_pad"          # spare bidir
]

# Pad spacing: each side offers 960 um between the corner cells for 8 x 80 um pads, leaving 320 um of fill.
# OpenROAD.PadRing floors the pad-to-pad gap to a multiple of PAD_SPACING_MULTIPLE and centers the row.
# The leftover at the two row ends must land on the 1 um IO site grid.
# The ideal gap between the 8 pads is fill / (pads + 1) = 320/9 = 35.56 um, floored to the multiple: gap = floor(35.56 / multiple) * multiple.
# With the default multiple of 1 um: gap = floor(35.56/1)*1 = 35 um and the ends get (320 - 7*35)/2 = 37.5 um --> off-grid error.
# With a multiple of 2 um: gap = floor(35.56/2)*2 = 34 um and the ends get (320 - 7*34)/2 = 41 um --> on-grid.
PAD_SPACING_MULTIPLE: 2

# SDC files
PNR_SDC_FILE:     dir::chip_top.sdc
SIGNOFF_SDC_FILE: dir::chip_top.sdc
FALLBACK_SDC:     dir::chip_top.sdc

# Power / ground nets
VDD_NETS: ["VDD"]
GND_NETS: ["VSS"]
VERILOG_POWER_DEFINE: "USE_POWER_PINS"

# Clock
CLOCK_PORT: clk_PAD
CLOCK_NET:  clk_pad/p2c

CLOCK_PERIOD: 10 # in ns == 100 MHz (10 MS/s x 9 cycles + margin)

# Floorplanning
FP_SIZING: absolute
DIE_AREA:  [0, 0, 1600, 1600]
CORE_AREA: [365, 365, 1235, 1235]

# Increase for more logic on your die
PL_TARGET_DENSITY_PCT: 10
GRT_ALLOW_CONGESTION:  true

# Bondpads
# Override bondpad name
PAD_BONDPAD_NAME: sg13g2_ip__bondpad_70x70

EXTRA_GDS:
- dir::../../ip/sg13g2_ip__bondpad_70x70/final/gds/sg13g2_ip__bondpad_70x70.gds

EXTRA_LEFS:
- dir::../../ip/sg13g2_ip__bondpad_70x70/final/lef/sg13g2_ip__bondpad_70x70.lef

IGNORE_DISCONNECTED_MODULES:
- sg13g2_ip__bondpad_70x70
- sg13g2_ip__jku
- sg13g2_ip__jku_names

# PDN
PDN_CORE_RING: True

# Maximum metal width without slotting: 30um
PDN_CORE_RING_VWIDTH: 15
PDN_CORE_RING_HWIDTH: 15
# Ensure minimum spacing for long metals
PDN_CORE_RING_VSPACING: 5
PDN_CORE_RING_HSPACING: 5

PDN_CORE_RING_CONNECT_TO_PADS: True
PDN_ENABLE_PINS: False

# Because we have multiple power pads for one power domain
MAGIC_EXT_UNIQUE: notopports

# Custom PDN config
PDN_CFG: dir::pdn_cfg.tcl

# SRAM power-net hookup. The SRAM has a secondary VDDARRAY!/VSS! domain in addition 
# to the standard VDD!/VSS! pair, so two PDN_MACRO_CONNECTIONS lines are required per instance.
# This is an alternative method compared to specifying the power connections in the RTL
PDN_MACRO_CONNECTIONS:
- "i_chip_core.sar_adc VDD VSS VDD VSS"

# Custom pad files for PADBARE
PAD_LEFS:           dir::../../ip/sg13g2_io_custom/lef/sg13g2_io.lef
PAD_VERILOG_MODELS: dir::../../ip/sg13g2_io_custom/verilog/sg13g2_io.v

# Technology LIBs
LIB:
  "*_fast_1p32V_m40C":
    - pdk_dir::libs.ref/sg13g2_stdcell/lib/sg13g2_stdcell_fast_1p32V_m40C.lib
    - dir::../../ip/sg13g2_io_custom/lib/sg13g2_io_fast_1p32V_3p6V_m40C.lib

  "*_fast_1p65V_m40C":
    - pdk_dir::libs.ref/sg13g2_stdcell/lib/sg13g2_stdcell_fast_1p65V_m40C.lib
    - dir::../../ip/sg13g2_io_custom/lib/sg13g2_io_fast_1p65V_3p6V_m40C.lib

  "*_slow_1p08V_125C":
    - pdk_dir::libs.ref/sg13g2_stdcell/lib/sg13g2_stdcell_slow_1p08V_125C.lib
    - dir::../../ip/sg13g2_io_custom/lib/sg13g2_io_slow_1p08V_3p0V_125C.lib

  "*_slow_1p35V_125C":
    - pdk_dir::libs.ref/sg13g2_stdcell/lib/sg13g2_stdcell_slow_1p35V_125C.lib
    - dir::../../ip/sg13g2_io_custom/lib/sg13g2_io_slow_1p35V_3p0V_125C.lib

  "*_typ_1p20V_25C":
    - pdk_dir::libs.ref/sg13g2_stdcell/lib/sg13g2_stdcell_typ_1p20V_25C.lib
    - dir::../../ip/sg13g2_io_custom/lib/sg13g2_io_typ_1p2V_3p3V_25C.lib

  "*_typ_1p50V_25C":
    - pdk_dir::libs.ref/sg13g2_stdcell/lib/sg13g2_stdcell_typ_1p50V_25C.lib
    - dir::../../ip/sg13g2_io_custom/lib/sg13g2_io_typ_1p5V_3p3V_25C.lib

# Corners
STA_CORNERS:
  - nom_fast_1p32V_m40C
  - nom_fast_1p65V_m40C
  - nom_slow_1p08V_125C
  - nom_slow_1p35V_125C
  - nom_typ_1p20V_25C
  - nom_typ_1p50V_25C

DEFAULT_CORNER: nom_typ_1p50V_25C

# Limit detailed routing to 10 iterations
# DRT_OPT_ITERS: 10

# Non-Default Rules (NDRs) for the following analog traces
# Note for the AUTO_TAPER_NDR_NETS variable:
# OpenROAD needs to be recompiled with the following patch when the AUTO_TAPER_NDR_NETS variable is changed from true (default) to false:
# https://github.com/FPGA-Research/heichips25-tapeout/blob/main/nix/disable_auto_taper.patch
# The AUTO_TAPER_NDR_NETS variable tells the detailed router whether it is allowed to automatically "shrink" those wide NDR wires to fit onto small pins.
# When Enabled (1 or true - Default): The router will automatically taper the wide wire down to the minimum width of the pin's metal layer as it makes the final connection.
# When Disabled (0 or false): The router will attempt to maintain the full NDR width all the way into the pin.
# Pending issue to change AUTO_TAPER_NDR_NETS in the LibreLane `config.yaml`: https://github.com/The-OpenROAD-Project/OpenROAD/issues/10032
NON_DEFAULT_RULES:
  # Rules for analog traces (inverter2 vin/vout pairs).
  # 0.5 um width and 0.5 um spacing on Metal1 through Metal5.
  NDR_analog:
    width:   [Metal1, "0.5", Metal2, "0.5", Metal3, "0.5", Metal4, "0.5", Metal5, "0.5"]
    spacing: [Metal1, "0.5", Metal2, "0.5", Metal3, "0.5", Metal4, "0.5", Metal5, "0.5"]
    via:     ["Via1_DC1B", "Via2_DC1B", "Via3_DC1B", "Via4_DC1B"]

# Apply NDRs to analog traces during detailed routing
DRT_ASSIGN_NDR:
  "^.*PADRES.*$":  NDR_analog
  "^.*PADBARE.*$": NDR_analog

# Do not touch analog traces --> no optimization or buffering
RSZ_DONT_TOUCH_LIST:
- "analog_PADRES[0]"
- "analog_PADRES[1]"
- "analog_PADRES[2]"

MACROS:
  # ----------------------------------------------------------------
  # OA-SAR8: 8-bit differential SAR ADC hard macro (analog + SAR logic)
  # ----------------------------------------------------------------
  oa_sar8_core16:
    gds:
      - dir::../../macros/oa_sar8/final/gds/oa_sar8_core16.gds
    lef:
      - dir::../../macros/oa_sar8/final/lef/oa_sar8_core16.lef
    vh:
      - dir::../../macros/oa_sar8/final/vh/oa_sar8_core16.v
    instances:
      i_chip_core.sar_adc:
        location: [expr::(0.48 * 1250), expr::(0.42 * 1550)]   # x = 600.00, y = 651.00 (core center-ish)
        orientation: N

  # ----------------------------------------------------------------
  # Logos
  # ----------------------------------------------------------------
  sg13g2_ip__jku:
    gds:
      - dir::../../ip/sg13g2_ip__jku/final/gds/sg13g2_ip__jku.gds
    lef:
      - dir::../../ip/sg13g2_ip__jku/final/lef/sg13g2_ip__jku.lef
    vh:
      - dir::../../ip/sg13g2_ip__jku/final/vh/sg13g2_ip__jku.v
    lib:
      "*":
        - dir::../../ip/sg13g2_ip__jku/final/lib/sg13g2_ip__jku.lib
    instances:
      jku_logo:
        location: ["expr::$DIE_AREA[0] + 36.4 + 20.4", "expr::$DIE_AREA[3] - 36.4 - 120.4"]
        orientation: N

  sg13g2_ip__jku_names:
    gds:
      - dir::../../ip/sg13g2_ip__jku_names/final/gds/sg13g2_ip__jku_names.gds
    lef:
      - dir::../../ip/sg13g2_ip__jku_names/final/lef/sg13g2_ip__jku_names.lef
    vh:
      - dir::../../ip/sg13g2_ip__jku_names/final/vh/sg13g2_ip__jku_names.v
    lib:
      "*":
        - dir::../../ip/sg13g2_ip__jku_names/final/lib/sg13g2_ip__jku_names.lib
    instances:
      jku_names:
        location: ["expr::$DIE_AREA[2] - 36.4 - 120.4", "expr::$DIE_AREA[3] - 36.4 - 120.4"]
        orientation: N

MAGIC_GDS_FLATGLOB:
 # For DRC of SRAM macros
 - "lvsres_*"
 - "VIA_M1_*"
 - "VIA_M2_*"
 - "*_CELL_CORNER"
 - "RSC_*"
 - "*_CELL_SUB"
