lmm2024/sar-adc-8b-open/sar-adc/logic/final/pnl/sar_ctrl.pnl.v

module sar_ctrl (busy,
    clk,
    clk_cmp,
    cmp,
    cmp_n,
    done,
    hold,
    rst_n,
    sample,
    start,
    VDD,
    VSS,
    dac_code,
    dac_code_n,
    result);
 output busy;
 input clk;
 output clk_cmp;
 input cmp;
 input cmp_n;
 output done;
 output hold;
 input rst_n;
 output sample;
 input start;
 inout VDD;
 inout VSS;
 output [7:0] dac_code;
 output [7:0] dac_code_n;
 output [7:0] result;

 wire _000_;
 wire _001_;
 wire _002_;
 wire _003_;
 wire _004_;
 wire _005_;
 wire _006_;
 wire _007_;
 wire _008_;
 wire _009_;
 wire clknet_0_clk;
 wire _011_;
 wire _012_;
 wire _013_;
 wire _014_;
 wire _015_;
 wire _016_;
 wire _017_;
 wire _018_;
 wire _019_;
 wire _020_;
 wire _021_;
 wire _022_;
 wire _023_;
 wire _024_;
 wire _025_;
 wire _026_;
 wire _027_;
 wire _028_;
 wire _029_;
 wire _030_;
 wire _031_;
 wire _032_;
 wire _033_;
 wire _034_;
 wire _035_;
 wire _036_;
 wire _037_;
 wire _038_;
 wire _039_;
 wire _040_;
 wire _041_;
 wire _042_;
 wire _043_;
 wire _044_;
 wire _045_;
 wire _046_;
 wire _047_;
 wire _048_;
 wire _049_;
 wire _050_;
 wire _051_;
 wire _052_;
 wire _053_;
 wire _054_;
 wire _055_;
 wire _056_;
 wire _057_;
 wire _058_;
 wire _059_;
 wire _060_;
 wire _061_;
 wire _062_;
 wire _063_;
 wire _064_;
 wire _065_;
 wire _066_;
 wire _067_;
 wire _068_;
 wire _069_;
 wire _070_;
 wire _071_;
 wire _072_;
 wire _073_;
 wire _074_;
 wire _075_;
 wire _076_;
 wire _077_;
 wire _078_;
 wire _079_;
 wire _080_;
 wire _081_;
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
 sg13g2_buf_1 output9 (.A(net9),
    .X(dac_code[2]),
    .VDD(VDD),
    .VSS(VSS));
 sg13g2_nand2_1 u_sr_q (.Y(cmp_q),
    .A(net2),
    .B(cmp_qb),
    .VDD(VDD),
    .VSS(VSS));
 sg13g2_nand2_1 u_sr_qb (.Y(cmp_qb),
    .A(net1),
    .B(cmp_q),
    .VDD(VDD),
    .VSS(VSS));
endmodule
