lmm2024/sar-adc-8b-open/sar-adc/logic/final_async_phys/nl/sar_ctrl_async_phys.nl.v

module sar_ctrl_async_phys (busy,
    cmp_fault,
    cmp_fire,
    cmp_n,
    cmp_p,
    cmp_valid,
    done,
    hold_req,
    rst_n,
    sample,
    track,
    bit_active,
    dac_code,
    dac_code_n,
    result);
 output busy;
 output cmp_fault;
 output cmp_fire;
 input cmp_n;
 input cmp_p;
 output cmp_valid;
 output done;
 output hold_req;
 input rst_n;
 output sample;
 input track;
 output [7:0] bit_active;
 output [7:0] dac_code;
 output [7:0] dac_code_n;
 output [7:0] result;

 wire _000_;
 wire _001_;
 wire _002_;
 wire _003_;
 wire _004_;
 wire _005_;
 wire _006_;
 wire _007_;
 wire _008_;
 wire _009_;
 wire _010_;
 wire _011_;
 wire _012_;
 wire _013_;
 wire _014_;
 wire _015_;
 wire _016_;
 wire _017_;
 wire _018_;
 wire _019_;
 wire _020_;
 wire _021_;
 wire _022_;
 wire _023_;
 wire _024_;
 wire _025_;
 wire _026_;
 wire _027_;
 wire _028_;
 wire _029_;
 wire _030_;
 wire _031_;
 wire _032_;
 wire _033_;
 wire _034_;
 wire _035_;
 wire _036_;
 wire _037_;
 wire _038_;
 wire _039_;
 wire _040_;
 wire _041_;
 wire _042_;
 wire _043_;
 wire _044_;
 wire _045_;
 wire _046_;
 wire _047_;
 wire _048_;
 wire _049_;
 wire _050_;
 wire _051_;
 wire _052_;
 wire _053_;
 wire _054_;
 wire _055_;
 wire \active_reg[0] ;
 wire \active_reg[1] ;
 wire \active_reg[2] ;
 wire \active_reg[3] ;
 wire \active_reg[4] ;
 wire \active_reg[5] ;
 wire \active_reg[6] ;
 wire \active_reg[7] ;
 wire net4;
 wire net5;
 wire net6;
 wire net7;
 wire net8;
 wire net9;
 wire net10;
 wire net11;
 wire net12;
 wire cmp_decision_hold;
 wire net13;
 wire net14;
 wire net1;
 wire net2;
 wire net15;
 wire net16;
 wire net17;
 wire net18;
 wire net19;
 wire net20;
 wire net21;
 wire net22;
 wire net23;
 wire net24;
 wire net25;
 wire net26;
 wire net27;
 wire net28;
 wire net29;
 wire net30;
 wire net31;
 wire decision_hold_reset;
 wire decision_hold_set;
 wire net32;
 wire event_pending;
 wire event_pending_reset;
 wire guard_request;
 wire guard_request_delayed;
 wire guard_reset;
 wire guard_set;
 wire hold_elapsed;
 wire hold_elapsed_tail;
 wire net33;
 wire net34;
 wire net35;
 wire net36;
 wire net37;
 wire net38;
 wire net39;
 wire net40;
 wire net41;
 wire net3;
 wire net42;
 wire sar_event_raw;
 wire settle_ready;
 wire track_n;
 wire \u_decision_hold.q_n ;
 wire \u_event_clock_delay.t0 ;
 wire \u_event_pending.q_n ;
 wire \u_hold_delay.t0 ;
 wire \u_hold_delay.t1 ;
 wire \u_hold_delay.t2 ;
 wire \u_interbit_delay.t0 ;
 wire \u_interbit_delay.t1 ;
 wire \u_launch_width.t0 ;
 wire \u_launch_width.t1 ;
 wire \u_launch_width.t2 ;
 wire \u_settle_latch.q_n ;
 wire net43;
 wire net44;
 wire net45;
 wire net46;
 wire net47;
 wire net48;
 wire net49;
 wire net50;
 wire net51;
 wire net52;
 wire net53;
 wire net54;

 sg13g2_decap_8 FILLER_0_0 ();
 sg13g2_decap_8 FILLER_0_14 ();
 sg13g2_decap_8 FILLER_0_21 ();
 sg13g2_decap_8 FILLER_0_28 ();
 sg13g2_decap_8 FILLER_0_35 ();
 sg13g2_decap_8 FILLER_0_42 ();
 sg13g2_decap_8 FILLER_0_49 ();
 sg13g2_fill_2 FILLER_0_56 ();
 sg13g2_decap_8 FILLER_0_61 ();
 sg13g2_decap_8 FILLER_0_68 ();
 sg13g2_decap_8 FILLER_0_7 ();
 sg13g2_decap_8 FILLER_10_0 ();
 sg13g2_decap_8 FILLER_10_15 ();
 sg13g2_decap_8 FILLER_10_22 ();
 sg13g2_decap_8 FILLER_10_29 ();
 sg13g2_decap_8 FILLER_10_40 ();
 sg13g2_decap_8 FILLER_10_47 ();
 sg13g2_decap_4 FILLER_10_54 ();
 sg13g2_fill_2 FILLER_10_58 ();
 sg13g2_decap_4 FILLER_10_65 ();
 sg13g2_fill_2 FILLER_10_69 ();
 sg13g2_fill_2 FILLER_10_7 ();
 sg13g2_decap_8 FILLER_10_75 ();
 sg13g2_decap_4 FILLER_10_82 ();
 sg13g2_fill_1 FILLER_10_9 ();
 sg13g2_fill_2 FILLER_11_0 ();
 sg13g2_fill_2 FILLER_11_16 ();
 sg13g2_fill_1 FILLER_11_2 ();
 sg13g2_decap_8 FILLER_11_23 ();
 sg13g2_fill_2 FILLER_11_30 ();
 sg13g2_fill_1 FILLER_11_32 ();
 sg13g2_decap_8 FILLER_11_72 ();
 sg13g2_decap_8 FILLER_11_79 ();
 sg13g2_decap_8 FILLER_11_86 ();
 sg13g2_decap_4 FILLER_11_93 ();
 sg13g2_fill_1 FILLER_11_97 ();
 sg13g2_fill_2 FILLER_12_0 ();
 sg13g2_fill_1 FILLER_12_113 ();
 sg13g2_fill_1 FILLER_12_28 ();
 sg13g2_fill_2 FILLER_12_38 ();
 sg13g2_fill_1 FILLER_12_40 ();
 sg13g2_fill_1 FILLER_12_45 ();
 sg13g2_fill_2 FILLER_12_78 ();
 sg13g2_fill_1 FILLER_12_80 ();
 sg13g2_fill_1 FILLER_13_0 ();
 sg13g2_fill_1 FILLER_13_113 ();
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
    .X(net9));
 sg13g2_nor2b_1 _073_ (.A(net45),
    .B_N(net9),
    .Y(_004_));
 sg13g2_nand2b_1 _074_ (.Y(net28),
    .B(net46),
    .A_N(_013_));
 sg13g2_a21oi_1 _075_ (.A1(_054_),
    .A2(\active_reg[4] ),
    .Y(_036_),
    .B1(net28));
 sg13g2_nor2_1 _076_ (.A(_004_),
    .B(_036_),
    .Y(_021_));
 sg13g2_and2_1 _077_ (.A(net48),
    .B(\active_reg[4] ),
    .X(net8));
 sg13g2_nor2b_1 _078_ (.A(net45),
    .B_N(net8),
    .Y(_003_));
 sg13g2_nand2b_1 _079_ (.Y(net27),
    .B(net46),
    .A_N(_012_));
 sg13g2_a21oi_1 _080_ (.A1(_054_),
    .A2(\active_reg[3] ),
    .Y(_037_),
    .B1(net27));
 sg13g2_nor2_1 _081_ (.A(_003_),
    .B(_037_),
    .Y(_020_));
 sg13g2_and2_1 _082_ (.A(net49),
    .B(\active_reg[3] ),
    .X(net7));
 sg13g2_nor2b_1 _083_ (.A(net44),
    .B_N(net7),
    .Y(_002_));
 sg13g2_nand2b_1 _084_ (.Y(net26),
    .B(net46),
    .A_N(_011_));
 sg13g2_a21oi_1 _085_ (.A1(_054_),
    .A2(\active_reg[2] ),
    .Y(_038_),
    .B1(net26));
 sg13g2_nor2_1 _086_ (.A(_002_),
    .B(_038_),
    .Y(_019_));
 sg13g2_and2_1 _087_ (.A(net49),
    .B(\active_reg[2] ),
    .X(net6));
 sg13g2_nor2b_1 _088_ (.A(net45),
    .B_N(net6),
    .Y(_001_));
 sg13g2_nand2b_1 _089_ (.Y(net25),
    .B(net46),
    .A_N(_010_));
 sg13g2_a21oi_1 _090_ (.A1(_054_),
    .A2(\active_reg[1] ),
    .Y(_039_),
    .B1(net25));
 sg13g2_nor2_1 _091_ (.A(_001_),
    .B(_039_),
    .Y(_018_));
 sg13g2_and2_1 _092_ (.A(net49),
    .B(\active_reg[1] ),
    .X(net5));
 sg13g2_nor2b_1 _093_ (.A(net45),
    .B_N(net5),
    .Y(_000_));
 sg13g2_nand2b_1 _094_ (.Y(net24),
    .B(net46),
    .A_N(_009_));
 sg13g2_a21oi_1 _095_ (.A1(_054_),
    .A2(\active_reg[0] ),
    .Y(_040_),
    .B1(net24));
 sg13g2_nor2_1 _096_ (.A(_000_),
    .B(_040_),
    .Y(_017_));
 sg13g2_nor2_1 _097_ (.A(net1),
    .B(net2),
    .Y(net13));
 sg13g2_and2_1 _098_ (.A(net1),
    .B(net2),
    .X(_041_));
 sg13g2_inv_1 _099_ (.Y(net15),
    .A(_041_));
 sg13g2_o21ai_1 _100_ (.B1(net50),
    .Y(_042_),
    .A1(net1),
    .A2(net2));
 sg13g2_nor2_1 _101_ (.A(net1),
    .B(_042_),
    .Y(decision_hold_set));
 sg13g2_nor2_1 _102_ (.A(_007_),
    .B(guard_request),
    .Y(_043_));
 sg13g2_and2_1 _103_ (.A(guard_request_delayed),
    .B(_043_),
    .X(guard_set));
 sg13g2_nand3b_1 _104_ (.B(net52),
    .C(net50),
    .Y(decision_hold_reset),
    .A_N(guard_set));
 sg13g2_nor2_1 _105_ (.A(track),
    .B(hold_elapsed_tail),
    .Y(_044_));
 sg13g2_nand3_1 _106_ (.B(_041_),
    .C(_044_),
    .A(hold_elapsed),
    .Y(_045_));
 sg13g2_o21ai_1 _107_ (.B1(_045_),
    .Y(sar_event_raw),
    .A1(_041_),
    .A2(_042_));
 sg13g2_o21ai_1 _108_ (.B1(net53),
    .Y(event_pending_reset),
    .A1(_055_),
    .A2(sar_event_raw));
 sg13g2_nand2_1 _109_ (.Y(guard_reset),
    .A(net52),
    .B(_043_));
 sg13g2_nor2_1 _110_ (.A(net50),
    .B(track_n),
    .Y(net42));
 sg13g2_nand2b_1 _111_ (.Y(_046_),
    .B(settle_ready),
    .A_N(event_pending));
 sg13g2_nor4_1 _112_ (.A(_007_),
    .B(guard_request),
    .C(net15),
    .D(_046_),
    .Y(net14));
 sg13g2_nand2_1 _113_ (.Y(_008_),
    .A(net50),
    .B(net45));
 sg13g2_inv_1 _114_ (.Y(net4),
    .A(net43));
 sg13g2_nand2_1 _115_ (.Y(net16),
    .A(net47),
    .B(_009_));
 sg13g2_nand2_1 _116_ (.Y(net17),
    .A(net47),
    .B(_010_));
 sg13g2_nand2_1 _117_ (.Y(net18),
    .A(net47),
    .B(_011_));
 sg13g2_nand2_1 _118_ (.Y(net19),
    .A(net46),
    .B(_012_));
 sg13g2_nand2_1 _119_ (.Y(net20),
    .A(net47),
    .B(_013_));
 sg13g2_nand2_1 _120_ (.Y(net21),
    .A(net46),
    .B(_014_));
 sg13g2_nand2_1 _121_ (.Y(net22),
    .A(net49),
    .B(_015_));
 sg13g2_nand2_1 _122_ (.Y(net23),
    .A(net49),
    .B(_016_));
 sg13g2_nand2b_1 _123_ (.Y(net31),
    .B(net46),
    .A_N(_016_));
 sg13g2_a22oi_1 _124_ (.Y(_047_),
    .B1(net43),
    .B2(net34),
    .A2(_040_),
    .A1(net44));
 sg13g2_inv_1 _125_ (.Y(_025_),
    .A(_047_));
 sg13g2_a22oi_1 _126_ (.Y(_048_),
    .B1(net43),
    .B2(net35),
    .A2(_039_),
    .A1(net44));
 sg13g2_inv_1 _127_ (.Y(_026_),
    .A(_048_));
 sg13g2_a22oi_1 _128_ (.Y(_049_),
    .B1(net43),
    .B2(net36),
    .A2(_038_),
    .A1(net44));
 sg13g2_inv_1 _129_ (.Y(_027_),
    .A(_049_));
 sg13g2_a22oi_1 _130_ (.Y(_050_),
    .B1(_008_),
    .B2(net37),
    .A2(_037_),
    .A1(net44));
 sg13g2_inv_1 _131_ (.Y(_028_),
    .A(_050_));
 sg13g2_a22oi_1 _132_ (.Y(_051_),
    .B1(net43),
    .B2(net38),
    .A2(_036_),
    .A1(net44));
 sg13g2_inv_1 _133_ (.Y(_029_),
    .A(_051_));
 sg13g2_a22oi_1 _134_ (.Y(_052_),
    .B1(net43),
    .B2(net39),
    .A2(_035_),
    .A1(net44));
 sg13g2_inv_1 _135_ (.Y(_030_),
    .A(_052_));
 sg13g2_a22oi_1 _136_ (.Y(_053_),
    .B1(net43),
    .B2(net40),
    .A2(_034_),
    .A1(net44));
 sg13g2_inv_1 _137_ (.Y(_031_),
    .A(_053_));
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
    .X(dac_code[6]));
 sg13g2_buf_1 output23 (.A(net23),
    .X(dac_code[7]));
 sg13g2_buf_1 output24 (.A(net24),
    .X(dac_code_n[0]));
 sg13g2_buf_1 output25 (.A(net25),
    .X(dac_code_n[1]));
 sg13g2_buf_1 output26 (.A(net26),
    .X(dac_code_n[2]));
 sg13g2_buf_1 output27 (.A(net27),
    .X(dac_code_n[3]));
 sg13g2_buf_1 output28 (.A(net28),
    .X(dac_code_n[4]));
 sg13g2_buf_1 output29 (.A(net29),
    .X(dac_code_n[5]));
 sg13g2_buf_1 output30 (.A(net30),
    .X(dac_code_n[6]));
 sg13g2_buf_1 output31 (.A(net31),
    .X(dac_code_n[7]));
 sg13g2_buf_1 output32 (.A(net32),
    .X(done));
 sg13g2_buf_1 output33 (.A(net33),
    .X(hold_req));
 sg13g2_buf_1 output34 (.A(net34),
    .X(result[0]));
 sg13g2_buf_1 output35 (.A(net35),
    .X(result[1]));
 sg13g2_buf_1 output36 (.A(net36),
    .X(result[2]));
 sg13g2_buf_1 output37 (.A(net37),
    .X(result[3]));
 sg13g2_buf_1 output38 (.A(net38),
    .X(result[4]));
 sg13g2_buf_1 output39 (.A(net39),
    .X(result[5]));
 sg13g2_buf_1 output4 (.A(net4),
    .X(bit_active[0]));
 sg13g2_buf_1 output40 (.A(net40),
    .X(result[6]));
 sg13g2_buf_1 output41 (.A(net41),
    .X(result[7]));
 sg13g2_buf_1 output42 (.A(net42),
    .X(sample));
 sg13g2_buf_1 output5 (.A(net5),
    .X(bit_active[1]));
 sg13g2_buf_1 output6 (.A(net6),
    .X(bit_active[2]));
 sg13g2_buf_1 output7 (.A(net7),
    .X(bit_active[3]));
 sg13g2_buf_1 output8 (.A(net8),
    .X(bit_active[4]));
 sg13g2_buf_1 output9 (.A(net9),
    .X(bit_active[5]));
 sg13g2_nor2_1 \u_decision_hold.u_q  (.A(decision_hold_reset),
    .B(\u_decision_hold.q_n ),
    .Y(cmp_decision_hold));
 sg13g2_nor2_1 \u_decision_hold.u_qn  (.A(decision_hold_set),
    .B(cmp_decision_hold),
    .Y(\u_decision_hold.q_n ));
 sg13g2_dlygate4sd3_1 \u_event_clock_delay.u_d0  (.A(event_pending),
    .X(\u_event_clock_delay.t0 ));
 sg13g2_dlygate4sd3_1 \u_event_clock_delay.u_d1  (.A(\u_event_clock_delay.t0 ),
    .X(guard_request));
 sg13g2_nor2_1 \u_event_pending.u_q  (.A(event_pending_reset),
    .B(\u_event_pending.q_n ),
    .Y(event_pending));
 sg13g2_nor2_1 \u_event_pending.u_qn  (.A(sar_event_raw),
    .B(event_pending),
    .Y(\u_event_pending.q_n ));
 sg13g2_dlygate4sd3_1 \u_hold_delay.u_d0  (.A(track_n),
    .X(\u_hold_delay.t0 ));
 sg13g2_dlygate4sd3_1 \u_hold_delay.u_d1  (.A(\u_hold_delay.t0 ),
    .X(\u_hold_delay.t1 ));
 sg13g2_dlygate4sd3_1 \u_hold_delay.u_d2  (.A(\u_hold_delay.t1 ),
    .X(\u_hold_delay.t2 ));
 sg13g2_dlygate4sd3_1 \u_hold_delay.u_d3  (.A(\u_hold_delay.t2 ),
    .X(hold_elapsed));
 sg13g2_dlygate4sd3_1 \u_interbit_delay.u_d0  (.A(guard_request),
    .X(\u_interbit_delay.t0 ));
 sg13g2_dlygate4sd3_1 \u_interbit_delay.u_d1  (.A(\u_interbit_delay.t0 ),
    .X(\u_interbit_delay.t1 ));
 sg13g2_dlygate4sd3_1 \u_interbit_delay.u_d2  (.A(\u_interbit_delay.t1 ),
    .X(guard_request_delayed));
 sg13g2_dlygate4sd3_1 \u_launch_width.u_d0  (.A(hold_elapsed),
    .X(\u_launch_width.t0 ));
 sg13g2_dlygate4sd3_1 \u_launch_width.u_d1  (.A(\u_launch_width.t0 ),
    .X(\u_launch_width.t1 ));
 sg13g2_dlygate4sd3_1 \u_launch_width.u_d2  (.A(\u_launch_width.t1 ),
    .X(\u_launch_width.t2 ));
 sg13g2_dlygate4sd3_1 \u_launch_width.u_d3  (.A(\u_launch_width.t2 ),
    .X(hold_elapsed_tail));
 sg13g2_nor2_1 \u_settle_latch.u_q  (.A(guard_reset),
    .B(\u_settle_latch.q_n ),
    .Y(settle_ready));
 sg13g2_nor2_1 \u_settle_latch.u_qn  (.A(guard_set),
    .B(settle_ready),
    .Y(\u_settle_latch.q_n ));
endmodule
