lmm2024/sar-adc-8b-open/sar-adc/logic/final_async_phys/pnl/sar_ctrl_async_phys.pnl.v

module sar_ctrl_async_phys (busy,
    cmp_fault,
    cmp_fire,
    cmp_n,
    cmp_p,
    cmp_valid,
    done,
    hold_req,
    rst_n,
    sample,
    track,
    VDD,
    VSS,
    bit_active,
    dac_code,
    dac_code_n,
    result);
 output busy;
 output cmp_fault;
 output cmp_fire;
 input cmp_n;
 input cmp_p;
 output cmp_valid;
 output done;
 output hold_req;
 input rst_n;
 output sample;
 input track;
 inout VDD;
 inout VSS;
 output [7:0] bit_active;
 output [7:0] dac_code;
 output [7:0] dac_code_n;
 output [7:0] result;

 wire _000_;
 wire _001_;
 wire _002_;
 wire _003_;
 wire _004_;
 wire _005_;
 wire _006_;
 wire _007_;
 wire _008_;
 wire _009_;
 wire _010_;
 wire _011_;
 wire _012_;
 wire _013_;
 wire _014_;
 wire _015_;
 wire _016_;
 wire _017_;
 wire _018_;
 wire _019_;
 wire _020_;
 wire _021_;
 wire _022_;
 wire _023_;
 wire _024_;
 wire _025_;
 wire _026_;
 wire _027_;
 wire _028_;
 wire _029_;
 wire _030_;
 wire _031_;
 wire _032_;
 wire _033_;
 wire _034_;
 wire _035_;
 wire _036_;
 wire _037_;
 wire _038_;
 wire _039_;
 wire _040_;
 wire _041_;
 wire _042_;
 wire _043_;
 wire _044_;
 wire _045_;
 wire _046_;
 wire _047_;
 wire _048_;
 wire _049_;
 wire _050_;
 wire _051_;
 wire _052_;
 wire _053_;
 wire _054_;
 wire _055_;
 wire \active_reg[0] ;
 wire \active_reg[1] ;
 wire \active_reg[2] ;
 wire \active_reg[3] ;
 wire \active_reg[4] ;
 wire \active_reg[5] ;
 wire \active_reg[6] ;
 wire \active_reg[7] ;
 wire net4;
 wire net5;
 wire net6;
 wire net7;
 wire net8;
 wire net9;
 wire net10;
 wire net11;
 wire net12;
 wire cmp_decision_hold;
 wire net13;
 wire net14;
 wire net1;
 wire net2;
 wire net15;
 wire net16;
 wire net17;
 wire net18;
 wire net19;
 wire net20;
 wire net21;
 wire net22;
 wire net23;
 wire net24;
 wire net25;
 wire net26;
 wire net27;
 wire net28;
 wire net29;
 wire net30;
 wire net31;
 wire decision_hold_reset;
 wire decision_hold_set;
 wire net32;
 wire event_pending;
 wire event_pending_reset;
 wire guard_request;
 wire guard_request_delayed;
 wire guard_reset;
 wire guard_set;
 wire hold_elapsed;
 wire hold_elapsed_tail;
 wire net33;
 wire net34;
 wire net35;
 wire net36;
 wire net37;
 wire net38;
 wire net39;
 wire net40;
 wire net41;
 wire net3;
 wire net42;
 wire sar_event_raw;
 wire settle_ready;
 wire track_n;
 wire \u_decision_hold.q_n ;
 wire \u_event_clock_delay.t0 ;
 wire \u_event_pending.q_n ;
 wire \u_hold_delay.t0 ;
 wire \u_hold_delay.t1 ;
 wire \u_hold_delay.t2 ;
 wire \u_interbit_delay.t0 ;
 wire \u_interbit_delay.t1 ;
 wire \u_launch_width.t0 ;
 wire \u_launch_width.t1 ;
 wire \u_launch_width.t2 ;
 wire \u_settle_latch.q_n ;
 wire net43;
 wire net44;
 wire net45;
 wire net46;
 wire net47;
 wire net48;
 wire net49;
 wire net50;
 wire net51;
 wire net52;
 wire net53;
 wire net54;

 sg13g2_decap_8 FILLER_0_0 (.VDD(VDD),
    .VSS(VSS));
 sg13g2_decap_8 FILLER_0_14 (.VDD(VDD),
    .VSS(VSS));
 sg13g2_decap_8 FILLER_0_21 (.VDD(VDD),
    .VSS(VSS));
 sg13g2_decap_8 FILLER_0_28 (.VDD(VDD),
    .VSS(VSS));
 sg13g2_decap_8 FILLER_0_35 (.VDD(VDD),
    .VSS(VSS));
 sg13g2_decap_8 FILLER_0_42 (.VDD(VDD),
    .VSS(VSS));
 sg13g2_decap_8 FILLER_0_49 (.VDD(VDD),
    .VSS(VSS));
 sg13g2_fill_2 FILLER_0_56 (.VDD(VDD),
    .VSS(VSS));
 sg13g2_decap_8 FILLER_0_61 (.VDD(VDD),
    .VSS(VSS));
 sg13g2_decap_8 FILLER_0_68 (.VDD(VDD),
    .VSS(VSS));
 sg13g2_decap_8 FILLER_0_7 (.VDD(VDD),
    .VSS(VSS));
 sg13g2_decap_8 FILLER_10_0 (.VDD(VDD),
    .VSS(VSS));
 sg13g2_decap_8 FILLER_10_15 (.VDD(VDD),
    .VSS(VSS));
 sg13g2_decap_8 FILLER_10_22 (.VDD(VDD),
    .VSS(VSS));
 sg13g2_decap_8 FILLER_10_29 (.VDD(VDD),
    .VSS(VSS));
 sg13g2_decap_8 FILLER_10_40 (.VDD(VDD),
    .VSS(VSS));
 sg13g2_decap_8 FILLER_10_47 (.VDD(VDD),
    .VSS(VSS));
 sg13g2_decap_4 FILLER_10_54 (.VDD(VDD),
    .VSS(VSS));
 sg13g2_fill_2 FILLER_10_58 (.VDD(VDD),
    .VSS(VSS));
 sg13g2_decap_4 FILLER_10_65 (.VDD(VDD),
    .VSS(VSS));
 sg13g2_fill_2 FILLER_10_69 (.VDD(VDD),
    .VSS(VSS));
 sg13g2_fill_2 FILLER_10_7 (.VDD(VDD),
    .VSS(VSS));
 sg13g2_decap_8 FILLER_10_75 (.VDD(VDD),
    .VSS(VSS));
 sg13g2_decap_4 FILLER_10_82 (.VDD(VDD),
    .VSS(VSS));
 sg13g2_fill_1 FILLER_10_9 (.VDD(VDD),
    .VSS(VSS));
 sg13g2_fill_2 FILLER_11_0 (.VDD(VDD),
    .VSS(VSS));
 sg13g2_fill_2 FILLER_11_16 (.VDD(VDD),
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
    .X(bit_active[5]),
    .VDD(VDD),
    .VSS(VSS));
 sg13g2_nor2_1 \u_decision_hold.u_q  (.A(decision_hold_reset),
    .B(\u_decision_hold.q_n ),
    .Y(cmp_decision_hold),
    .VDD(VDD),
    .VSS(VSS));
 sg13g2_nor2_1 \u_decision_hold.u_qn  (.A(decision_hold_set),
    .B(cmp_decision_hold),
    .Y(\u_decision_hold.q_n ),
    .VDD(VDD),
    .VSS(VSS));
 sg13g2_dlygate4sd3_1 \u_event_clock_delay.u_d0  (.A(event_pending),
    .VDD(VDD),
    .VSS(VSS),
    .X(\u_event_clock_delay.t0 ));
 sg13g2_dlygate4sd3_1 \u_event_clock_delay.u_d1  (.A(\u_event_clock_delay.t0 ),
    .VDD(VDD),
    .VSS(VSS),
    .X(guard_request));
 sg13g2_nor2_1 \u_event_pending.u_q  (.A(event_pending_reset),
    .B(\u_event_pending.q_n ),
    .Y(event_pending),
    .VDD(VDD),
    .VSS(VSS));
 sg13g2_nor2_1 \u_event_pending.u_qn  (.A(sar_event_raw),
    .B(event_pending),
    .Y(\u_event_pending.q_n ),
    .VDD(VDD),
    .VSS(VSS));
 sg13g2_dlygate4sd3_1 \u_hold_delay.u_d0  (.A(track_n),
    .VDD(VDD),
    .VSS(VSS),
    .X(\u_hold_delay.t0 ));
 sg13g2_dlygate4sd3_1 \u_hold_delay.u_d1  (.A(\u_hold_delay.t0 ),
    .VDD(VDD),
    .VSS(VSS),
    .X(\u_hold_delay.t1 ));
 sg13g2_dlygate4sd3_1 \u_hold_delay.u_d2  (.A(\u_hold_delay.t1 ),
    .VDD(VDD),
    .VSS(VSS),
    .X(\u_hold_delay.t2 ));
 sg13g2_dlygate4sd3_1 \u_hold_delay.u_d3  (.A(\u_hold_delay.t2 ),
    .VDD(VDD),
    .VSS(VSS),
    .X(hold_elapsed));
 sg13g2_dlygate4sd3_1 \u_interbit_delay.u_d0  (.A(guard_request),
    .VDD(VDD),
    .VSS(VSS),
    .X(\u_interbit_delay.t0 ));
 sg13g2_dlygate4sd3_1 \u_interbit_delay.u_d1  (.A(\u_interbit_delay.t0 ),
    .VDD(VDD),
    .VSS(VSS),
    .X(\u_interbit_delay.t1 ));
 sg13g2_dlygate4sd3_1 \u_interbit_delay.u_d2  (.A(\u_interbit_delay.t1 ),
    .VDD(VDD),
    .VSS(VSS),
    .X(guard_request_delayed));
 sg13g2_dlygate4sd3_1 \u_launch_width.u_d0  (.A(hold_elapsed),
    .VDD(VDD),
    .VSS(VSS),
    .X(\u_launch_width.t0 ));
 sg13g2_dlygate4sd3_1 \u_launch_width.u_d1  (.A(\u_launch_width.t0 ),
    .VDD(VDD),
    .VSS(VSS),
    .X(\u_launch_width.t1 ));
 sg13g2_dlygate4sd3_1 \u_launch_width.u_d2  (.A(\u_launch_width.t1 ),
    .VDD(VDD),
    .VSS(VSS),
    .X(\u_launch_width.t2 ));
 sg13g2_dlygate4sd3_1 \u_launch_width.u_d3  (.A(\u_launch_width.t2 ),
    .VDD(VDD),
    .VSS(VSS),
    .X(hold_elapsed_tail));
 sg13g2_nor2_1 \u_settle_latch.u_q  (.A(guard_reset),
    .B(\u_settle_latch.q_n ),
    .Y(settle_ready),
    .VDD(VDD),
    .VSS(VSS));
 sg13g2_nor2_1 \u_settle_latch.u_qn  (.A(guard_set),
    .B(settle_ready),
    .Y(\u_settle_latch.q_n ),
    .VDD(VDD),
    .VSS(VSS));
endmodule
