lmm2024/sar-adc-8b-open/sar-chip/macros/oa_sar8/final/vh/oa_sar8_core16.v

module oa_sar8_core16 (
`ifdef USE_POWER_PINS
    inout VDD,
    inout VSS,
`endif
    output busy,
    input  clk,
    output done,
    input  rst_n,
    input  start,
    input  vcm,
    input  vinn,
    input  vinp,
    output [7:0] result
);
endmodule
