lmm2024/sar-adc-8b-open/sar-adc/layout/gen_core12.py

#!/usr/bin/env python3
"""OA-SAR8 core v3 -- narrow-seam reference floorplan, full assembly:
verified acore3 + 50x100 logic strip in the seam (x 122..172).
West margin = 5-track M2 bus (VSS 118.5 | VDD 119.2 | clk 119.9 | cmp 120.6 |
sample 121.3). dac_code exits EAST as M2 jogs threading the replica's wide-M3
rail zone (M2-free corridor x 176.4..181.8), down to 8 ctl tracks (y -37.8..)
that run to the split switch-row ctl stubs. Digital S-pins re-exported."""
import pya

layout = pya.Layout()
layout.technology_name = "sg13g2"
layout.dbu = 0.001
top = layout.create_cell("oa_sar8_core12")

layout.read("oa_sar8_acore9.gds")
layout.read("/foss/designs/sar-adc/logic/final/gds/sar_ctrl.gds")
ac = layout.cell("oa_sar8_acore9")
lg = layout.cell("sar_ctrl")

L = {}
for num, name in ((10, "m2"), (29, "v2"), (30, "m3"), (49, "v3"), (50, "m4"), (8, "m1"), (126, "tm1"), (134, "tm2"), (66, "v4"), (67, "m5")):
    L[name] = layout.layer(num, 0)
for num, tag in ((10, "m2"), (30, "m3"), (8, "m1"), (126, "tm1"), (134, "tm2"), (50, "m4"), (67, "m5")):
    L[tag + "p"], L[tag + "l"] = layout.layer(num, 2), layout.layer(num, 25)


def rect(lay, x1, y1, x2, y2):
    top.shapes(L[lay]).insert(pya.DBox(x1, y1, x2, y2))


def snap(v):
    return round(round(v * 100) / 100.0, 2)


def via2(x, y):
    x1, y1 = snap(x - 0.095), snap(y - 0.095)
    rect("v2", x1, y1, x1 + 0.19, y1 + 0.19)
    rect("m2", x - 0.2, y - 0.2, x + 0.2, y + 0.2)
    rect("m3", x - 0.2, y - 0.2, x + 0.2, y + 0.2)


def vwire(x, y1, y2):
    rect("m2", x - 0.2, min(y1, y2), x + 0.2, max(y1, y2))


def via3(x, y):
    x1, y1 = snap(x - 0.095), snap(y - 0.095)
    rect("v3", x1, y1, x1 + 0.19, y1 + 0.19)
    rect("m3", x - 0.2, y - 0.2, x + 0.2, y + 0.2)
    rect("m4", x - 0.2, y - 0.2, x + 0.2, y + 0.2)


def v4wire(x, y1, y2):
    rect("m4", x - 0.2, min(y1, y2), x + 0.2, max(y1, y2))


top.insert(pya.DCellInstArray(ac.cell_index(), pya.DTrans()))
LX = 122.0
top.insert(pya.DCellInstArray(lg.cell_index(), pya.DTrans(pya.DVector(LX, 0.0))))

# ---- west margin joins: clk (@82.74) -> cmp clk bus ext (y 122.5)
rect("m3", 119.7, 82.54, LX + 0.4, 82.94)
via2(119.9, 82.74)
vwire(119.9, 82.74, 122.5)
via2(119.9, 122.5)

# ---- cmp: comparator outp ext (y 109.4) -> riser 120.6 -> logic cmp (@17.22)
via2(120.6, 109.4)
vwire(120.6, 17.22, 109.4)
via2(120.6, 17.22)
rect("m3", 120.4, 17.02, LX + 0.4, 17.42)

# ---- sample (@49.98) -> riser 121.3 -> trk bus (y -11.7)
rect("m3", 121.1, 49.78, LX + 0.4, 50.18)
via2(121.3, 49.98)
vwire(121.3, -11.7, 49.98)
via2(121.3, -11.7)

# ---- dac_code[k]: south pins -> straight M2 drops down the seam -> ctl tracks -> stubs
DAC_X = {k: LX + 30.24 - 0.96 * k for k in range(8)}       # dac0 152.24 .. dac7 145.52
DACN_X = {k: LX + 37.92 - 0.96 * k for k in range(8)}      # dac_n0 159.92 .. dac_n7 153.20
TRACK_Y = {k: -55.0 - 1.3 * k for k in range(8)}           # ctl tracks (P side)
TRACKN_Y = {k: -65.4 - 1.3 * k for k in range(8)}          # ctl_n tracks (N side)
STUB_X = {0: 7.0, 1: 20.8, 2: 34.6, 3: 48.4, 4: 62.2,
          5: 76.0, 6: 89.8, 7: 103.6}
STUBN_X = {k: 173.2 + 13.8 * (7 - k) for k in range(8)}    # ctl7n@173.2 .. ctl0n@269.8 (pin x)
DROPN_X = dict(STUBN_X); DROPN_X[7] = 176.0; DROPN_X[6] = 188.1   # riser x (dodge replica M5 columns)
CTL_Y = -14.1
DROPS = [(DAC_X[k], TRACK_Y[k], STUB_X[k], STUB_X[k]) for k in range(8)] + \
        [(DACN_X[k], TRACKN_Y[k], STUBN_X[k], DROPN_X[k]) for k in range(8)]
for xd, yt, xp, xs in DROPS:
    vwire(xd, -23.0, 0.4)                                # M2 drop into the pin metal
    via2(xd, -23.0)
    via3(xd, -23.0)
    v4wire(xd, yt, -23.0)
    via3(xd, yt)
    rect("m3", min(xs, xd) - 0.2, yt - 0.2, max(xs, xd) + 0.2, yt + 0.2)
    via3(xs, yt)
    if xs != xp:                                         # N-side dodge: M4 all the way to the pin height
        v4wire(xs, yt, CTL_Y)
        via3(xs, CTL_Y)
        rect("m3", min(xs, xp) - 0.2, CTL_Y - 0.2, max(xs, xp) + 0.2, CTL_Y + 0.2)
    else:
        v4wire(xs, yt, -22.0)
        via3(xs, -22.0)
        via2(xs, -22.0)
        vwire(xs, -22.0, CTL_Y)
        via2(xs, CTL_Y)

# ---- south digital pins re-export (M2 pins at strip bottom)
SPINS = [("rst_n", 12.00), ("start", 12.96)] + \
        [(f"result[{i}]", 13.92 + 0.96 * i) for i in range(8)] + \
        [("done", 21.60), ("busy", 22.56)]
YS = -74.7                                                     # macro south boundary
for name, xl in SPINS:
    x = LX + xl
    vwire(x, -23.0, 0.4)
    via2(x, -23.0)
    via3(x, -23.0)
    v4wire(x, YS, -23.0)
    top.shapes(L["m4p"]).insert(pya.DBox(x - 0.2, YS, x + 0.2, YS + 1.5))
    top.shapes(L["m4l"]).insert(pya.DText(name, pya.DTrans(pya.DVector(x, YS + 0.75))))

# ================= core-level PDN =================
# TM1 power bars along the top edge (chip PDN landing): VDD y 133.0..135.2, VSS y 137.0..139.2
lib = pya.Library.library_by_name("SG13_dev", "sg13g2")


def pcell_via(b, t, cols=2):
    decl = lib.layout().pcell_declaration("via_stack")
    params = {p.name: p.default for p in decl.get_parameters()}
    params.update({"b_layer": b, "t_layer": t, "vn_columns": cols, "vn_rows": cols})
    return layout.create_cell("via_stack", "SG13_dev", params)


VS_M1_TM1 = pcell_via("Metal1", "TopMetal1")
VS_M2_TM1 = pcell_via("Metal2", "TopMetal1")
VS_TM1_TM2 = pcell_via("TopMetal1", "TopMetal2")


def place_vs(cell, x, y):
    bc = cell.dbbox().center()
    top.insert(pya.DCellInstArray(cell.cell_index(), pya.DTrans(pya.DVector(x - bc.x, y - bc.y))))


rect("tm2", -15.0, 133.0, 300.0, 136.0)                        # VDD bar (TM2)
rect("tm2", -15.0, 138.5, 300.0, 141.5)                        # VSS bar (TM2)
# logic strip TM1 stripes -> bars (VDD via a jog into the strap-band gap 140.9..153.3)
rect("tm1", LX + 17.78, 95.1, LX + 19.98, 98.4)                # VDD stripe extension up
rect("tm1", LX + 17.78, 96.2, 143.7, 98.4)                     # VDD jog east
rect("tm1", 141.5, 96.2, 143.7, 108.0)                         # VDD riser, low segment (clear of logic VSS stripe)
rect("tm1", 141.5, 105.8, 144.72, 108.0)                       # step east
rect("tm1", 142.52, 105.8, 144.72, 135.8)                      # VDD riser, high segment (clear of strap band 140.88)
place_vs(VS_TM1_TM2, 143.62, 134.5)
rect("tm1", LX + 23.98, 94.7, LX + 26.18, 102.4)               # VSS stripe extension up
rect("tm1", LX + 23.98, 100.2, 148.56, 102.4)                  # VSS jog east
rect("tm1", 146.36, 100.2, 148.56, 141.4)                      # VSS riser (crosses the VDD TM2 bar on TM1)
place_vs(VS_TM1_TM2, 147.46, 140.0)
# analog-core rails -> bars: VSS via the existing west M2 leg (-8.4, up to 131.0)
rect("m2", -8.6, 131.0, -8.2, 140.0)
place_vs(VS_M2_TM1, -8.4, 140.0)
place_vs(VS_TM1_TM2, -8.4, 140.0)
# VDD: M1 rail west end (-7.5) -> extend to -11.4, M1->TM1 stack at (-10.4, -5.3), TM1 riser up to the VDD bar
rect("m1", -15.0, -5.6, -7.5, -5.0)
place_vs(VS_M1_TM1, -13.4, -5.3)
rect("tm1", -14.6, -6.4, -12.2, 135.8)
place_vs(VS_TM1_TM2, -13.4, 134.5)
# pin boxes on the bars
rect("tm2", 300.0, 133.0, 300.5, 136.0)
rect("tm2", 300.0, 138.5, 300.5, 141.5)
top.shapes(L["tm2p"]).insert(pya.DBox(-15.0, 133.0, 300.5, 136.0))     # whole bar = pin
top.shapes(L["tm2l"]).insert(pya.DText("VDD", pya.DTrans(pya.DVector(142.0, 134.5))))
top.shapes(L["tm2p"]).insert(pya.DBox(-15.0, 138.5, 300.5, 141.5))
top.shapes(L["tm2l"]).insert(pya.DText("VSS", pya.DTrans(pya.DVector(142.0, 140.0))))

# ---- top-level analog/power pin exports (touch the acore7 pin metal)
XW, XE = -15.0, 300.5                                          # macro west/east boundaries
# vinp: bstrap_p vin band (67.5..70.6 @ -42.9) -> M3 west to the boundary
rect("m3", XW, -43.1, 68.1, -42.7)
top.shapes(L["m3p"]).insert(pya.DBox(XW, -43.1, XW + 1.5, -42.7))
top.shapes(L["m3l"]).insert(pya.DText("vinp", pya.DTrans(pya.DVector(XW + 0.75, -42.9))))
# vinn: bstrap_n vin band (219.4..222.5 @ -42.9) -> M3 east
rect("m3", 221.9, -43.1, XE, -42.7)
top.shapes(L["m3p"]).insert(pya.DBox(XE - 1.5, -43.1, XE, -42.7))
top.shapes(L["m3l"]).insert(pya.DText("vinn", pya.DTrans(pya.DVector(XE - 0.75, -42.9))))
# vcm: -9.82 band (133..169.8) -> M4 riser at 161.6 down to -45.5 -> M3 east to the boundary
rect("m3", 160.0, -10.02, 161.8, -9.62)
via3(161.6, -9.82)
v4wire(161.6, YS, -9.82)
top.shapes(L["m4p"]).insert(pya.DBox(161.4, YS, 161.8, YS + 1.5))
top.shapes(L["m4l"]).insert(pya.DText("vcm", pya.DTrans(pya.DVector(161.6, YS + 0.75))))
# clk: riser 119.9 @ y=100 -> M4 west across the main array to the boundary
via3(119.9, 100.0)
rect("m4", XW, 99.8, 120.1, 100.2)
top.shapes(L["m4p"]).insert(pya.DBox(XW, 99.8, XW + 1.5, 100.2))
top.shapes(L["m4l"]).insert(pya.DText("clk", pya.DTrans(pya.DVector(XW + 0.75, 100.0))))
# outn: bar (168.9..250 @ 110.2) -> M4 east across the replica array
via3(249.5, 110.2)
x1, y1 = snap(249.5 - 0.095), snap(110.2 - 0.095)
rect("v4", x1, y1, x1 + 0.19, y1 + 0.19)
rect("m5", 249.3, 110.0, XE, 110.4)                            # M5: crosses the topr M4 riser (299.3) on another layer
top.shapes(L["m5p"]).insert(pya.DBox(XE - 1.5, 110.0, XE, 110.4))
top.shapes(L["m5l"]).insert(pya.DText("outn", pya.DTrans(pya.DVector(XE - 0.75, 110.2))))

layout.write("oa_sar8_core12.gds")
b = top.dbbox()
print(f"core12: {b.width():.0f} x {b.height():.0f} um = {b.width()*b.height()/1e6:.3f} mm2")
