lmm2024/sar-adc-8b-open/(commit log)

2026-08-29 Publish core18 digital-async SAR ADC sign-off project
    [metrics.csv, pin_order.cfg, pin_order_async.cfg, sar_ctrl__nom_fast_1p32V_m40C.sdf, sar_ctrl__nom_slow_1p08V_125C.sdf, sar_ctrl__nom_typ_1p20V_25C.sdf, sar_ctrl_async_phys__nom_fast_1p32V_m40C.sdf, sar_ctrl_async_phys__nom_slow_1p08V_125C.sdf]
2026-08-30 release core18 PDN-fixed signoff evidence
    [samples_pdnfix_m3_lowfreq312k_2cyc.csv, samples_pdnfix_m3_signoff32_10m_t25.csv, samples_pdnfix_m3_signoff32_lowfreq312k.csv, sar_ctrl_async_phys__nom_fast_1p32V_m40C.sdf, sar_ctrl_async_phys__nom_slow_1p08V_125C.sdf, sar_ctrl_async_phys__nom_typ_1p20V_25C.sdf]
2026-08-30 add static transfer screening results
    [samples_dc257.csv]
